MBoldyrev/kurs_mark/pic/ext4.JPG

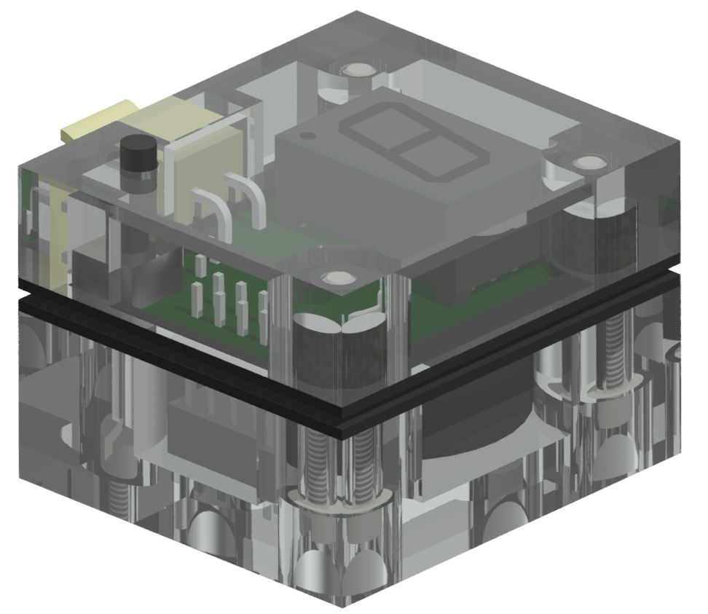
pic/ext4.JPG
