MBoldyrev/kurs_mark/pic/ext3.JPG

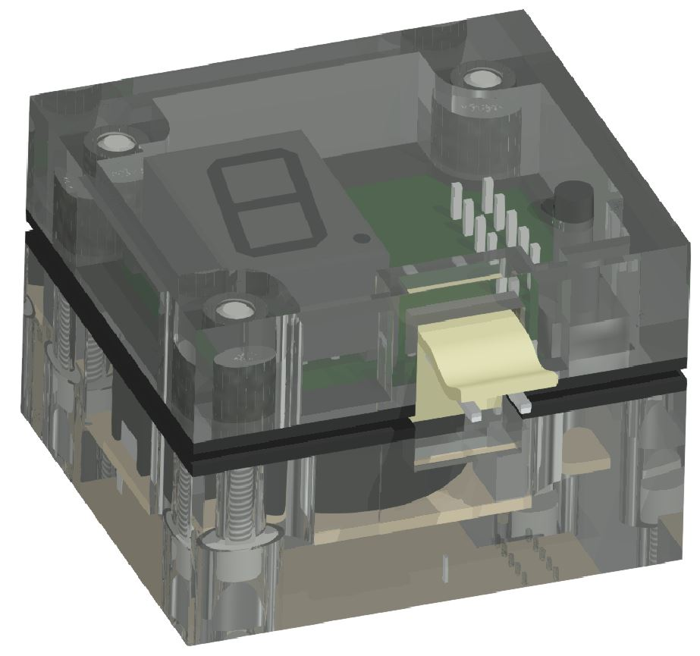
pic/ext3.JPG
