MBoldyrev/kurs_mark/PRINT/A4_bw/ext_spec.pdf

Изм. Лист | № докум. | Подп. | Дата
Разраб.
Пров.

Н.контр.
Утв.
Копировал | Формат А4

ИУ4.2205-12.03.01.00

Болдырев М.Д.
Маркелов В.В. | Наружный блок
Спецификация | МГТУ им. Н.Э.Баумана
группа ИУ4-73
Лит. | Лист | Листов

Инв. № подл. Подп. и дата Взам. инв. № Инв. № дубл. Подп. и дата Справ. № Перв. примен.

Формат
Зона
Поз.
Обозначение | Наименование | Примечание
| Документация

Кол.

ИУ4.2205-12.03.01.00СБ | Сборочный чертеж
ИУ4.2205-12.03.01.00ВО | Чертеж общего вида

Сборочные единицы

1 | ИУ4.2205-12.03.01.01.00 | Ячейка электронная для изготовления | 1
| | измерителя уровня топлива
2 | ИУ4.2205-12.03.01.02.00 | Батарейный держатель | 1
