MBoldyrev/kurs_mark/PRINT/A4_bw/PP1SB_spec.pdf

Изм. | Лист | № докум. | Подп. | Дата
| | Разраб. | Болдырев М.Д. Маркелов В.В. | | Ячейка электронная для изготовления измерителя уровня топлива Спецификация | Лит. | Лист | Листов
Пров. | | | | | | | 1 | 1

Н.контр.
Утв.
Копировал | Формат А4

ИУ4.2205.12-3.01.01

МГТУ им. Н.Э.Баумана
группа ИУ4-63

Инв. № подл. Подп. и дата Взам. инв. № Инв. № дубл. Подп. и дата Справ. № Перв. примен.

Формат
Зона
Поз.
Обозначение | Наименование | Примечание
| Документация

Кол.

ИУ4.2205.12-3.01.01.00СБ | Сборочный чертеж
ИУ4.2205.12-3.01.01.01 | Чертеж печатной платы
ИУ4.2205.12-3.01.01.00Э1 | Схема электрическая структурная
ИУ4.2205.12-3.01.01.00Э2 | Схема электрическая функциональная
ИУ4.2205.12-3.01.01.00Э3 | Схема электрическая принципиальная

Детали

1 | ИУ4.2205.12-3.01.01.01 | Печатная плата | 1
2 | R1...R7 | Bourns CRS0805JX200 | 7
3 | R8, R9 | Bourns CRS0805JX203 | 1
4 | R10 | Bourns CRS0805JX205 | 1
5 | R11 | Bourns CRS0805JX101 | 1
6 | MCU1 | AVR ATtiny24V-10SSU | 1
7 | DPY1 | BelLux Electronics BL-S56A-12UY | 1
8 | S1 | Switronic 0613HIM-130G-G | 1
9 | S2 | Bourns CRS0805JX000 | 1
10 | X1 | Connfly PLS-2 | 1
11 | X2 | Connfly PWL-2R | 1
12 | X3 | Connfly PLD-10 | 1
