MBoldyrev/kurs_mark/Inventor/plots/pdf/all_spec.pdf

Изм. Лист | № докум. | Подп. | Дата
Разраб.
Пров.

Н.контр.
Утв.
Копировал | Формат А4

ИУ4.2205-12.03.00.00

Болдырев М.Д.
Маркелов В.В. | Измеритель

## уровня топлива

Спецификация | МГТУ им. Н.Э.Баумана
группа ИУ4-73
Лит. | Лист | Листов

Инв. № подл. Подп. и дата Взам. инв. № Инв. № дубл. Подп. и дата Справ. № Перв. примен.

Формат
Зона
Поз.
Обозначение | Наименование | Примечание
| Документация

Кол.

ИУ4.2205.12-03.00.00СБ | Сборочный чертеж
ИУ4.2205.12-03.00.00ВО | Чертеж общего вида
ИУ4.2205.12-03.00.00 | РПЗ

Сборочные единицы

1 | ИУ4.2203.12-03.01.00 | Наружный блок
2 | ИУ4.2203.12-03.02.00 | Погружной датчик
