MBoldyrev/kurs_mark/Inventor/plots/pdf/corp_spec.pdf

Изм. Лист | № докум. | Подп. | Дата
| Разраб. | Болдырев М.Д. Маркелов В.В. | | Корпус наружного блока измерителя уровня топлива Спецификация | Лит. | Лист | Листов
| Пров.

Н.контр.
Утв.
Копировал | Формат А4

ИУ4.2205-12.03.01.00

МГТУ им. Н.Э.Баумана
группа ИУ4-73

Инв. № подл. Подп. и дата Взам. инв. № Инв. № дубл. Подп. и дата Справ. № Перв. примен.

Формат
Зона
Поз.
Обозначение | Наименование | Примечание
| Документация

Кол.

ИУ4.2205-12.03.01.00СБ | Сборочный чертеж

Детали

1 | ИУ4.2205-12.03.01.03 | Верхняя часть корпуса | 1
2 | ИУ4.2205-12.03.01.04 | Верхняя прокладка | 1
3 | ИУ4.2205-12.03.01.05 | Нижняя часть корпуса | 1
4 | ИУ4.2205-12.03.01.06 | Нижняя прокладка | 1

Стандартные изделия

5 | Винт М3х16 | 3 | ГОСТ 1491-80
