MBoldyrev/kurs_mark/Inventor/plots/pdf/ext_spec.pdf

Изм. Лист | № докум. | Подп. | Дата
Разраб.
Пров.

Н.контр.
Утв.
Копировал | Формат А4

ИУ4.2205-12.03.01.00

Болдырев М.Д.
Маркелов В.В. | Наружный блок
Спецификация | МГТУ им. Н.Э.Баумана
группа ИУ4-73
Лит. | Лист | Листов

Инв. № подл. Подп. и дата Взам. инв. № Инв. № дубл. Подп. и дата Справ. № Перв. примен.

Формат
Зона
Поз.
Обозначение | Наименование | Примечание
| Документация

Кол.

ИУ4.2205-12.03.01.00СБ | Сборочный чертеж
ИУ4.2205-12.03.01.00ВО | Чертеж общего вида

Сборочные единицы

1 | ИУ4.2205-12.03.01.01.00 | Плата печатная для изготовления 1
| | измерителя уровня топлива

Детали

2 | ИУ4.2205-12.03.01.02 | Батарейный держатель | 1
3 | ИУ4.2205-12.03.01.03 | Верхняя часть корпуса | 1
4 | ИУ4.2205-12.03.01.04 | Верхняя прокладка | 1
5 | ИУ4.2205-12.03.01.05 | Нижняя часть корпуса | 1
6 | ИУ4.2205-12.03.01.06 | Нижняя прокладка | 1

Стандартные изделия

7 | Винт М3х16 | 3 | ГОСТ 1491-80
