MBoldyrev/kurs_mark/RPZ_merged.pdf

Содержание

## Список условных обозначений, сокращений и терминов

SMD – surface mounted device (c англ. – прибор, монтируемый на поверхность);
ОПП – односторонняя печатная плата;
ПП | – печатная плата;
РЭА | – радио электронная аппаратура;
ТЗ | – техническое задание;
ТЭЗ | – типовой элемент замены;
ЭРЭ | – электрорадиоэлемент;
ЭС | – электронные средства;
Измеритель – «измеритель уровня топлива»

## 1. Введение

Работа посвящена разработке комплекта конструкторской документации для изготовления измерителя уровня топлива.

Бытовые устройства измерения уровня топлива широко представлены на рынке лишь в составе мототехники, в кмоплекте с которой они используются; тогда как отдельные универсальные устройства практически отсутствуют в продаже. Таким образм, актуальность данной работы обусловлена потребностью обладателей мототехники, некуомплектованной штатным датчиком топлива, легко получать данные о количестве топлива в баке.
Исходными данными для разработки являются электрическая принципиальная схема устройства и требования расширенного технического задания.
Целью разработки является создание работоспособного устройства с заданными характеристиками. Для ее достижения были поставлены следующие задачи:
- анализ исходных данных;
- выбор элементной базы, конструкции и материалов;
- проведение необходимых расчетов.

Результатом выполнения работы является разработанный комплект конструкторской документации для измерителя уровня топлива.

## 2. Расширенное техническое задание

### 2.1 Наименование и область применения изделия

Наименование прибора: «измеритель уровня топлива». В сферу применения разрабатываемого измерителя уровня топлива входят мотоциклы, не оборудованные штатным измерителем уровня топлива, а так же практически вся мелкая землеобрабатывающая техника.

### 2.2 Основание для разработки

Основанием для разработки устройства «измеритель уровня топлива» является задание на курсовой проект по курсу «Конструкторское проектирование ЭС».

### 2.3 Технические требования

2.3.1 Технические параметры.

В табл. 2.3.1.1 представлены технические характеристики обнаружителя:

Таблица 2.3.1.1 - Технические параметры.
Наименование параметра | Значение
Напряжение питания, В | 2..4
Потребляемый ток в активном режиме не более, мА | 200
Потребляемый ток в режиме ожидания не более, мА | 0,3
Размер печатной платы не более, мм | 40х40
Габаритные размеры электронного блока не более, мм | 60х60х40
Габаритные размеры датчика не более, мм | 250х50х50
Масса (вместе с элементами питания) не более, г | 100
Точность измерения уровня топлива не менее, % | 5

### 2.3.2 Принцип работы устройства

Принцип действия прибора основан на изменении ёмкости конденсатора при изменении объемного соотношения заполняющих его воздуха и топлива. В качестве датчика используется открытый конденсатор, состоящий из двух пластин, между которых может протекать топливо. Емкость такого конденсатора, полностью погруженного в топливо, будет в среднем в два раза больше, чем на воздухе. Измерение ёмкости конденсатора датчика производится засеканием времени, за которое он зарядится до некоторого напряжения через резистор.

### 2.3.3 Требования к надежности

Время работы прибора 1000 часов с гарантированной надежностью Рг = 0,95 в соответствии с ГОСТ 27.002-89.
Гарантийный срок эксплуатации - 36 месяцев со дня ввода устройства в эксплуатацию. Гарантийный срок хранения - 12 месяцев со дня изготовления устройства.

### 2.3.4 Требования к конструкции

Разрабатываемое устройство выполняется в виде одноплатного ТЭЗ, заключенного в пластмассовый корпус и датчика, подключенного к плате проводом.

### 2.3.5 Условия эксплуатации и группа жесткости

Измеритель уровня топлива должен соответствовать требованиям технического задания при воздействии следующих условий:
- напряжение питания прибора: постоянное 2..4В;
- вибрация до 100 Гц с ускорением до 10g;
- климатическое исполнение: УХЛ 3.1
- относительная влажность воздуха: 85% при температуре 25⁰С;
- температура окружающей среды: -20×С…+70°С (для ячейки) и -55°С…+125°С (для датчика);
- атмосферное давление 10⁵ Па.
Согласно ГОСТ 23752-79 для устройства определяется 2-ая группа жесткости.

### 2.3.6 Требования к транспортировке, хранению и маркировке

В силу своего предназначения, а, следовательно, конструкции, устройство относится к классу транспортируемой ЭА. Измеритель уровня топлива должен соответствовать требованиям технического задания при воздействии следующих условий при транспортировке:
- многократные удары: 10g длительностью 20 мс;
- температура окружающей среды: от -20⁰С до +45⁰С;
- вибрация до 200 Гц с ускорением до 20g;
- относительная влажность воздуха: 85% при температуре 25⁰С;
- атмосферное давление 10⁵ Па;
Измеритель уровня топлива при хранении должен быть уложен в поролоновую укладку внутри упаковки из гофрированного картона по ГОСТ 9142-90. Хранение осуществлять на стеллажах в сухом помещении (в соответствии с условиями хранения по ГОСТ 15150-69). В помещении для хранения не должно быть паров кислот и щелочей, а также газов, вызывающих коррозию и разрушающих изоляцию (условия хранения аппаратуры 5 группы по ГОСТ 15150-69).

Для маркировки прибора используется наклейка, содержащая наименование прибора «Датчик уровня топлива». Наклейка наносится на фронтальную часть корпуса.

### 2.3.7 Требования к материалам и комплектующим изделиям

Используемые материалы и готовые изделия на момент их использования должны иметь сроки хранения и сроки эксплуатации, соответствующие техническому заданию. Готвое изделие должно быть устойчиво к действию бензина марок АИ-91, АИ-93, АИ-95 по ГОСТ 2084-77, а также дизельного топлива марок Л и З по ГОСТ 305-82.

### 2.3.8 Требования к патентной чистоте

Патентная чистота должна быть обеспечена в отношении Российской Федерации и стран СНГ.

### 2.4 Экономические показатели

Для выпуска прибора "измеритель уровня топлива" установлен мелкосерийный тип производства с годовой программой выпуска 200 шт.

### 2.5 Порядок испытаний

Объект испытаний – разрабатываемый измеритель уровня топлива.
Цель испытаний – проверка соответствия характеристик разработанного устройства функциональным и отдельным иным видам требований, изложенным в техническом задании. Количественные характеристики, подлежащие испытанию:
1) сила тока питания устройства в активном режиме и режиме ожидания;
2) точность измерения уровня топлива.
Качественные характеристики, подлежащие испытанию:
1) качество визуального отображения температуры на индикаторе.

### Выводы

Разработанное расширенное ТЗ полностью удовлетворяет требованиям ГОСТ 25123-82, учитывающий порядок построения, изложения и оформления технического задания. В данном разделе были перечислены технические параметры измерителя уровня топлива; изложен принцип работы устройства; были разработаны требования к надежности, эксплуатации, транспортировке, хранению, маркировке, требования к материалам и компонентам, требования к конструкции и к патентной чистоте. В экономических показателях была дана годовая программа выпуска прибора, в заключение был приведен порядок испытаний прибора на соответствие характеристик требованиям, перечисленным в ТЗ.

## 3. Схемотехническая часть

### 3.1 Анализ электрической структурной схемы устройства

Устройство измеритель уровня топлива можно структурно разделить на несколько основных частей:
- Погружная часть измерителя;
- Наружная часть измерителя;
- Индикация;
- Кнопка управления.
Электрическая структурная схема устройства (ИУ4.02.01.00 Э1) представлена на рисунке 3.1.1:

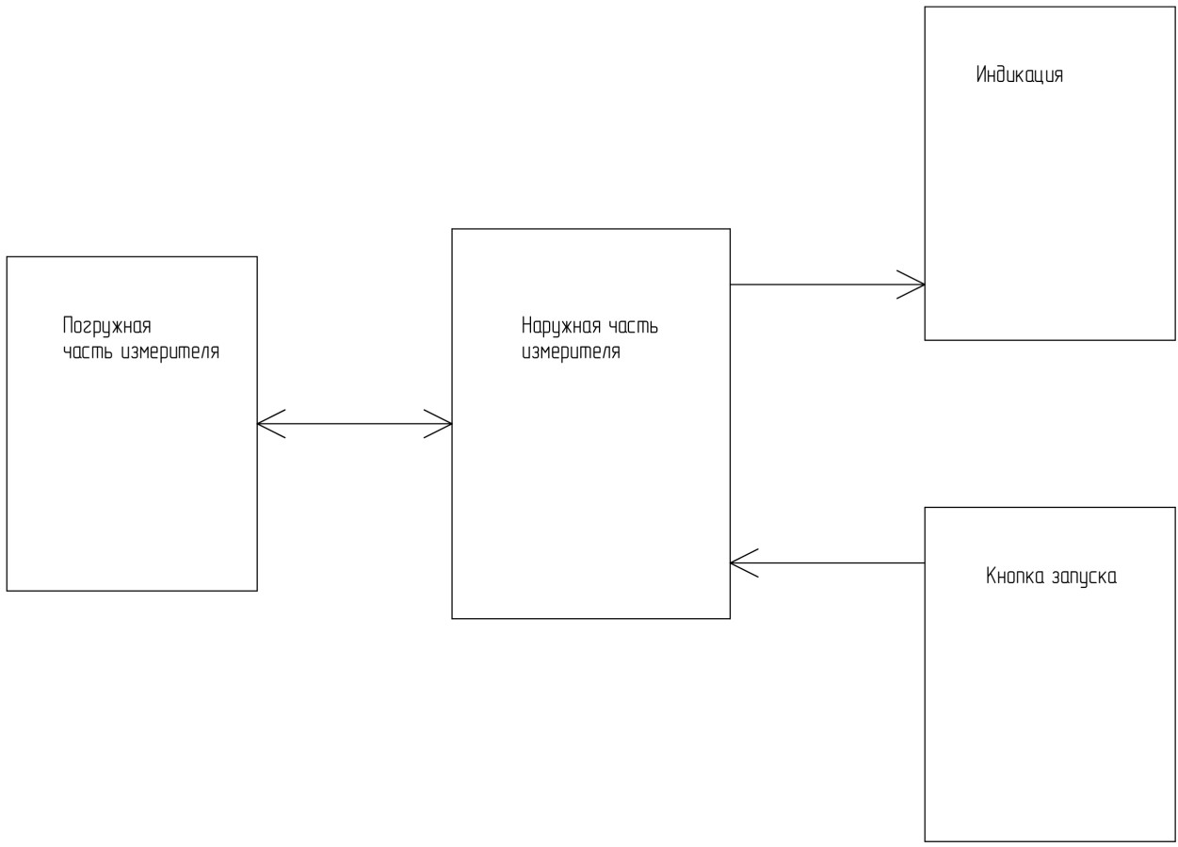
[picture p48: figure]

Рисунок 3.1.1. Схема электрическая структурная устройства

Погружная часть измерителья представляет собой открытый конденсатор, сообщающийся с наружной частью посредством проводов. Кнопка запуска и индикация служат для взаимодействия пользователя с устройством.

### 3.2 Анализ электрической функциональной схемы устройства

Устройство измеритель уровня топлива делится на следующие функциональные составляющие:
- Микроконтроллер;
- Генератор опорного напряжения;
- Датчик уровня топлива;
- Семисегментный индикатор.
Электрическая функциональная схема устройства (ИУ4.02.01.00 Э2) представлена на рисунке 3.2.1.

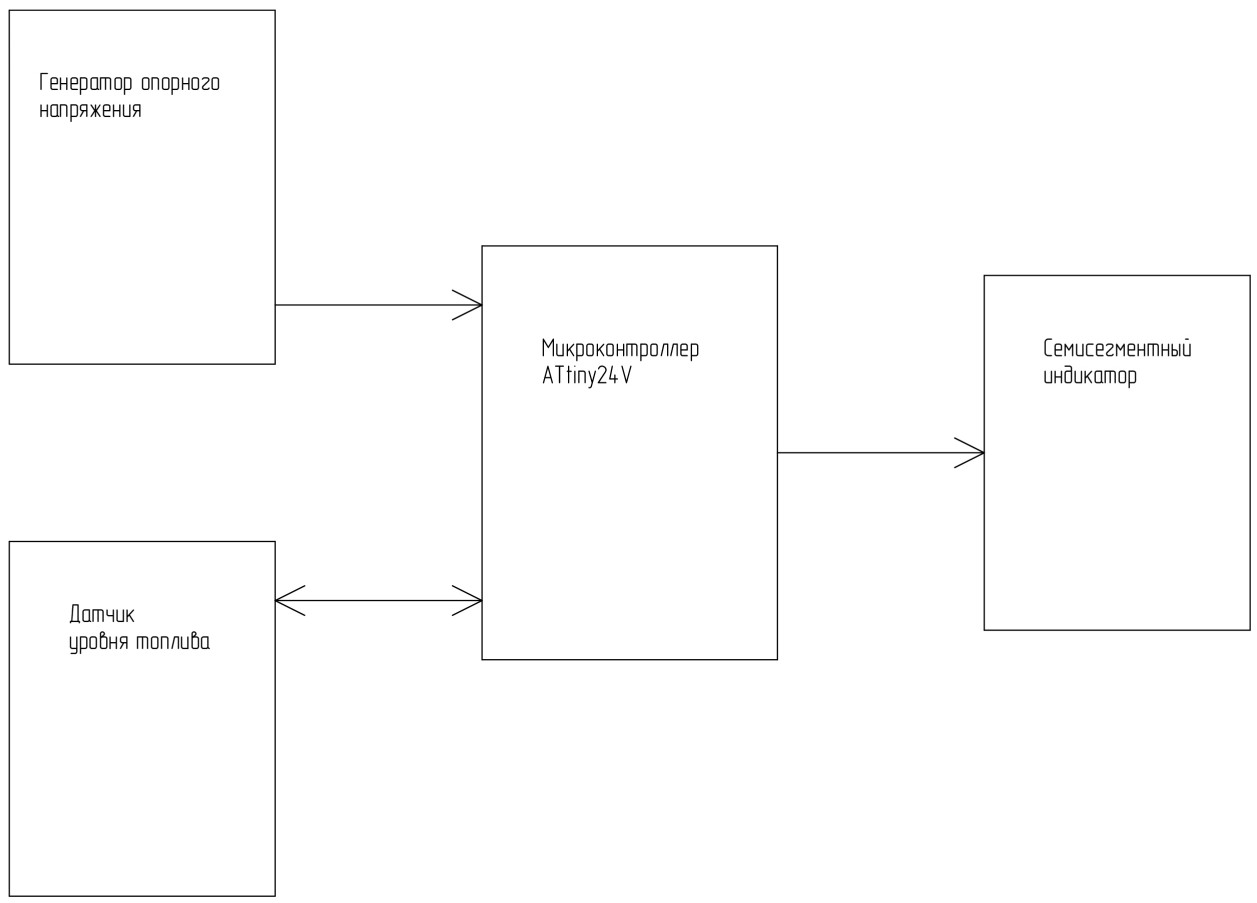
[picture p49: figure]

Рисунок 3.1.2. Схема электрическая функциональная устройства

По нажатию кнопки микроконтроллер начинает замер скорости разрядки конденсатора, после чего вычисляет относительную заполненность бака и выводит результат на семисегментный индикатор.

### 3.3 Анализ электрической принципиальной схемы устройства

Электрическая принципиальная схема (ИУ4.02.01.00 Э3) представлена на рисунке 3.3.1.

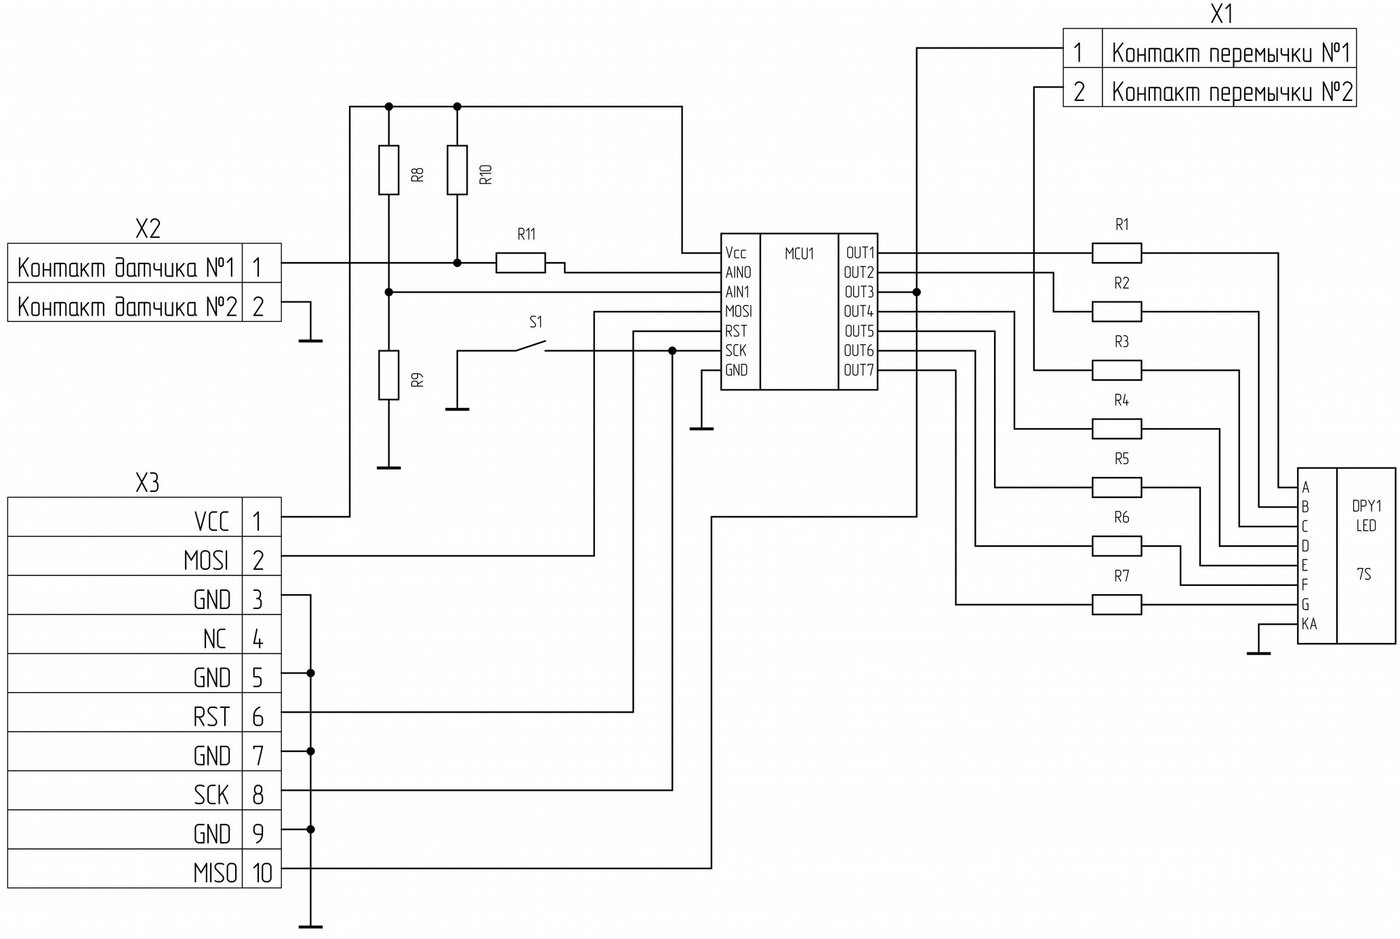
[picture p50: figure]

Рисунок 3.3.1. Схема электрическая принципиальная устройства

Программирование и питание схемы осуществляется посредством разъема X3. Линия тактовой частоты используется также для подключения кнопки, которая не используется при программировании контроллера. Также линия программирования MISO используется вне режима программирования для подключения одного из светодиодов индикации посредством перемычки. Светодиоды индикации подключены через токоограничивающие резисторы. На резисторах R8, R9 собран делитель для получения опорного напряжения компаратора. К разъему X2 подключается внешний датчик. Его конденсатор подключен к выводу микроконтроллера и к напряжению питания через два резистора R10, R11, на несколько порядков отличающихся по номиналу. Через один из них происходит изначальная быстрая разрядка, а через другой — медленная зарядка конденсатора.

### 3.4 Функциональное предназначение ЭРЭ

В качестве микроконтроллера MCU1 выбрана микросхема ATtiny24V фирмы Atmel. Резисторы R1..R7 ограничивают ток через светодиоды индикатора DPY1. Резисторы R8, R9 образуют делитель для получения опорного напряжения компаратора. Резистор R10 служит для медленной зарядки конденсатора датчика, а резистор R11 – для быстрой разрядки и измерения напряжения на конденсаторе. Ключ S1 используется для управления работой устройства. Индикатор DPY1 используется для вывода информации. Перемычка разъема X1 используется для переключения между режимами программирования и штатной работы устройства.

### 3.5 Анализ элементной базы

В целях удешевления конструкции и уменьшения габаритных размеров устройства все резисторы выбраны типа SMD0805. Микроконтроллер выбран в корпусе SO14.
Разъем датчика выбран угловой с фиксирующей защелкой для удобства монтажа и демонтажа. Разъемы X1, X3 выбраны прямыми штыревыми для уменьшения габаритов. Кнопка S1 - тактовая с высотой, превышающей высоту имеющихся на плате разъемов на толщину верхней крышки корпуса.
Таким образом, элементная база прибора состоит из недорогих надежных компонентов.
Эксплуатационные | параметры | компонентов | соответствуют | условиям | эксплуатации,
оговоренным в ТЗ.
В табл. 3.5.1 приведён перечень основных элементов устройства и их характеристик.

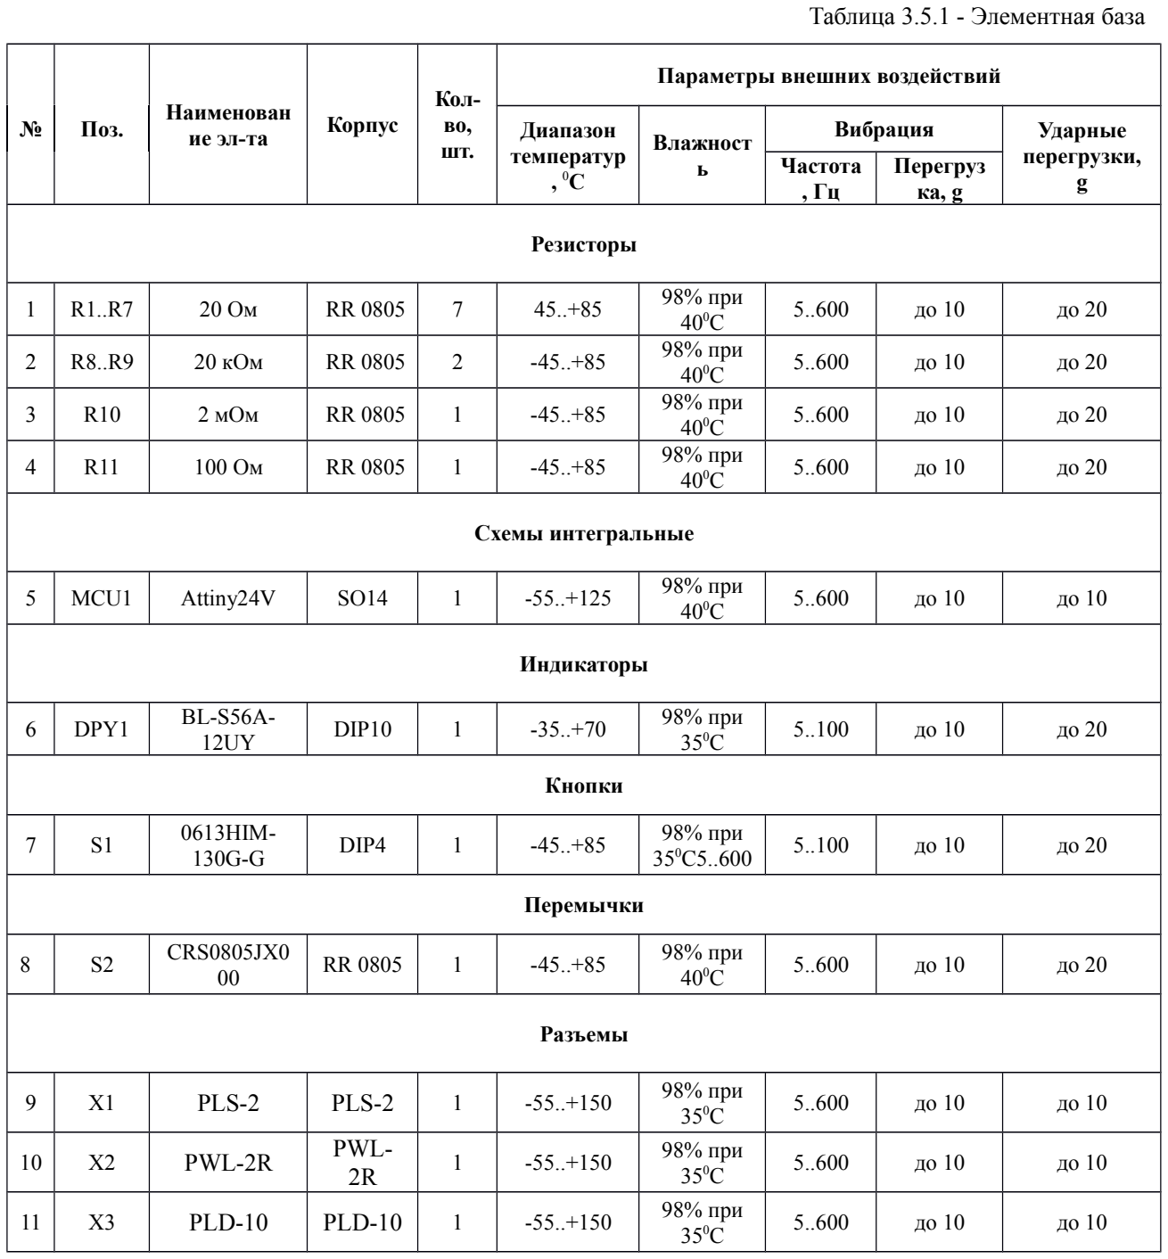
[picture p51: figure]
Таблица 3.5.1 - Элементная база; Наименован ие эл-та; Корпус; Кол- во, шт.; Параметры внешних воздействий; Поз.; Диапазон; температур ,; Влажност ь; Вибрация; Ударные; перегрузки, g; Частота , Гц; Перегруз ка, g; Резисторы; 98% при; 20 кОм; 2 мОм; Схемы интегральные; MCU1; Attiny24V; Индикаторы; DPY1; DIP10; 98% при 35⁰С; Кнопки; 0613HIM-; DIP4; Перемычки; CRS0805JX0; Разъемы; PLS-2; PWL-2R; PWL-; PLD-10

С учетом анализа элементной базы нормальные условия для устройства:
- диапазон температур: -35…+70⁰С;
- относительная влажность воздуха: 98% при температуре 25⁰С;
- вибрация до 400 Гц с ускорением до 10g;
- ударные перегрузки: до 10g.
Из анализа элементной базы можно сделать вывод, что данный элементный состав устройства обеспечивает его функционирование в условиях, описанных в ТЗ (температура хранения/эксплуатации, влажность и т.п.).

### 3.6 Описание работы схемы с помощью временных диаграмм

Моделирование работы устройства

1. Расчет емкости конденсатора датчика.

Датчик представляет собой открытый конденсатор, собранный из двух параллельно подключенных конденсаторов. Данная схема использована для увеличения емкости конденсатора и, следовательно, чувствительности датчика, при незначительном увеличении его габаритов в сравнении с вариантом, изготовленным из одного конденсатора. Стенки конденсаторов образуют пластины из стеклотекстолита фольгированного СТФ-1-15 шириной 40 мм и длиной 250 мм. Зазор между пластинами выбран наименьшим, при котором поверхностное натяжение бензина не препятствует его вытеканию из конденсатора, и составляет 1 мм. Таким образом, расчетная емкость полученного конденсатора на воздухе составляет

Св=2 * ε0

* εв

*

a* b
d

≈ 177 пФ ,

где ε0

– электрическая постоянная, εв

– диэлектрическая проницаемость воздуха, a и b –

ширина и длина пластин соответственно, d – зазор между пластинами. Емкость конденсатора, полностью погруженного в бензин АИ-92 составляет

СА И−92=Св

*

ε А И−92
εв

≈ 407 пФ ,

где ε А И−92

– диэлектрическая проницаемость бензина АИ-92.

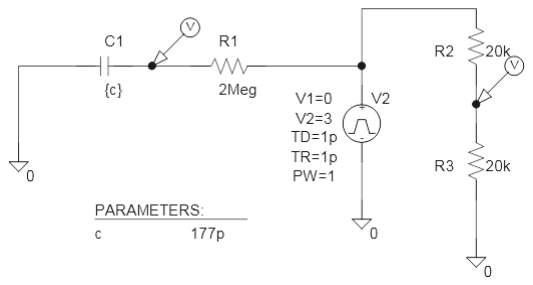
[picture p52: figure]

Рисунок 3.6.1 – схема моделирования датчика

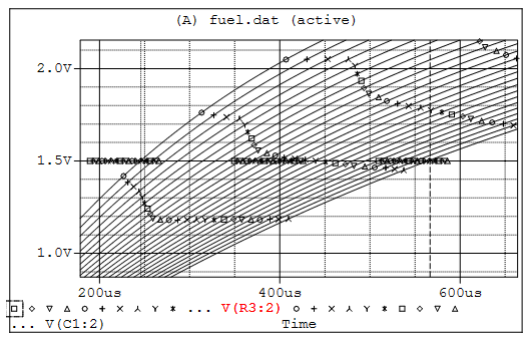
[picture p53: figure]

а | б
Рисунок 3.6.2 – Графики заряда конденсатора.

На рисунке 3.6.1 представлена схема моделирования измерительной части устройства в программе PSpice. Конденсатор С1 моделирует погружной датчик. На рисунке 3.6.2(а) представлен график напряжения на конденсаторе в сравнении с опорным напряжением на делителе во времени. Курсор установлен на пересечении кривых в момент времени 245 мкс. На рисунке 3.6.2(б) показано, как изменяется время заряда конденсатора С1 до опорного напряжения при последовательном изменении его емкости на 10 пФ.

Полученные результаты измерения времени заряда конденсатора до опорного напряжения составляют 245 мкс для пустого бака и 565 мкс для заполненного бензином АИ-92. Для повышения точности измерения целесообразно выбрать достаточно большую частоту работы контроллера, что гарантирует большую частоту дискретизации аналогового сигнала датчика и, следовательно, более точный замер времени. Выбранная мной частота составляет 1 МГц. Пересчет времени заряда конденсатора для полученных выше значений даст 245 и 565 тактов для пустого и полного бака соответственно. Это значит, что в идеальных условиях я получу 320 градаций наполненности бака. Такая точность на порядок превышает необходимую, поскольку индикация будет производиться всего 12 символами, соответствующими 12 градациям наполненности бака.
ВЫВОД

Результаты моделирования подтверждают работоспособность выбранной схемы для измерения уровня топлива с заданной точностью.

## 4. Конструкторская часть

### 4.1 Предварительная разработка и компоновка конструкции устройства

Компоновка электронного устройства - процесс размещения ЭРЭ и деталей РЭА на плоскости или в пространстве с определением основных геометрических форм и размеров. При компоновке должны быть учтены требования оптимальных функциональных связей, их устойчивость и стабильность, требования прочности и жесткости, помехозащищенности и нормального теплового режима, требования технологичности, эргономики, удобства эксплуатации и ремонта. Размещение комплектующих элементов должно обеспечивать равномерное и максимальное заполнение конструктивного объема с удобным доступом для осмотра, ремонта и замены.
Ввиду малого числа элементов внешнего блока измерителя, а также соображений простоты и дешевизны изготовления, схема внешнего блока реализуется на одной плате. Сам внешний блок реализуется в виде пластикового корпуса, в котором расположена плата, выведен наружу разъем подключения погружного датчика и элемент пользовательского интерфейса — кнопка.

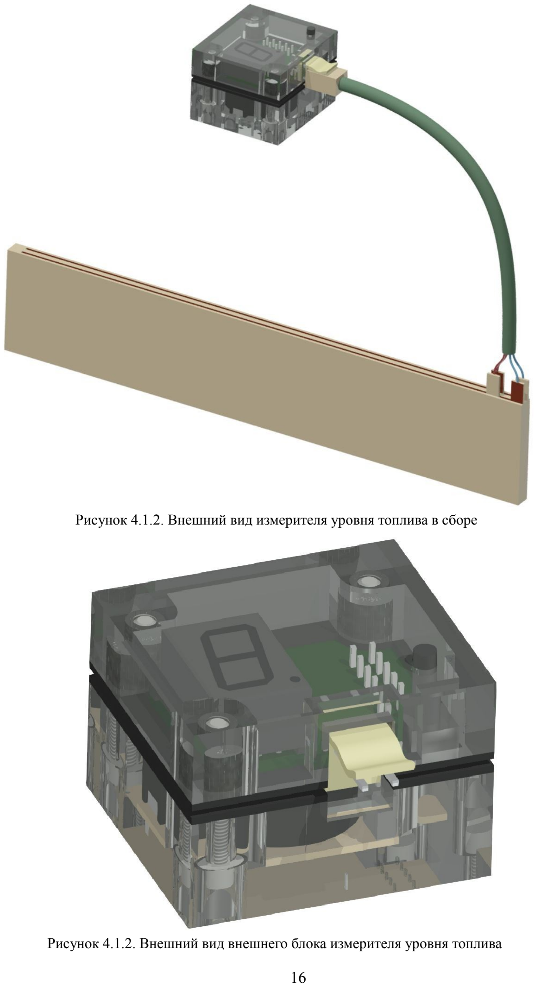
[picture p54: page 16]

Рисунок 4.1.2. Внешний вид измерителя уровня топлива в сборе

Рисунок 4.1.2. Внешний вид внешнего блока измерителя уровня топлива

### 4.2 Описание конструкции блока

Измеритель уровня топлива представляет собой устройство, состоящее из погружного датчика и наружного блока. Погружной датчик предназначен для монтажа внутрь бензобака. Наружный блок предназначен для монтажа на поверхность бензобака возле горловины. Блоки стыкуются между собой при помощи кабеля.
Конструкция устройства представлена на сборочном чертеже устройства (ИУ4.2205-12.00.00 СБ), приведенном на рисунке 4.2.1.

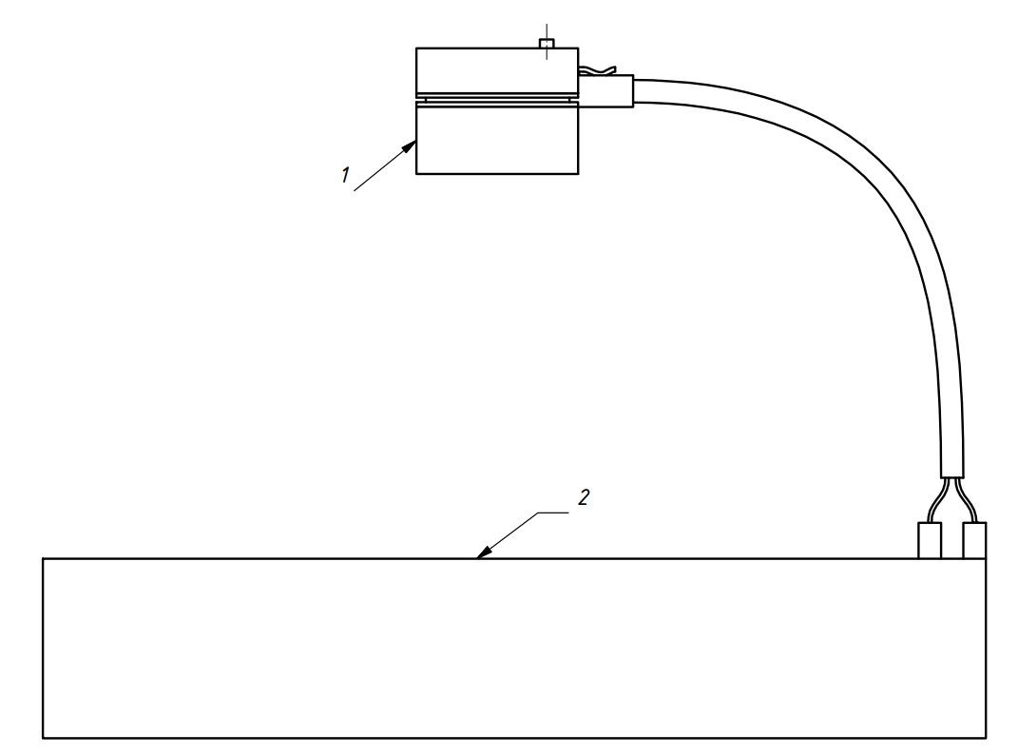
[picture p55: figure]

Рисунок 4.2.1 - Сборочный состав устройства

Сборочный чертёж внешней части устройства представлен на рисунке 4.2.2. Основой его конструкции является пластиковый корпус, состоящий из нижней и верхней части. Для защиты от попадания внутрь корпуса топлива и воды применены резиновые прокладки, устанавливаемые между платой и частями корпуса.

Для корректной установки элементов питания (2 батареек типа ААА) поз. 11 в нижней части корпуса применяется гравировка на пластмассе с указанием полярности установки батареек.

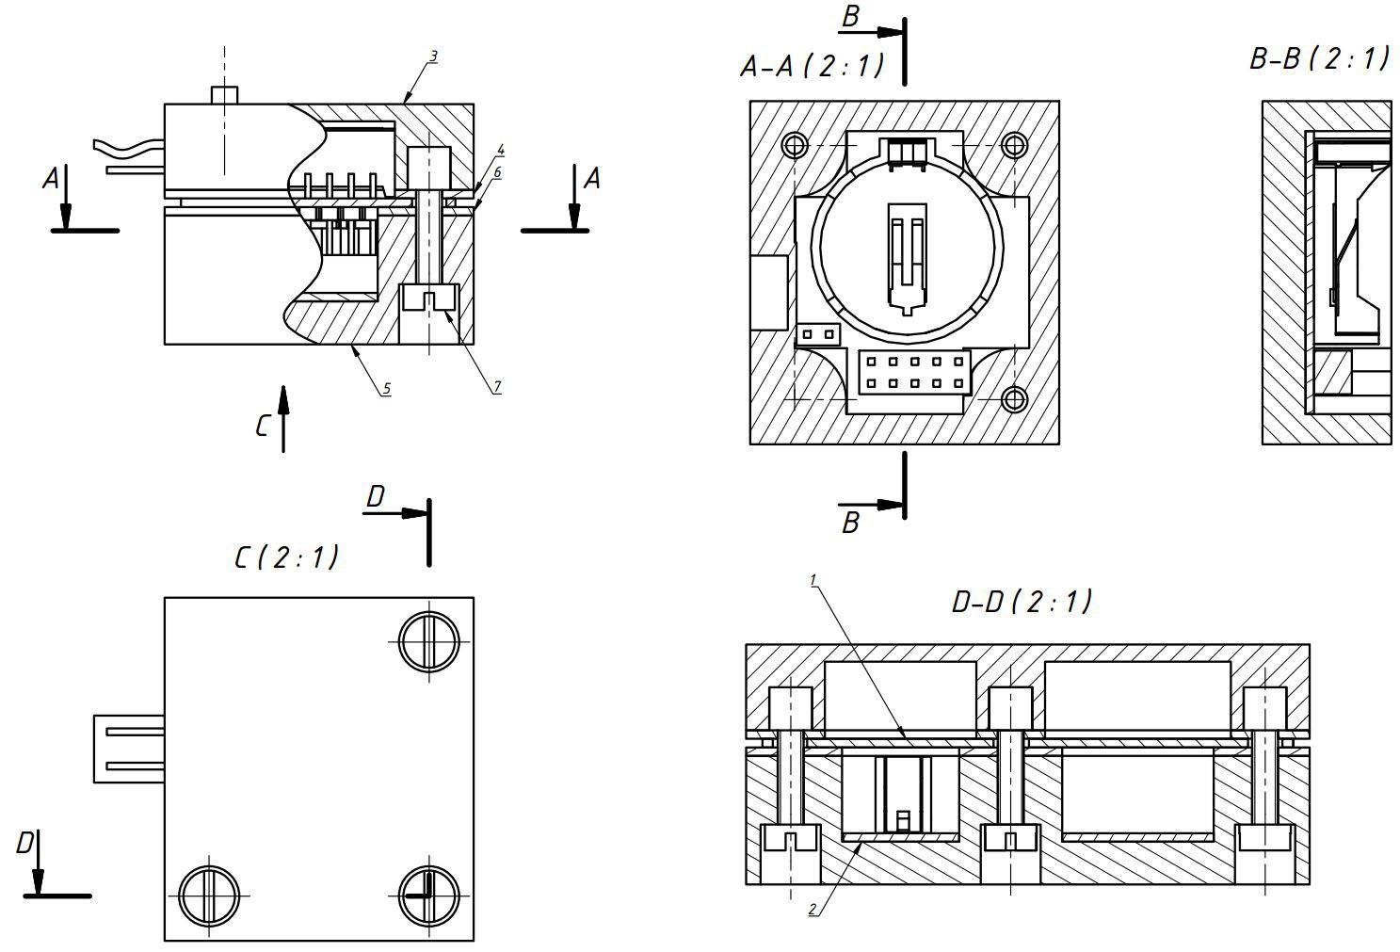
[picture p56: figure]

Рисунок 4.2.2. Нижняя часть корпуса

В нижнюю часть корпуса прибора устанавливается электронная ячейка (поз. 2), которая приклеивается к нижней стенке корпуса. Затем устанавливается нижняя прокладка (поз. 6), электронная ячейка (поз. 1), верхняя прокладка (поз. 4) и верхняя часть корпуса (поз. 3). Все стягивается тремя винтами (поз. 7).

### 4.3 Анализ и выбор конструкции и материала ячейки

По количеству слоёв проводящего материала ПП бывают односторонние, двусторонние и многослойные. Поскольку форма и количество ЭРЭ позволяет получить плату с габаритными размерами, удовлетворяющими ТЗ при использовании односторонней печатной платы, использоваться будет односторонняя ПП.
ПП разделяют по гибкости на жёсткие и гибкие. Поскольку плата с элементами являет собой ячейку ТЭЗ и должна выдерживать ударные и вибрационные нагрузки, используется жесткая печатная плата.
Исходя из вышеприведенных решений, а также соображений экономичности выбран материал ПП: СФ-1-35Г-1 II кл. по ГОСТ 10316-78 — гетинакс толщиной 1 мм, облицованный с одной стороны медной электролитической гальваностойкой фольгой толщиной 35 мкм. Готовая плата соответствует требованиям ГОСТ 23752-79 и ГОСТ 23751-86, относится к 1-ому классу жесткости и 3-ему класс точности.
Шаг координатной сетки 0,635 мм.
Выбранный материал имеет следующие параметры (характеристики указаны для состояния материала после выдержки в условиях 96 ч/40°С/93%):
1) поверхностное электрическое сопротивление (Ом): 5·10¹⁰;
2) удельное объемное электрическое сопротивление (Ом х м): 1·10¹⁰;
3) тангенс угла диэлектрических потерь при частоте 1 МГц: 0,035;
4) диэлектрическая проницаемость при частоте 1МГц: 5,5;
5) время устойчивости к воздействию теплового удара при t= 260оС (с): 30. Адресация ЭРЭ выполняется белой эпоксидной маркировочной краской МКЭЧ ОСТ 4ГО.054.205 У1 шрифтом 2 по ТУ 15-203.200-95.

### 4.4 Анализ и выбор материала корпуса прибора

Согласно требованиям ТЗ внешняя часть измерителя монтируется вне бензобака и должна быть защищена от механических и химических воздействий извне. Этой цели удовлетворяет корпус, представленный на рисунке 4.2.2. Данный корпус изготовлен из полиамида 610 литьевого ГОСТ 10589-87 - прозрачной пластмассы, стойкой к воздействию горюче-смазочных материалов при требуемом по ТЗ диапазоне температур и влажности. Корпус является закрытым, негерметичным. Корпус выполнен литьем пластмассы под давлением. Прозрачность материала корпуса позволяет избежать необходимости применения вставок других материалов для изготовления прозрачного окна для наблюдения показаний индикатора. Это в свою очередь избавляет конструкцию от напряжений, связанных с различной упругостью и температурным расширением материалов составных частей. Также прозрачный корпус позволяет легко проверять наличие на месте питающего элемента и диагностировать некоторые возможные неисправности.
Выбранный материал имеет следующие параметры:
- | Плотность при 23 °С: | 1,1 г/см3;
- | Прочность при растяжении: | 130 МПа
- | Прочность при изгибе: | 90 МПа
- | Модуль упругости: | 7000-9000 МПа
- | Твердость по Бриннелю, МПА: | 100-150
- | Температура начала деформации при 1,82 МПа: | 190-200 °С
- | Температура начала деформации при 0,45 МПа: | 200-205 °С
- | Водопоглощение за 24 ч в воде при 23 °С: | 0,3 %
- | Усадка при 23 °С: | 0,8-1,5 %
- | рабочая температура: | -40..+90 °C.
- удельное электрическое сопротивление (поверхностное):10¹² Ом/см;
- | удельное электрическое сопротивление (объёмное): | 10¹² Ом/см;

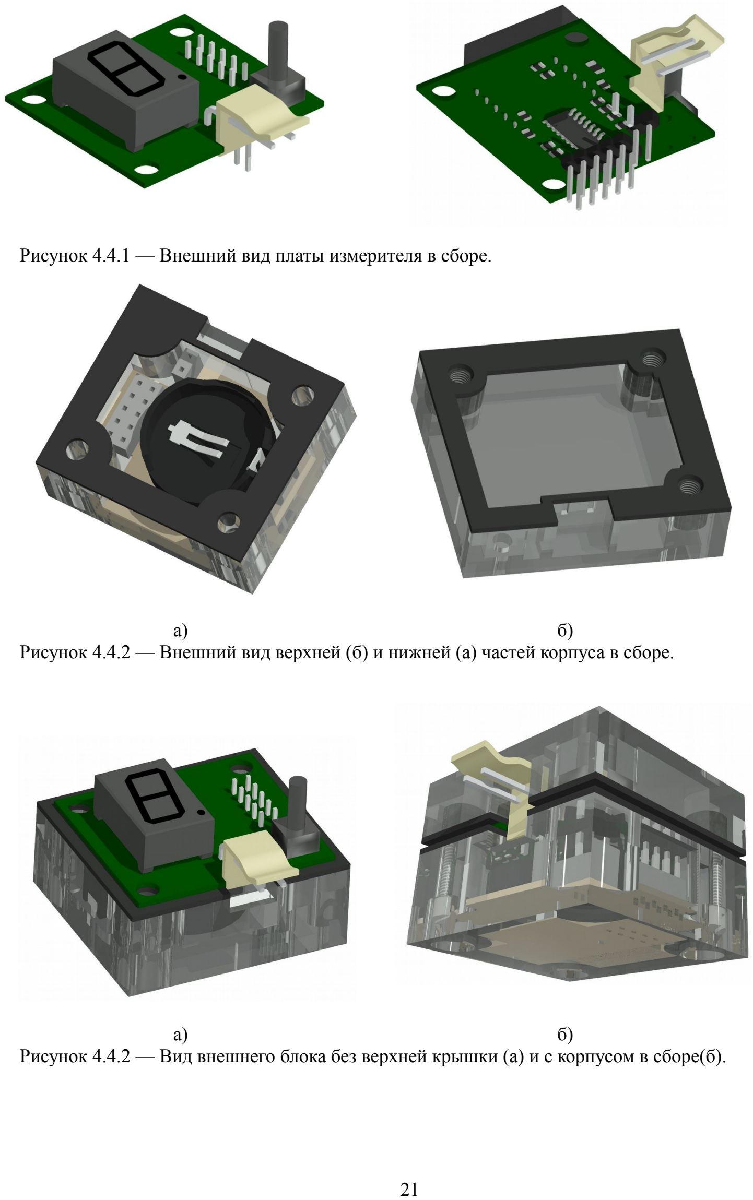
[picture p57: page 21]

Рисунок 4.4.1 — Внешний вид платы измерителя в сборе.

а) | б)
Рисунок 4.4.2 — Внешний вид верхней (б) и нижней (а) частей корпуса в сборе.
а) | б)
Рисунок 4.4.2 — Вид внешнего блока без верхней крышки (а) и с корпусом в сборе(б).

### 4.4 Выбор соединений

В данном устройстве применены следующие виды соединений:
а) Винтовое соединение. Винтовое соединение применяется для разъемного соединения обеих частей корпуса и платы. Винты могут быть откручены пользователем устройства для установки или замены питающего элемента.
б) Соединение заформовкой. Заформовка применяется для фиксации бонок в верхней части корпуса. Данное соединение должно быть неразборным и достаточно надёжным, что может быть обеспеченно данным видом соединения.
в) Соединение пайкой. Данное соединение применяется как для механического закрепления ЭРЭ на плате, так и для создания электрического контакта между выводами ЭРЭ и проводящим рисунком ПП.
г) Соединение разъёмное штыревое. Применено для соединения погружного датчика с внешним блоком. Обеспечивает электричемкий контакт и механическую фиксацию шнура в разъёме корпуса.

### 4.5 Обеспечение устойчивости к внешним воздействиям

### 4.5.1 Тепловое воздействие

Для выбора способа защиты от перегрева необходимо рассчитать суммарную рассеиваемую мощность устройства. Полная рассеиваемая мощность есть сумма мощностей рассеивания всех ЭРЭ:

(4.1)
Расчет максимальных рассеиваемых мощностей ЭРЭ:
а) резисторы R1..R7 и индикатор DPY1 – при постоянно включенных 7 сегментах индикатора:
PR 1..7, DPY1=7⋅(5В⋅4 мА)=140 мВт б) резисторы R8..R9:

PR8. .9=2⋅(
(2,5В)

2

20 кОм ) =0,15 мВт

Мощность, рассеиваемая на этих резисторах, мала в сравнении с остальными, поэтому далее она не учитывается.
в) резисторы R10..R7 – при максимальной емкости конденсатора (при использовании бензина АИ95 - 420 пФ):

PR10..11=2⋅

420пФ⋅3 В
565 мкс

=4,5 мВт

г) микроконтроллер MCU1 при непрерывном измерении:
PMCU 1=45 мВт
Результаты расчета максимальных рассеиваемых мощностей для выше приведенных ЭРЭ представлены в таблице 4.5.1.
Таблица 4.5.1 – Мощность, рассеиваемая ЭРЭ

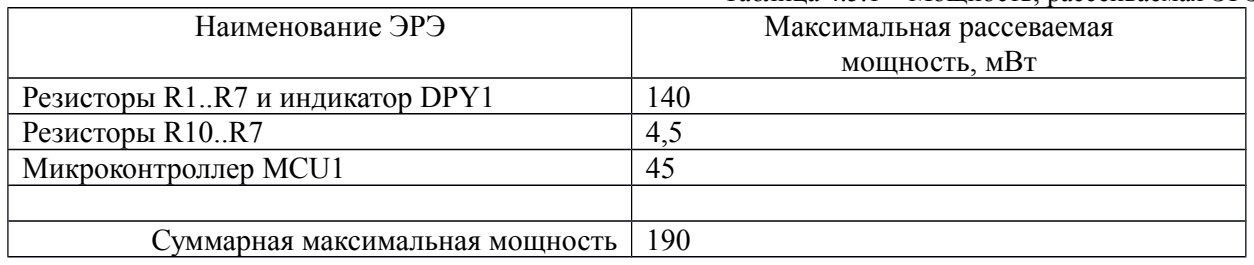
[picture p58: figure]
Наименование ЭРЭ; Максимальная рассеваемая; мощность, мВт; Резисторы R1..R7 и индикатор DPY1; Резисторы R10..R7; Микроконтроллер MCU1; Суммарная максимальная мощность 190

Конденсаторы и печатные проводники тепло практически не рассеивают и в расчете они не учтены.
Расчет показал, что в условиях, обеспечивающих максимально возможную рассеиваемую мощность, ее значение составляет порядка 0,2 Вт. Следовательно, устройство не требует специальной системы охлаждения. Теплонагруженные элементы охлаждаются за счет естественной конвекции воздуха, теплопроводности печатной платы и корпуса и излучения. Все элементы схемы, а также материал корпуса были подобраны в соответствии с ограничениями ТЗ (рабочая температура и температура хранения до 45°С).

### 4.5.2 Охлаждение

Устройство защищено от переохлаждения правильным согласованием материалов, из которых изготовлена печатная плата и элементы корпуса.
Все элементы схемы, а также материал корпуса были подобраны в соответствии с ограничениями ТЗ (рабочая температура до -10°С, температура хранения до -20°С), чем обеспечивается защита от холода.

### 4.5.3 Вибрация и удары

Минимизация искривлений печатных плат обеспечена равномерным распределением нагрузки на них и высокой плотностью установки компонентов.
Все элементы схемы, а также материал корпуса были подобраны в соответствии с ограничениями ТЗ на возможные вибрации и удары.

### 4.5.4 Влажность

Материал корпуса подобран в соответствии с требованиями ТЗ по необходимому сопротивлению воздействия влажности.
Поскольку корпус не герметичен, его содержимое — плата и ЭРЭ — нуждаются в самостоятельном обеспечении сопротивления влажности. С этой целью собранная ячейка полностью покрывается лаком УР-231 (ТУ 6-21-14-90), который подходит под требования ТЗ.

### 4.5.5 Электромагнитные помехи

Погружной датчик представляет собой открытый конденсатор, который располагается внутри металлического бензобака, являющегося хорошим электромагнитным экраном. Благодаря этому возможные наводки на конденсатор датчика становятся незначительными. Шнур, соединяющий конденсатор датчика с внешним блоком, содержит два проводника, идущих близко друг к другу, что позволяет игнорировать возможные наводки ввиду того, что наведенные помехи будут одинаковы на обоих проводниках, и не повлияют на разность напряжений и токов в них.
Плата внешнего блока имеет малые габаритные размеры и не содержит индуктивных элементов, благодаря чему воздействие возможных помех не внесет ощутимых изменений в работу устройства.

### 4.6 Расчеты

### 4.6.1 Расчет ПП

### 4.6.1.1 Расчет печатного монтажа

Разрабатываемая плата относится к 2 классу точности. Это позволяет изготавливать плату устройства на наиболее распространенном оборудовании без затрат на избыточную точность.
Выбранному классу точности при вышеприведенных параметрах платы соответствуют следующие величины:
t = 0,25 мм — минимальная ширина проводников;
S = 0,25 мм — минимальная ширина зазора между проводниками;
b = 0,2 мм — гарантированный поясок;
Δt = 0,10 мм — допуск на ширину проводника;
Δdдо 1 = 0,10 мм — допуск на диаметр отверстя до 1 мм;
Δdсв.1 = 0,15 мм — допуск на диаметр отверстя свыше 1 мм;

Разрабатываетмая плата — односторонняя и не содержит металлизированных отверстий. Исходя из принятых параметров платы целесообразно назначить химический способ получения проводящего рисунка.

Минимальный диаметр монтажного отверстия определяется из соотношения:

d м.о.≥dв+Δ+δд
(4.2)
где dв - диаметр вывода ЭРЭ, микросхемы или соединителя,
Δ - зазор между выводом и монтажным отверстием,
δд - максимальная погрешность диаметра отверстия.
Подставив имеющиеся значения в (4.2), получим минимальные диаметры монтажных отверстий для каждого значения диаметра вывода, представленные в таблице 4.6.1.
Таблица 4.6.1.1.1 - Диаметры монтажных отверстий под ЭРЭ
ЭРЭ монтирующиеся в отверстия | Диаметр вывода dв, мм | Минимальный диаметр монтажного отверстия dм.о.мин, мм | Выбранный диаметр монтажного отверстия dм.о., мм
DPY1 | 0,6 | 0,9 | 0,9
X1, X3 | 0,8 | 1,15 | 1,2
X2, S1 | 1 | 1,35 | 1,4

Расчет эффективного диаметра контактной площадки производится по формуле:

D1min=2(bM
+

dmax
2

+δ отв

+δ к.п .) =dсв+Δ d+0,96 , где

bм = 0,2 мм,
dсв=d м. о .+0.15=1.4

dmax=dсв+Δd

δ отв=δ о

+δδ=0,13 - смещение центра монтажного отверстия относительно координатной сетки,

δ к.п .=δ ш+δэ+

1/2(δп+δз)=0,15 - смещение центра контактной площадки относительно

координатной сетки,
Dmin=D1 min+1 .5 hф=D1 min+0,05

Dmax=Dmin+2 ΔЭ+Δ Dш=Dmin+0,09

Таблица 4.6.1.1.2 - Диаметры контактных площадок под ЭРЭ

ЭРЭ монтирующие ся в отверстия | Диаметр отверстия dм.о., мм | Минимальный диаметр КП Dmin, мм | Максимальный диаметр КП Dmax, мм | Диаметр КП фотошаблона Dш, мм
DPY1 | 0,9 | 1,1 | 1,19 | 1,15
X1, X3 | 1,2 | 1,45 | 1,54 | 1,50
X2, S1 | 1,4 | 1,65 | 1,74 | 1,70

tmin=t

1min+1.5hпм=0,25+1,5⋅0,035=0,3
При t = 0,5:
t max=t +2 ΔЭ+ Δtш=0,6
Ширина проводника t=0,5 мм подходит под ограничения ТЗ.
Минимальное расстояние которое может быть получено между проводником и монтажным отверстием с контактной площадкой и между двумя проводниками возьмем равным рассчитанной ширине проводника: 0,4 мм. Разработанная плата не содержит узких мест с расстоянием между элементами проводящего рисунка между собой и краями платы меньше 0,5 мм, что подходит под выбранный класс точности и метод изготовления.

### 4.6.1.2 Расчет по постоянному току

Падение напряжения на проводнике:

где ρ - удельное сопротивление проводника, ρ=0,017 Ом∗мм

2
/м
hф - толщина фольги, мм
bпр - ширина проводника, мм
l- длина проводника, м
I – ток, А
Наибольшее падение напряжения во всей схеме имеет место на проводниках питания контроллера MCU1, поскольку эти проводники — самые длинные на всей плате, и через них течет самый большой ток (один и тот же). Максимально возможное падение напряжния на проводнике положительного полюса питания:

Uп=

0,03⋅0,017⋅0,006
0,035⋅0,5

=0,00017B

Максимально возможное падение напряжния на проводнике отрицательного полюса питания:

Uп=

0,03⋅0,017⋅0,005
0,035⋅0,5

=0,00015B

Учитывая то, что все остальные проводники короче двух расчитанных, и проводят меньший ток, иожно заключить, что падение напряжения на проводниках рисунка печатной платы пренебрежимо мало, и ширина проводников, а также толщина медной фольги выбраны правильно.

### 4.6.1.3 Печатная плата

Проводящий рисунок разведенной печатной платы представлен на рисунке 4.6.1.3.1. Разводка соответствует принятым и расчитанным выше параметрам.

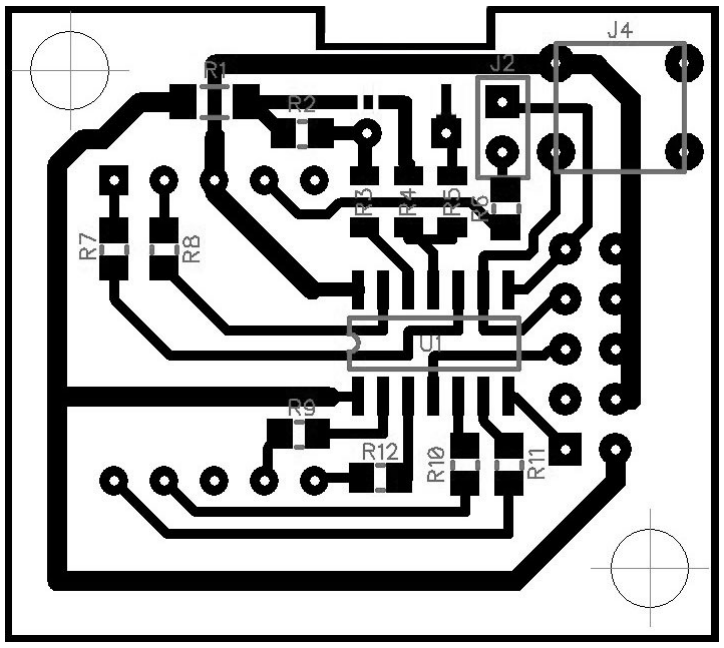
[picture p59: figure]

Рисунок 4.6.1.3.1 — Разведенная ПП устройства

### 4.6.1.3 Сборочный чертеж электронной ячейки

Принятые параметры печатной платы и представленная выше разводка ПП позволяют составить сборочный чертеж ПП, представленный на рисунке 4.6.1.4.1.

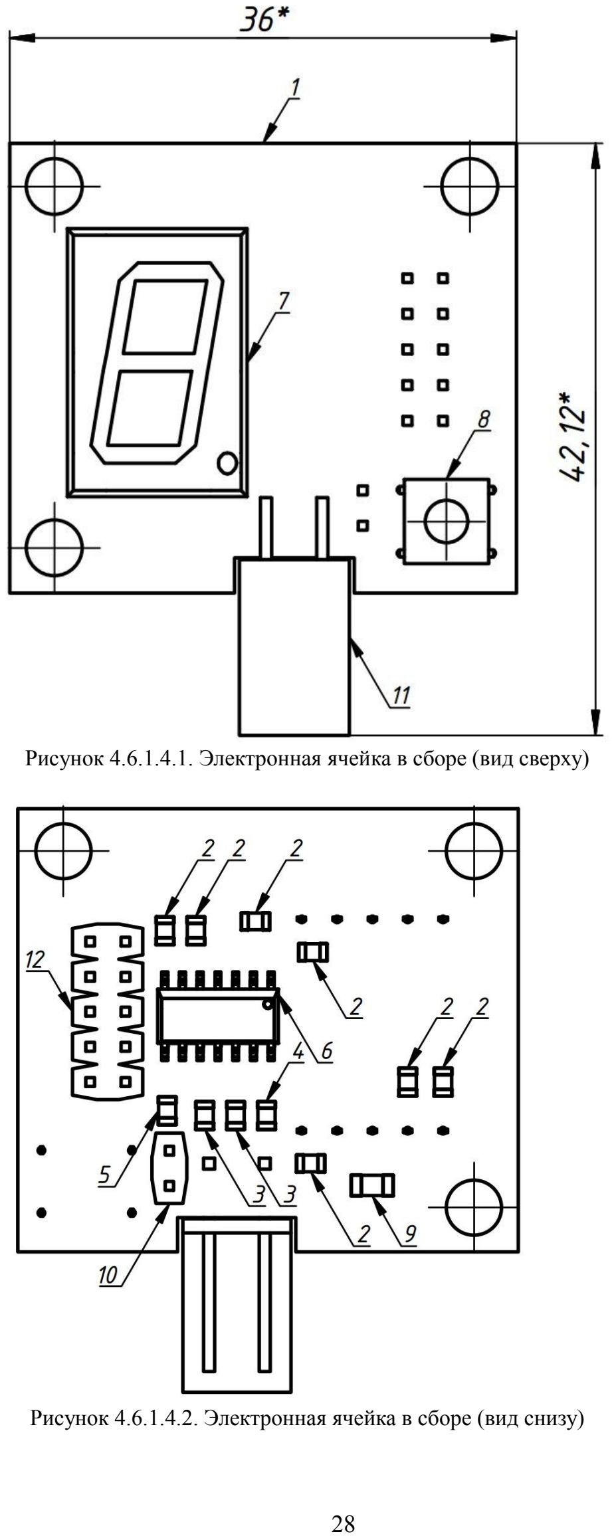
[picture p60: page 28]

Рисунок 4.6.1.4.1. Электронная ячейка в сборе (вид сверху)

Рисунок 4.6.1.4.2. Электронная ячейка в сборе (вид снизу)

### 4.6.2 Предварительный расчет надежности электронного узла

По техническому заданию вероятность безотказной работы в течение 1000 ч должна быть не менее 0,95 в соответствии с ГОСТ 27.002-89.
Рассматриваемое устройство содержит большое число неремонтируемых компонентов интенсивность отказов которых является постоянной во времени величиной, поэтому в данном случае имеет место экспоненциальное распределение отказов ЭА.
Вероятность безотказной работы при этом распределении выглядит следующим образом: P(t) = exp(-Λt),
где Λ = ∑Λi – суммарная интенсивность отказов всех модулей системы.
В табл. 3.6.1 приведены имеющиеся в устройстве компоненты и их интенсивности отказов.
Таблица 4.6.2.1 Интенсивности отказов компонентов
Компоненты и ЭРЭ | Интенсивность отказов λ | Количество
Микросхемы в пластмассовом корпусе | 0,15 | 1
Резисторы | 0,01 | 11
Светодиоды | 0,01 | 7
Соединения контактные | 0,05 | 8
Пайка паяльником | 0,2 | 25
Пайка в печи | 0,15 | 36

Расчет суммарной интенсивности отказов: Λ=(0,15+11⋅0,01+7⋅0,01+8⋅0,05+25⋅0,2+36⋅0,15)⋅10⁻⁶=10,53⋅10⁻⁶
Тогда вероятность безотказной работы в течение 1000 ч будет равна: P(t)=exp(−Λt)=exp(−10,53⋅10⁻⁶
⋅1000)=0,9895
Исходя из полученных данных, вероятность безотказной работы в течение 1000ч удовлетворяет условиям, заданным в техническом задании (0,9895>0,95).

### 4.6.3 Тепловой расчет блока

Целью расчета является определение температур нагретой зоны и среды вблизи поверхности ЭРЭ, необходимых для оценки надежности. Внутреннее пространство корпуса и печатная плата в сборе для упрощения расчета представляются параллелепипедами, как показано на рисунке 4.6.3.1. Размеры корпуса: длина L = 36 мм (a); ширина B = 34 мм (b); высота H = 25 мм (c).

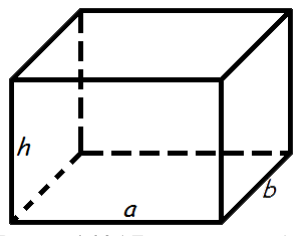
[picture p61: figure]

Рисунок 4.6.3.1.Тепловая модель блока 4.6.3.1 Расчет температуры корпуса tК.

1. Определяем удельную поверхностную мощность корпуса блока. Площадь поверхности блока:
L·B = 0,001224 м
L·H = 0,0009 м
B·H = 0,00085 м
Sбл=2· (L·B + L·H + B·H) = 5,948 мм²

= 6 · 10⁻³ м²
Мощность, рассеиваемая блоком в виде тепла (п. 4.5.1): Р0 = 0,2 Вт;

Удельная поверхностная мощность: q

K

=

P0

Sбл

=

0,2
0,006

=33,3 Вт
м

2

График зависимости перегрева корпуса от удельной поверхностной мощности [4] представлен на рисунке 4.6.3.2.

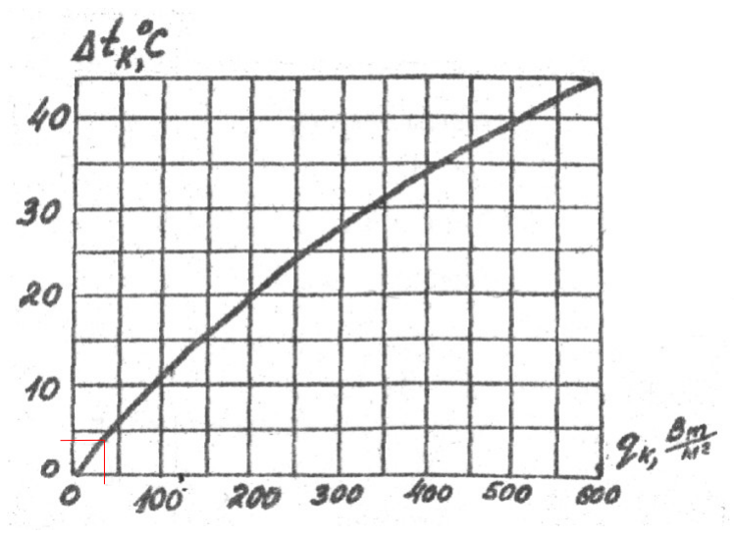
[picture p62: figure]

Рисунок 4.6.3.2 - График зависимости перегрева корпуса от удельной поверхностной мощности.

2. Определяем по графику и с учетом предыдущих расчетов температуру перегрева корпуса в первом приближении Δt K=4

∘C

3. Определяем коэффициент лучистого теплообмена для верхней, боковой и нижней граней корпуса.
Так как весь корпус блока выполнен из одинакового материала с коэффициентом излучения o ε=0,9 , то коэффициент лучеиспускания будет одинаковым.

αЛ=ε⋅5,67

[(
tC+ ΔtK +273

100 )
4

−(
tC +273

100 )
4

]

ΔtK

=0,243[(
tC+277

100 )
4

−(
tC +273

100 )
4

]
, (4.6)

где С

t - температура окружающей среды (принимаем равной 70 C
o

).
Подставив имеющиеся значения в (4.6), получим: αЛ=68.9
4. | Для | определяющей | критической | температуры
t m=(t

к+tC +Δt K )/2=(61.92+70+4)/2=69.46∘
C находим для каждой поверхности блока число Грасгофа:

К
m

”•
m m

t

L
Gr = g Δ 2

3
р
*
ν

β

Найдем входящие в эту формулу параметры:
коэффициент объемного расширения воздуха βm=(t опр+273)

−1=(72+273)

−1=0.003 ;

2

9.81
с

м
g = - ускорение свободного падения;

с

м
m

2
6

16*10-
ν = | - кинематическая вязкость воздуха;

Lопр1=L=0,036 м - определяющий размер для боковой поверхности корпуса блока

Gr 1=βm

g⋅

L

3
ν m

2

| ΔtK=0,03⋅9,81 0,036³ (16⋅10⁻⁶ )
| 2 ⋅18=9,6⋅10⁵

Lопр2=B=0,034 м - определяющий размер для торцевой поверхности корпуса блока

Gr 2=βm

g⋅

L

3
νm

2

| Δ tK=0,03⋅9,81 0,034³ (16⋅10⁻⁶ )
| 2 ⋅18=8,1⋅10⁵

Lопр2=H=0,025 м - определяющий размер верхней и нижней поверхности корпуса блока

Gr 3=βm

g⋅

L

3
νm

2

| Δt K=0,03⋅9,81 0,025³ (16⋅10⁻⁶ )
| 2 ⋅18=3,2⋅10⁵
5. Для определяющей температуры tопр= 72˚С по таблице теплофизических характеристик определяем число Прандтля Pr=0,708 – один из критериев подобия тепловых процессов в жидкостях и газах, учитывающий влияние физических свойств теплоносителя на теплоотдачу.

6. Определяем режимы вне блока
Для боковой поверхности корпуса блока: Gr1·Pr = 6,8·10⁵<3,1·10⁶

< 2·10⁷
, следовательно режим движения воздуха, обтекающего боковую поверхность корпуса, ламинарный; Для торцевой поверхности корпуса блока: Gr2·Pr = 5,7·10⁵<3,6·10⁶

< 2·10⁷
, следовательно режим движения воздуха, обтекающего верхнюю поверхность корпуса, ламинарный;
Для верхней и нижней поверхности корпуса блока: Gr3·Pr = 2,2·10⁵<1,2·10⁶

< 2·10⁷
, следовательно режим движения воздуха, обтекающего нижнюю поверхность корпуса, ламинарный.
7. Рассчитываем конвективный коэффициент теплообмена для каждой поверхности по следующей формуле:

Δt
к .2=

P0
σ K

=

0,2
0,051
=3,9∘С | (4.7)

где λт=2.71∗10⁻² Вт
м∗К
- теплопроводность воздуха,

NВ - коэффициент, учитывающий ориентацию блока:
- верхняя поверхность: 1,3;
- нижняя поверхность: 0,7;
- передняя и задняя поверхности: 0,1.

α KВ=0,54⋅

2,71⋅10⁻²
0.028

⋅(6,8⋅10⁵
)

1/4⋅1,3=19,5 Вт
м

2
⋅К
- для верхней поверхности корпуса

α KН=0,54⋅

2,71⋅10⁻²
0.028

⋅(2,2⋅10⁵
)

1/4⋅0,1=1,1 Вт
м

2
⋅К
- для нижней поверхности корпуса

Sпов=2 ab+2ah+2bh - для боковых, передней и задней поверхностей корпуса

Определяем тепловую проводимость между поверхностью корпуса и окружающей средой:
( | ) | ( | ) | ( | ) К | КВ | Л | В | КН | Л | Н | КБ | Л | Б s= | + | + | + | + | + a a | a | a | a a S | S | S | (4.8)

Подставив имеющиеся значения в (4,17), получим:
σ К=(19+6.12)∙ 0,001224+(1,1+6.12)∙0,0009+(10+6.12 )∙0,00085=0,051 Вт К
Определяем температуру перегрева корпуса во втором приближении:

Δt
к .2=

P0
σ K

=

0,2
0,051
=3,9∘С | (4.9)

Ошибка определения температуры корпуса

δ=

|Δ t
к .2−Δt
к
Δt
к .2

=

|3,9−4|
3,9

=0,026

Значение ошибки находится в допустимых пределах δ ≤ 0,1, значит значение k Δt было

подобрано правильно.
Определяем температуру корпуса:
t

к=t
0

+Δt

к .2=70+3,9=73,9∘C .

### 4.6.3.2 Расчет температуры элемента

Для блока рассчитаем температуру самого мощного элемента: микросхемы ATtiny24V-

10SU.

Площадь поверхности микросхемы:

R=

Uпит−U пад. св.
I р

=

3−1,9
160

≈ 6,8Ом.

(4.10)

где:
a – длина микросхемы: 8,6 мм;
b – ширина микросхемы: 3,9 мм;
h – высота микросхемы: 1,5 мм.
Подставив имеющиеся значения в (4.10) получим:
Sпов=10,5∙10⁻⁶
м²
Определяем эквивалентный коэффициент теплопроводности. Поскольку тепловых шин на плате нет, то принимаем:

λэкв=λпп=0,3 Вт
м⋅К

Определяем коэффициент распространения теплового потока: m=√
α1

+α2

dλэкв

=√
17
0.001∗0.3

=168.32 .

1 2 a ,a - коэффициенты теплообмена платы с одной и с другой стороны.

Для случая естественного охлаждения

1 | 2 | 2

17 Вт
м С

a a+ =
Ч
o

Определяем температуру перегрева корпуса микроконтроллера:


где в Δt - температура перегрева воздуха в блоке: 3,9 °C,

QЭРЭi - мощности ЭРЭ, которые окружают исследуемый
N = 12 - число ЭРЭ, располагающихся вокруг рассчитываемой микросхемы на

расстоянии не более 4
m

=

4
168.32

=0.022 м.

M=2, B=8,5 π R

2=3.2∗10⁻³ Вт
К
- условные коэффициенты, зависящие от типа платы

K=1 - эмпирический коэффициент Ri - расстояния до соседних ЭРЭ Ka =14 Вт
м

2∗К
k1, k0 - модифицированные функции Бесселя первого и нулевого порядков от соответствующего аргумента
| mr1=mr2=mr3=168.32∗0.02=3.36
Подставляя вычисленные значения в формулу, получаем Δt ИС=2,7∘С .
Определяем температуру корпуса Δtис

## Δtис

| = К

t + Δt
0

= 70+48,6=73,6 С
o

Предложенные условия охлаждения обеспечивают нормальную работу блока и поэтому не требуется корректировка конструктивных параметров или замена системы охлаждения на более эффективную. Принимаем систему охлаждения – естественный конвективный

теплообмен.

### 4.6.4 Расчет на механические воздействия

Целью расчета является определение действующих на элементы изделия перегрузок при

действии вибрации и ударов, а также максимальных перемещений.

### 4.6.4.1 Расчет на действие вибрации

Определим цилиндрическую жесткость платы:

( )

3

2
12 1

Eh D
ν

=
, | (4.11)

где

E - модуль упругости для материала платы:

10
2

H
3,02 10
м
- ;

h - толщина ПП: 0,0018 м;

ν - коэффициент Пуассона: 0,3.

Подставим имеющиеся значения в (4.22), получим:

( | )
10 | 3

2

3,02 10 | 0,0015 | 9,3 Нм
12 1 0,3

D

- ·
= | = | ·

Определим частоту собственных вибраций:

2
0 | 2 | 2 1
2
a | D f | ab
a | b | M
| π æ | | ö
= | + ç | ÷ è | ø
, | (4.12)

где

a -длина платы: 0,049 м;

b - ширина платы: 0,019 м.

M - масса платы с элементами: 0,02 кг.

Подставим имеющиеся значения в (4.23), получим:

2

0 | 2 | 2
3,14 | 0,16 | 9,3 1 | 0,16 0,12 83 Гц
2 0,16 | 0,12 | | 0,76

f

æ | ö
= | + | · | = ç | ÷
- | è | ø

Определим коэффициент динамичности для динамического возбуждения:

( | )
2 | 2

2
2 | 2 | 2

1

1

εη
µ
η ε η

+
=
- +
, | (4.13)

где

ε - показатель затухания: 0,01;

max

0

35 0,42
83

f
f
η = | = | = | - коэффициент расстройки;
max f | - максимальная частота по ТЗ.

Подставим имеющиеся значения в (4.24), получим:

( | )
2 | 2

2
2 | 2 | 2
1 0,01 0,42 | 1,1
1 0,42 | 0,01 0,42

µ

+ | ·
= | =
- | + | ·

Определим амплитуду вибросмещения основания:

0
0 | 2 | 2
max 4

a
f

ε
π

=
·
, | (4.14)

где

0 a - виброускорение: 29,4
2

м
с

Подставим имеющиеся значения в (4.25), получим:

4
0 | 2 | 2
29,4 | 6 10 м
4 3,14 35

ε

= | = ·
- ·

Определим виброускорение и виброперемещение ЭРЭ. Для расчета возьмем лампу

6Н3П.
( ( | ) )
( | )

2
2 | 2 2

2
2 | 2 2
1 | 1

1

Kx Ky | η | ε η
γ
η | ε η
+ | · | - | +
=
- +
, | (4.15)

где

Kx Ky , - показатели затухания формы колебаний: 1,3;

Подставим имеющиеся значения в (4.26), получим:
( ( | ) | )
( | )

2
2 | 2 | 2

2
2 | 2 | 2
1 1,3 1,3 1 0,42 | 0,01 0,42
1,362
1 0,42 0,01 0,42

γ

+ | · | - · | + | ·
= | =
- | + | ·

Виброускорение элемента:

0 | 2

м
29,4 1,362 40
с

a

a | a = | · = | · | = γ

(4.16)

Виброперемещение элемента:

4 | 4
0

sa
εγ 6 10 1,362 8,1 10 м
= | · = · | · | = | ·

(4.17)

Опредилим максимальный прогиб ПП:

4 | 4 | 4
0
δ | ε а | a s | 8,1 10 | 6 10 | 2,1 10 м
= | - | = | · | - · | = | ·

(4.18)

Определим допустимый прогиб платы:

4
s | h д | 0,3 | 0,3 0,0015 5 10 м
= | = | · | = ·

(4.19)

Таким образом, плата и ЭРЭ удовлетворяют условиям ТЗ по виброустойчивости.

### 4.6.4.2 Расчет на действие удара

Исходные данные: воздействующий импульс полусинусоидальной формы.

Определяем условную частоту ударного импульса:

1
ω
τ
= , | (4.20)

где τ – длительность ударного импульса, по ТЗ τ = 5мс.

Отсюда следует по (4.20), что ω = 200

1
с

Определяем коэффициент передачи при ударе:

2

2
cos
1 2

Ку

ν | π
ν | ν

æö
= | ç | ÷
- èø
, | (4.21)

где

0

200 | 0,4
2 | 2 3,14 83 f

ω
ν
π
= | = | =
- ·

(4.22)

Подставив (4.22) в (4.21) получим:

2

2 0,4 cos | 0,67
0,4 | 1 | 2 0,4

К
у
- | æ | ö π
= | = ç | ÷
- | · è | ø

Определение ударного ускорения по формуле (4.16):

0 | 2

м
29,4 0,67 20
с
a | у
a | a K = | · | = | · | =

Таким образом, спроектированная ПП соответствует требованиям указанным в ТЗ.

### 4.6.5 Расчет технологичности

Базовые показатели технологичности приведены в табл. 4.6.5.1.

Таблица 4.6.5.1 – базовые показатели технологичности
Наименование показателя | Формула расчета | Значение | Знач имос φi ть | Примечание
Коэффициент использования микросхем | H k = ИМС ИМС H + H ИМС ЭРЭ | 0,047 | 1,0 | HИМС = 1– количество ИМС HЭРЭ =21 – общее количество ЭРЭ
Коэффициент механизации и автоматизации монтажа | H k = АМ АМ H М | 0,59 | 1,0 | HАМ = 36 – кол-во соед-й, получ. автом. способом HМ = 61 – общее кол-во монтажных соединений
Коэффициент механизации подготовки к монтажу | H МПИЭТ k = МП H ИЭТ | 0 | 0,8 | 0 HМПИЭТ = – кол-во мех-но подготовленных ИЭТ HИЭТ = 21 общее число ИЭТ
Коэффициент механизации контроля и настройки | H МКН k = МКН H КН | 0 | 0,5 | HМКН = 0 – кол-во операций мех-го контроля и настройки HКН = 1 – общее кол-во операций контроля и настройки
Коэффициент повторяемости ЭРЭ | H ТЭРЭ k =-1 ПовтЭРЭ H ЭРЭ | 0,48 | 0,3 | HТЭРЭ = 10 – количество типоразмеров ЭРЭ HЭРЭ =21 – общее количество ЭРЭ
Коэффициент применямости ЭРЭ | H ОрЭРЭ k =-1 ПримЭРЭ H ТЭРЭ | 0,8 | 0,2 | HОрЭРЭ = 0 – количество оригинальных ЭРЭ HТЭРЭ = 10 – количество типоразмеров ЭРЭ

Комплексный показатель технологичности:

0,35
3,8

1,36
1.0 1.0 0.8 0.5 0.3 0.2

10,47 10,59 0 0.8 0 0,5 0,48 0,3 0,8 0,2 7

1

6

1 | = | ≈
+ | + | + | + | +
- | + · | + · + · + | · + | ·
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
(4.23)

К=0,35 – подходит для мелкосерийного производства. Таким образом, конструкция

ячейки имеет необходимый уровень технологичности.

### 4.6.6 Расчет надежности

Интенсивность отказа элементов с учетом условий эксплуатации изделия:

0 | 1 2 3 4 | ( , ) i | i | i | ’ λλ = | ·k k k k a T k ,

где

λ0i
- номинальная интенсивность отказов (см. табл. 4.6.2.1)

k1 и k2 - поправочные коэффициенты в зависимости от воздействия мех. факторов;

k3 - поправочный коэффициент в зависимости от воздействия влажности и температуры;

k4 - поправочный коэффициент в зависимости от давления воздуха;

ai(T,kн) - поправочный коэффициент в зависимости от температуры поверхности

элемента T и коэффициента нагрузки kн (см. табл. 4.6.7.1);

k1=1,04, k2=1,03 (стационарные условия эксплуатации),

k3=2,0, k4=1 (нормальное давление).

В табл. 4.6.7.1 представлены данные о интенсивности отказов всех компонентов.

Таблица 4.6.7.1 Интенсивности отказов компонентов
Компоненты и ЭРЭ | Номинальная интенсивность отказов, 0 10 1 ч λi · -6 | Поправочный коэффициент, ai(T,kн) | Интенсивность отказов, · 10 1 ч λi -6 | Количество
Схемы интегральные | 0,2 | 0,7 | 0,03 | 1
Резисторы | 0,01 | 0,5 | 0,011 | 11
Диоды | 0,15 | 0,2 | 0,064 | 7
Соединения контактные | 0,05 | 0,3 | 0,032 | 8
Пайка ручным способом | 0,2 | - | 0,43 | 25
Пайка в печи | 0,15 | - | 0,32 | 36

Рассчитаем суммарную интенсивность отказов и построим график зависимости

вероятности отказов от времени (рис. 4.6.7.1):

Λ = (0,03+0,011*11+0,064*7+0,032*8+0,43*25+0,32*36)*10^-6 = 23*10⁻⁶

Тогда вероятность безотказной работы в течение 1000 ч будет равна:
P(t) = exp(-Λt) = exp(-23*10⁻⁶
*1000) = 0,977.

Исходя из полученных данных, вероятность безотказной работы в течение 1000ч

удовлетворяет условиям, заданным в техническом задании (0,977 > 0,95).

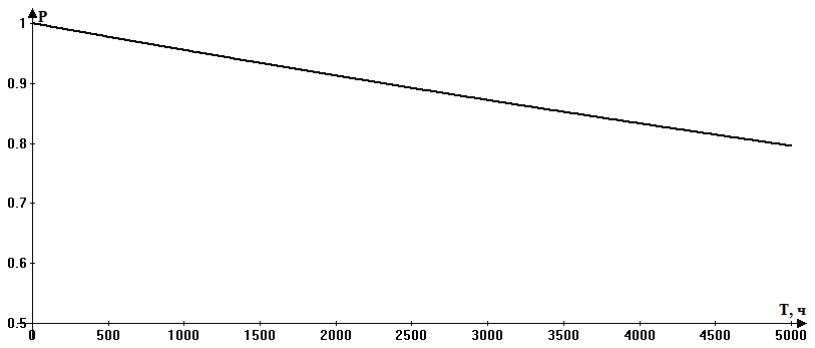
[picture p63: figure]

Рис. 4.6.7.1. Зависимость вероятности отказов от времени эксплуатации

### Заключение

В ходе проделанной работы были разработаны функциональная и принципиальные

схемы измерителя уровня топлива, конструкция блока, проведено распределение элементов

электрической схемы, решены задачи размещения ЭРЭ и трассировки печатного рисунка,

проведены необходимые конструкторские расчеты. Разработанное устройство полностью

удовлетворяет предъявляемым к нему требованиям технического задания.

### Список использованных источников

1. Конструкторско-технологические проектирование электронной аппаратуры: Учебник для вузов / К.И. Билибин, А.И, Власов, Л.В. Журавлева и др. Под общ. ред. В.А. Шахнова – М.: Изд-во МГТУ ми. Н.Э. Баумана, 2002. – 528 с.
2. Сборка и монтаж интегральных микросхем: Учеб. пособие / Романова М.П - М.:УлГТУ, 2008. – 95 с.
3. Проектирование и технология печатных плат: Учебник / Пирогова Е. В. — М.: ФОРУМ: ИНФРА-М, 2005. — 560 с.
4. Методические указания к курсовой работе «Компоновка и расчет конструктивных параметров блоков ЭВА» / А.Н. Чеканов, В.В. Съедугин, В.В. Маркелов – М.:МГТУ им. Н. Э. Баумана, 1980, 45с
5. Теоретические основы конструирования и надежности ЭВС. Курс лекций – М.:МГТУ им. Н. Э. Баумана, 2011, (рукопись)
6. Технология ЭВС. Курс лекций – М.:МГТУ им. Н. Э. Баумана, 2011, (рукопись)
7. Конструирование ЭВС. Курс лекций – М.:МГТУ им. Н. Э. Баумана, 2012, (рукопись)
