MBoldyrev/kurs_mark/ot_Mansh/A3_Plata_sdm_my.JPG

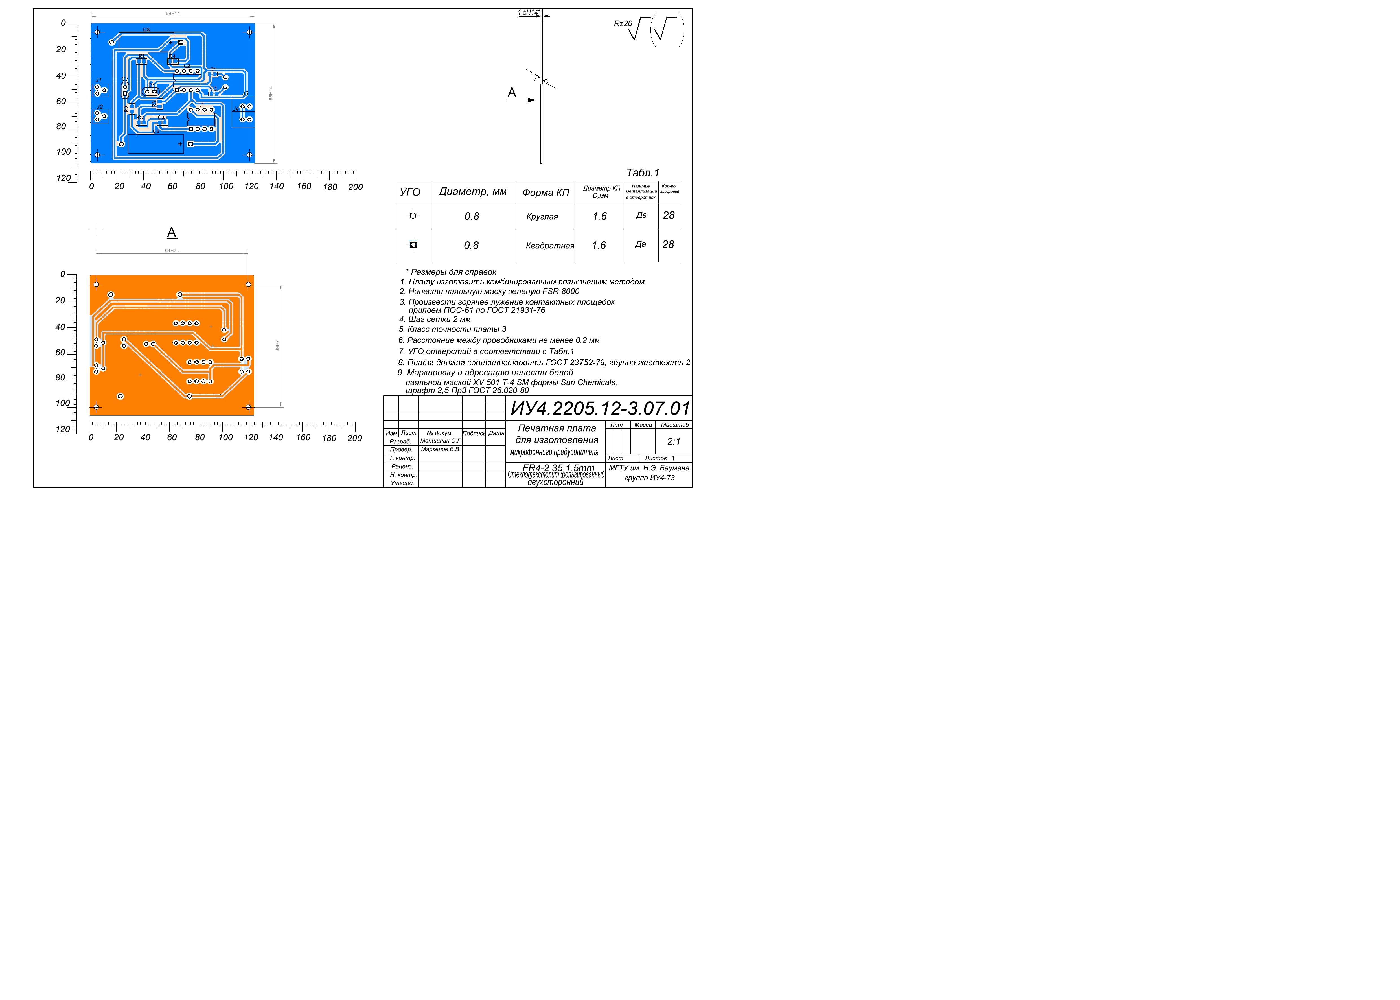
ot_Mansh/A3_Plata_sdm_my.JPG
