MBoldyrev/kurs_mark/ot_Mansh/Plata_sdm_my.JPG

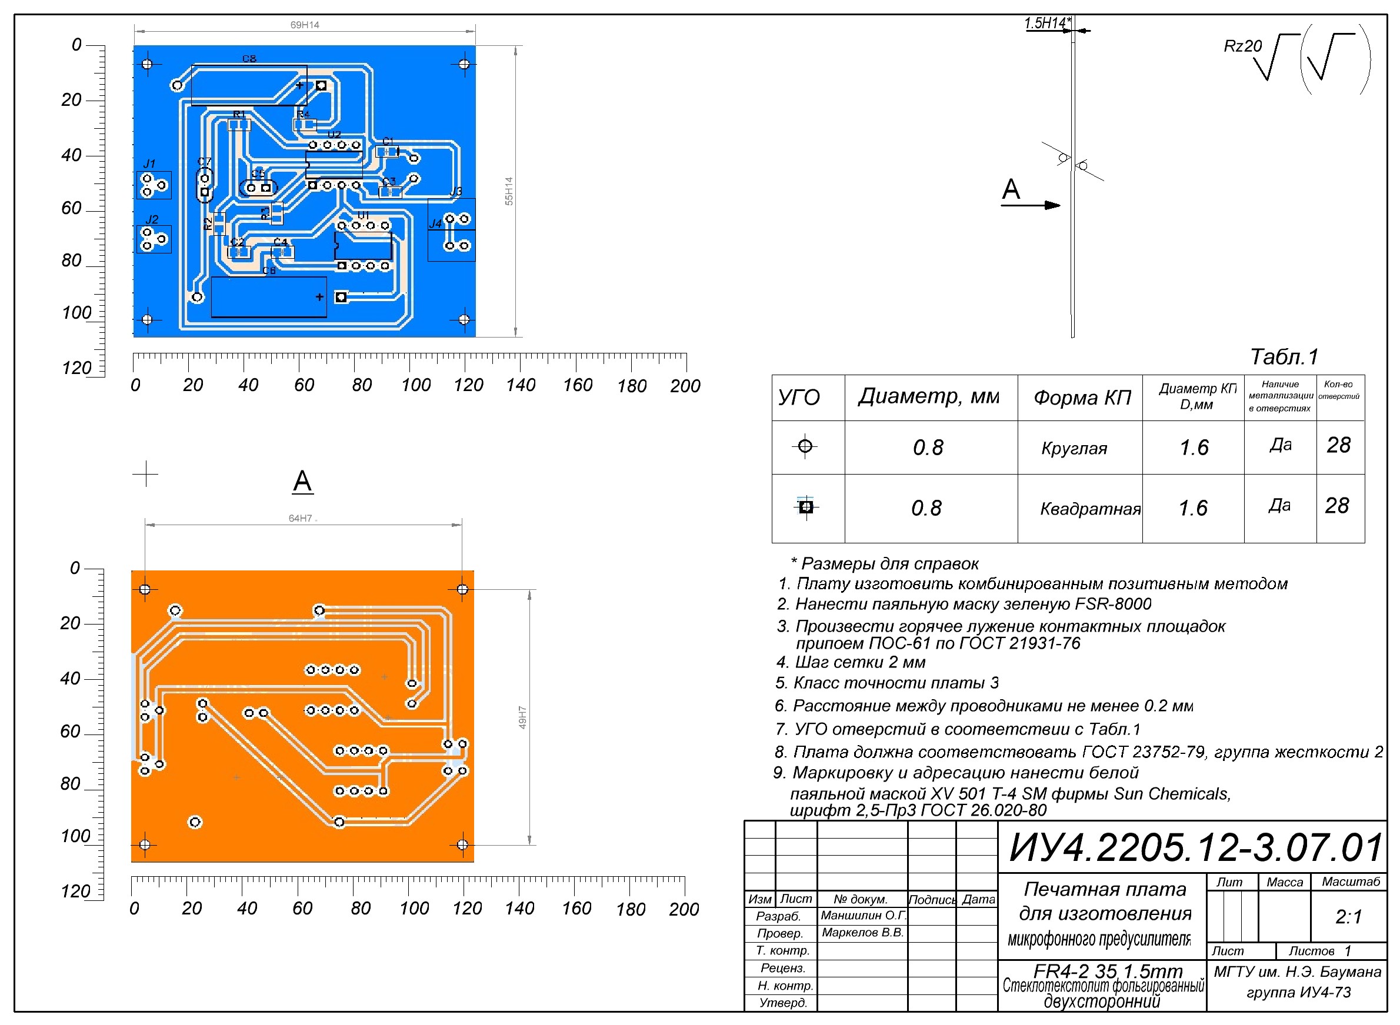
ot_Mansh/Plata_sdm_my.JPG
