MBoldyrev/kurs_mark/ot_Mansh/png/A1_Sborka_yach.png

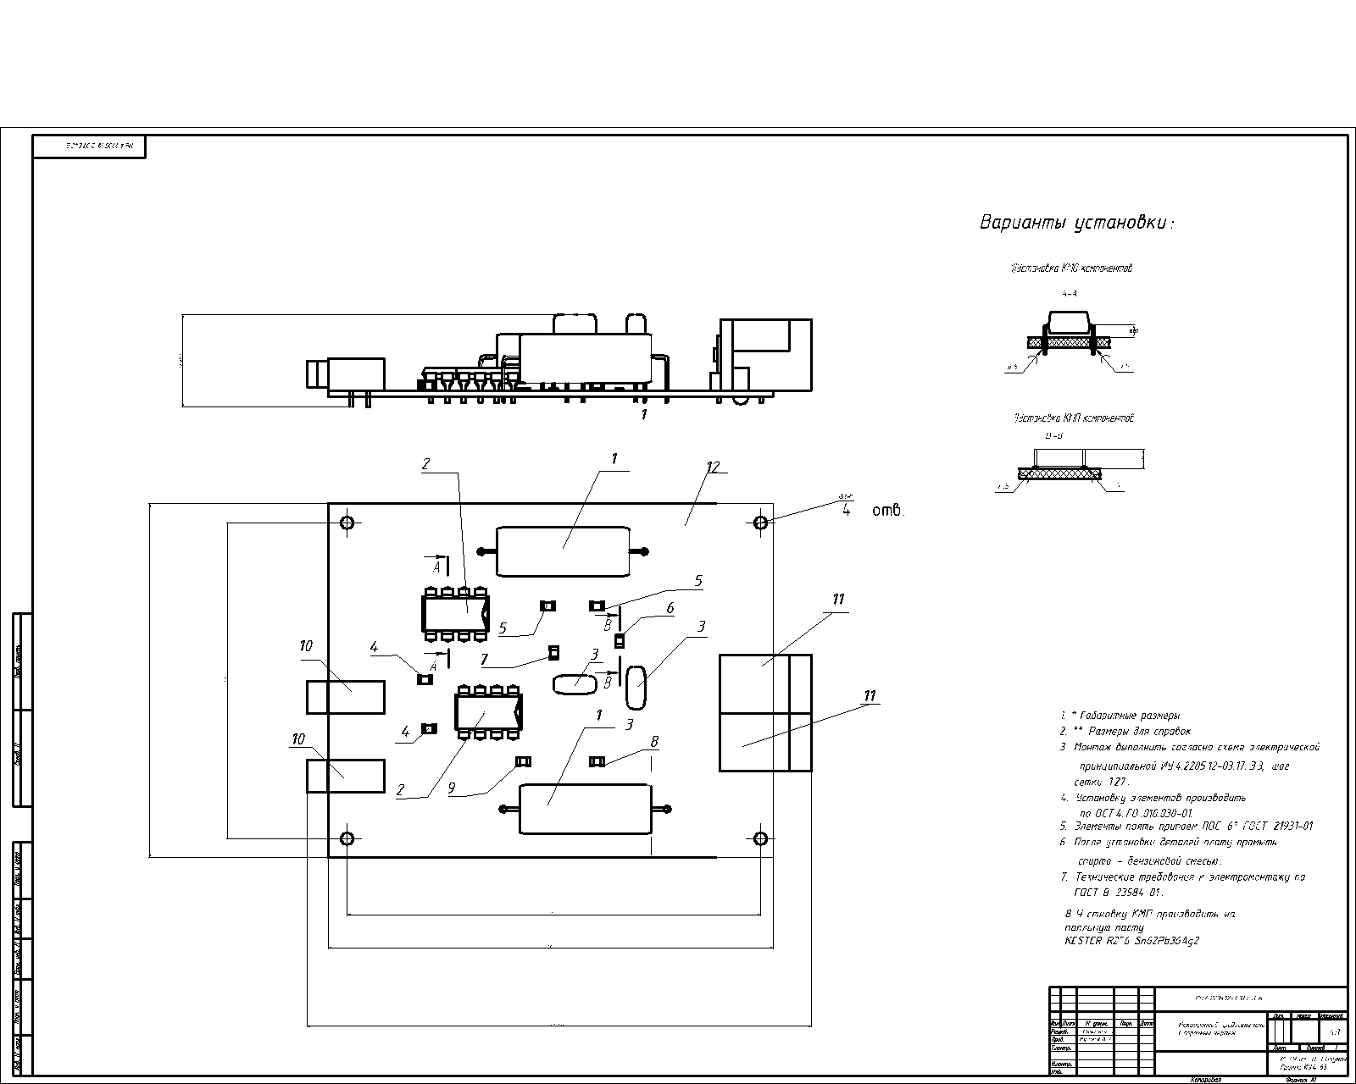
ot_Mansh/png/A1_Sborka_yach.png
