MBoldyrev/kurs_mark/ot_Mansh/png/A3_sborka_all.png

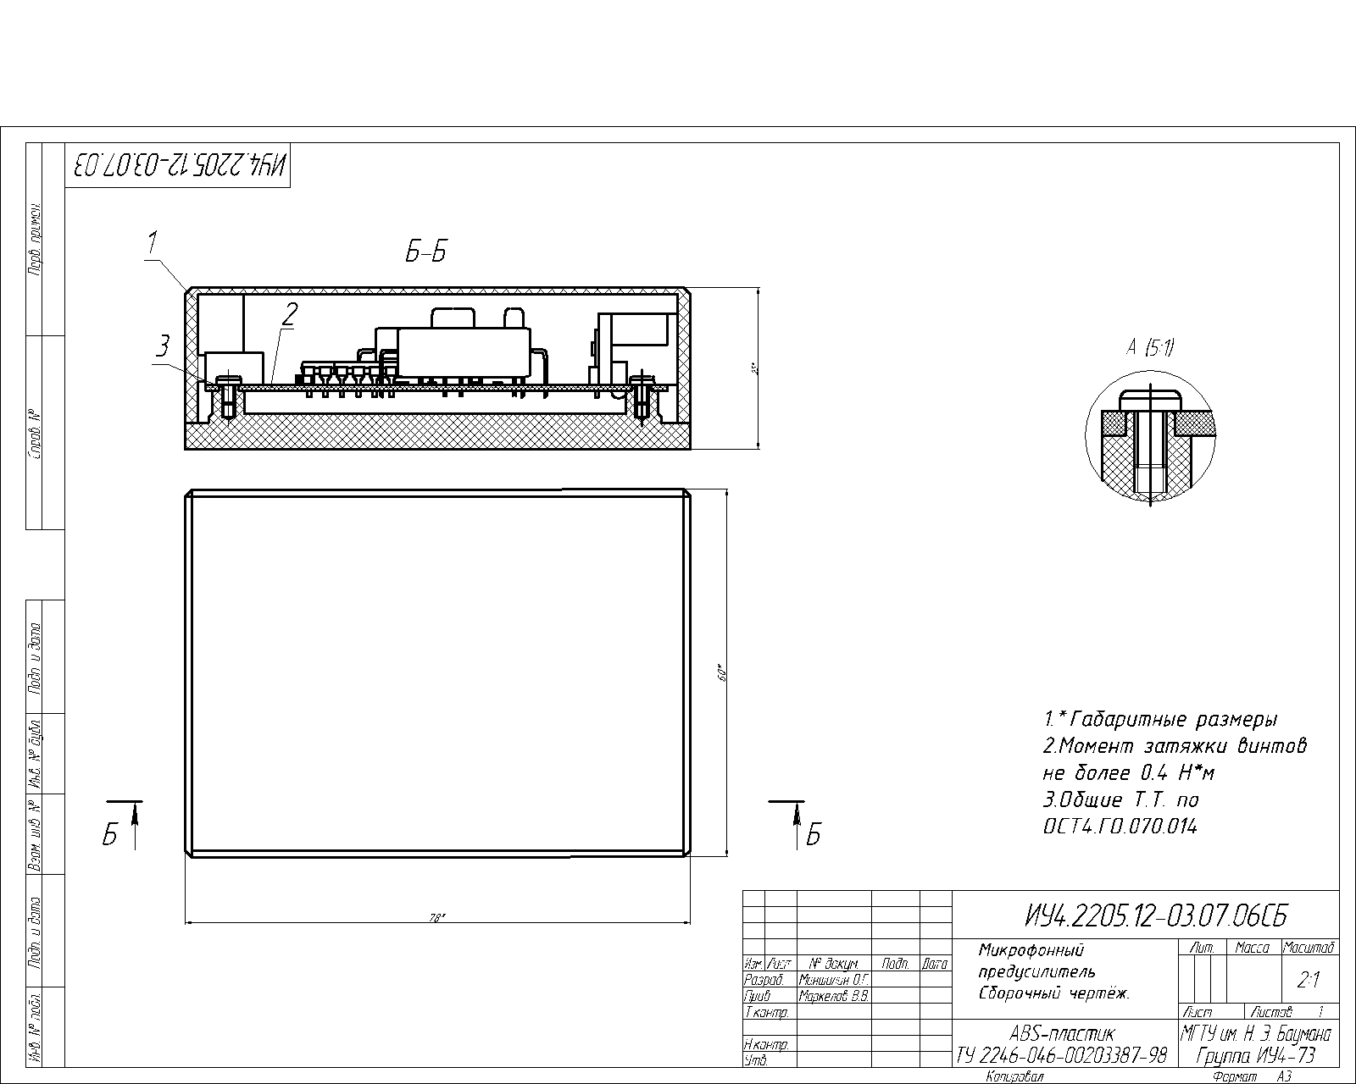
ot_Mansh/png/A3_sborka_all.png
