MBoldyrev/kurs_mark/ot_Mansh/png/A3_sborka_korpus.png

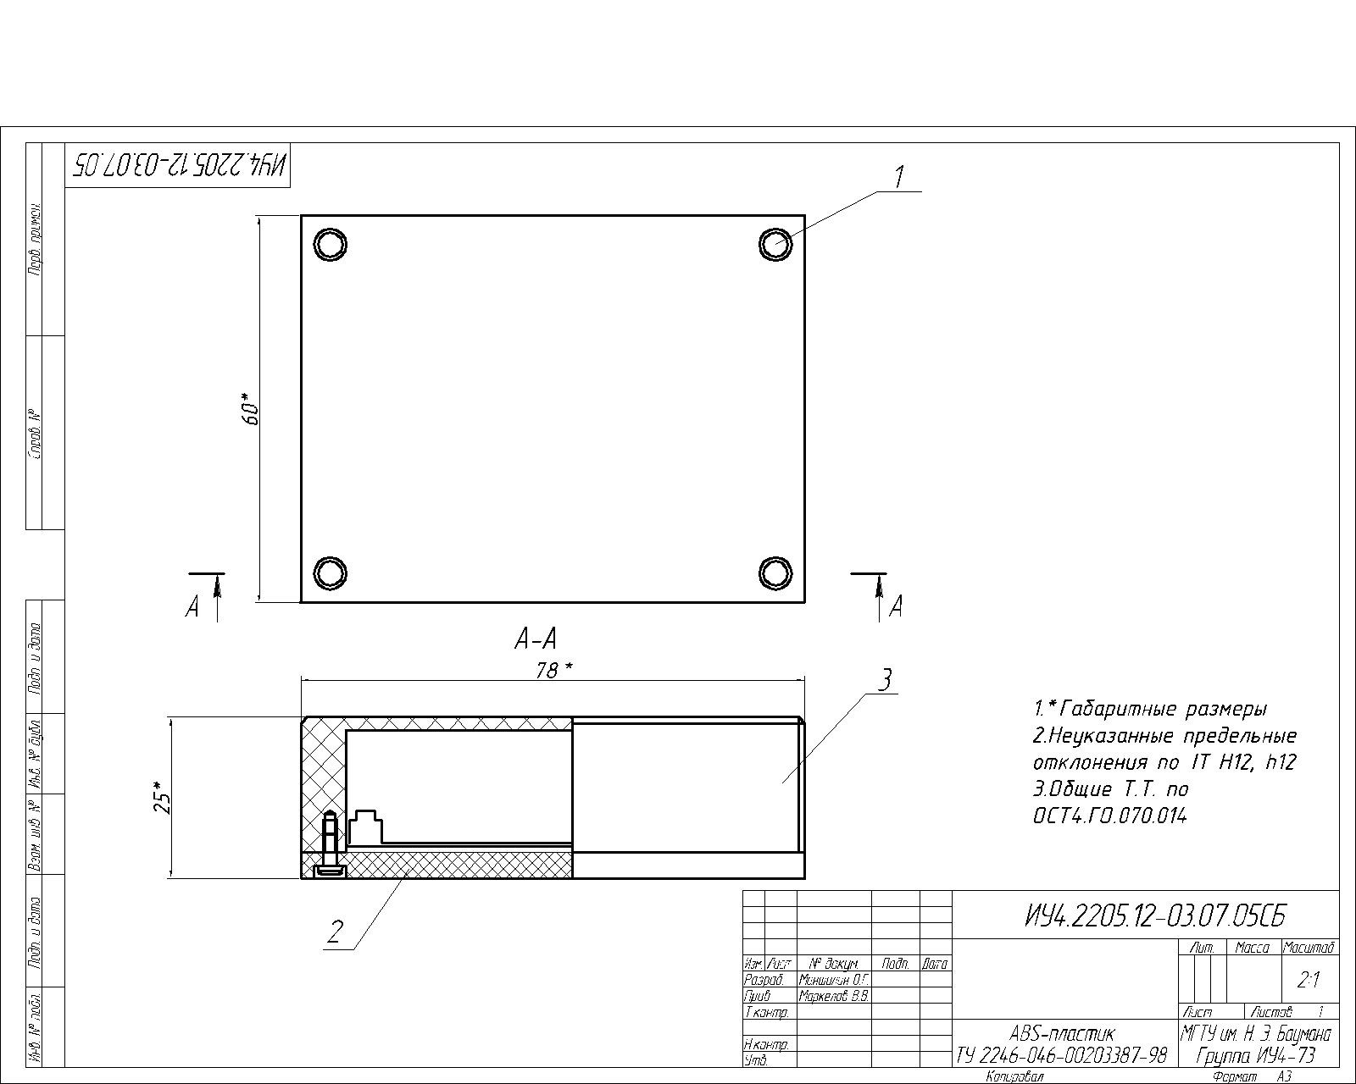
ot_Mansh/png/A3_sborka_korpus.png
