MBoldyrev/kurs_mark/ot_Mansh/png/korpus.png

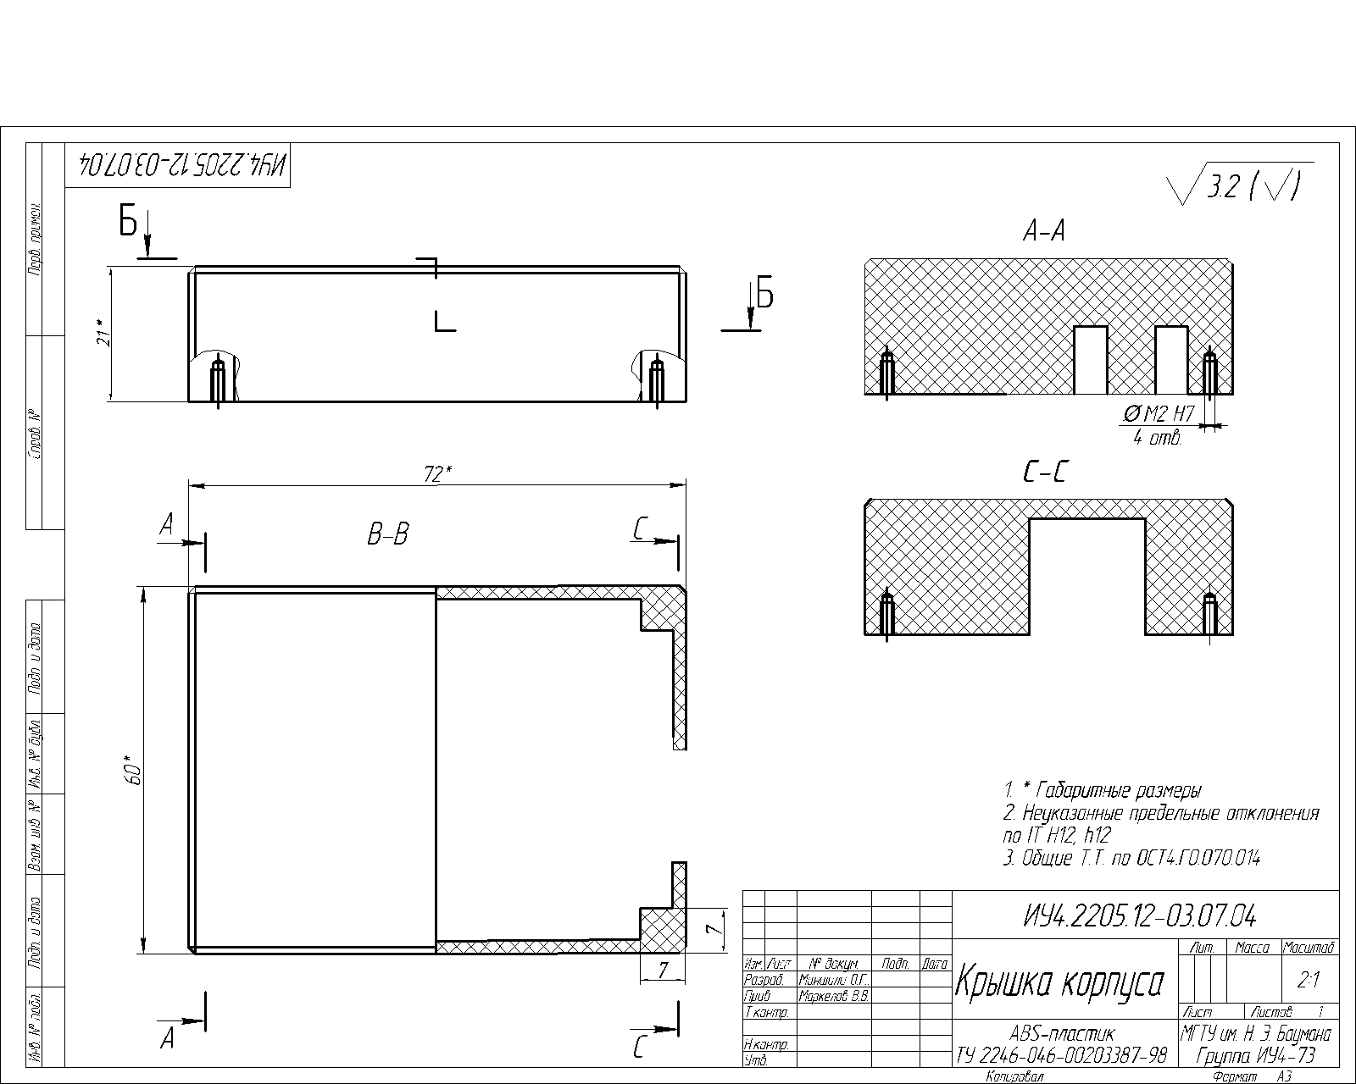
ot_Mansh/png/korpus.png
