MBoldyrev/kurs_mark/ot_Mansh/png/Krishka.png

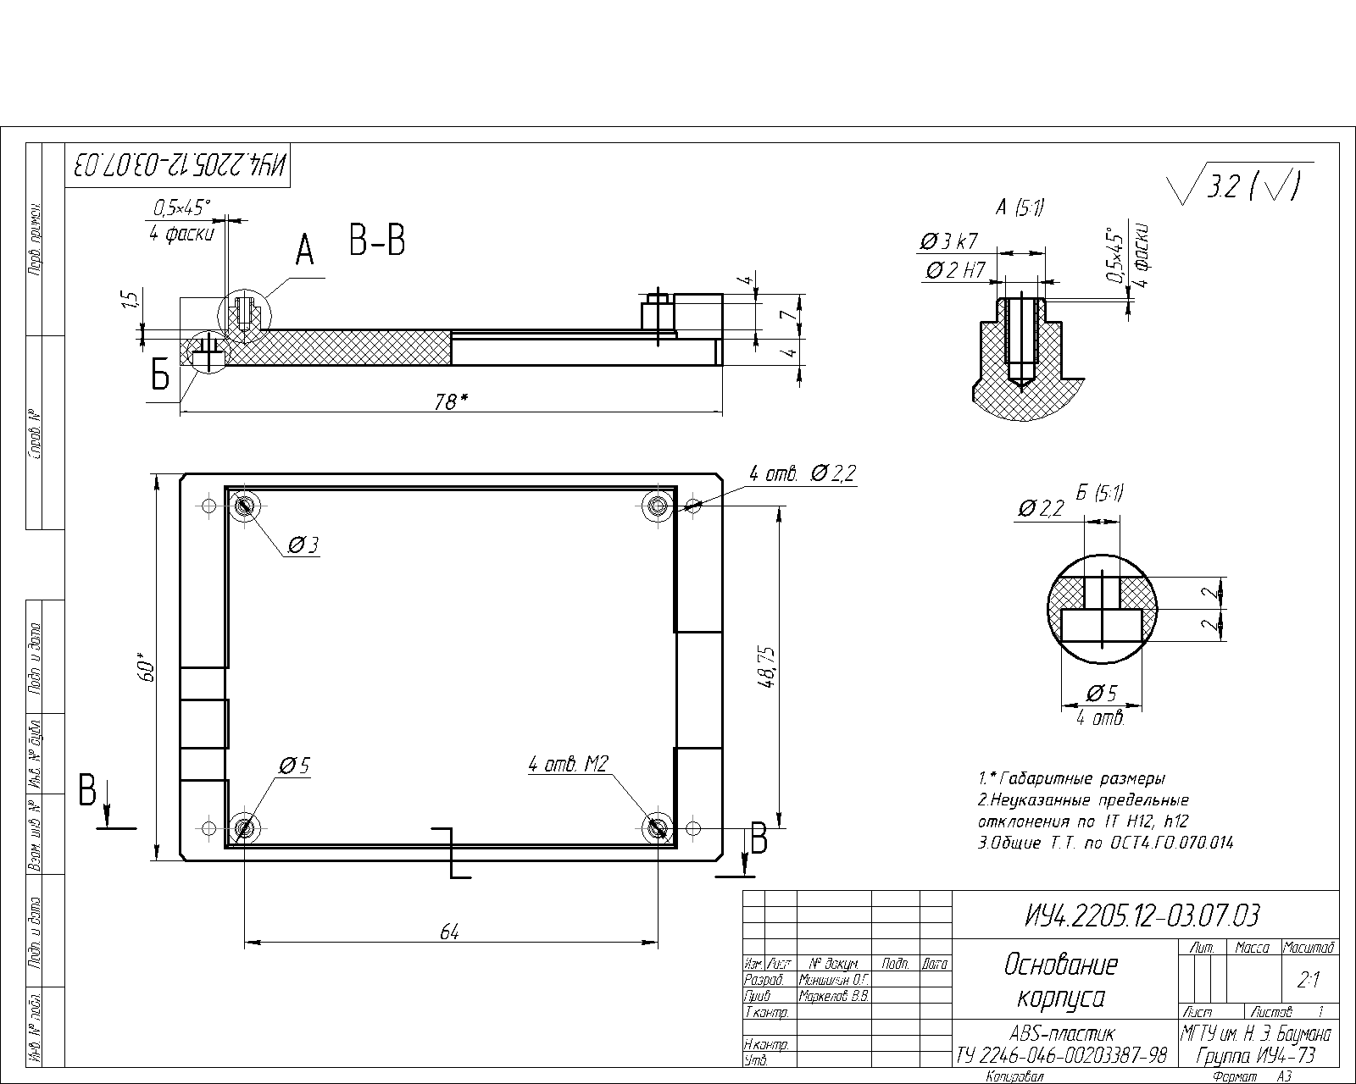
ot_Mansh/png/Krishka.png
