MBoldyrev/kurs_mark/pic/board_s.jpg

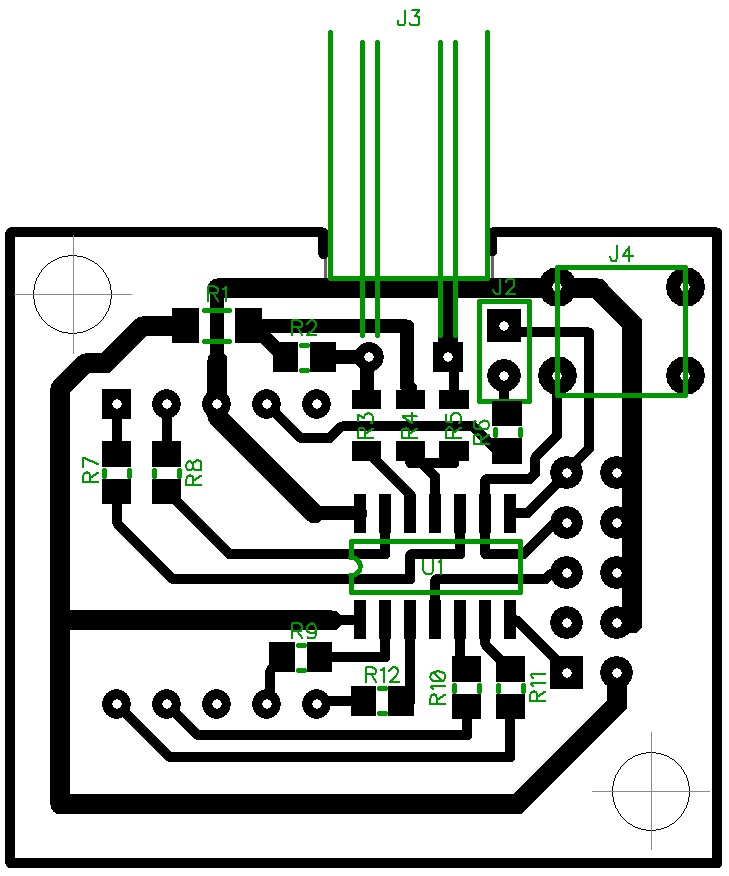
pic/board_s.jpg
