MBoldyrev/kurs_mark/pic/board_sh.jpg

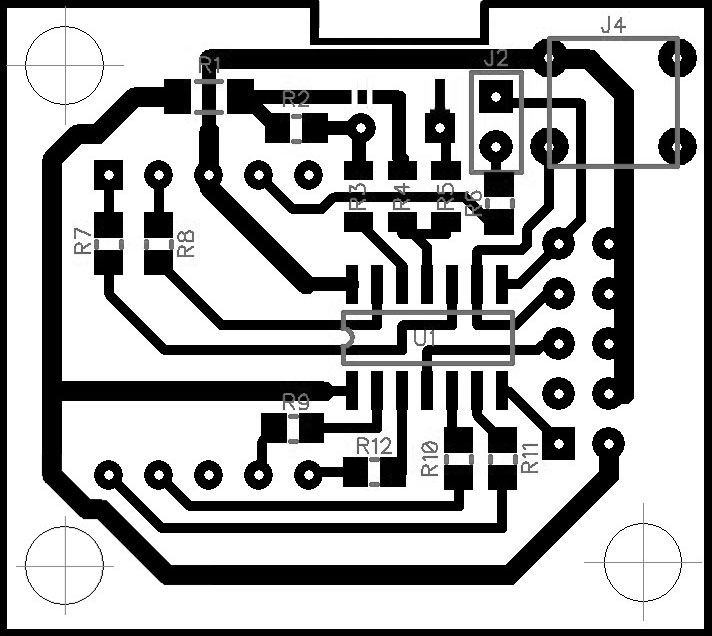
pic/board_sh.jpg
