MBoldyrev/kurs_mark/pic/bot.JPG

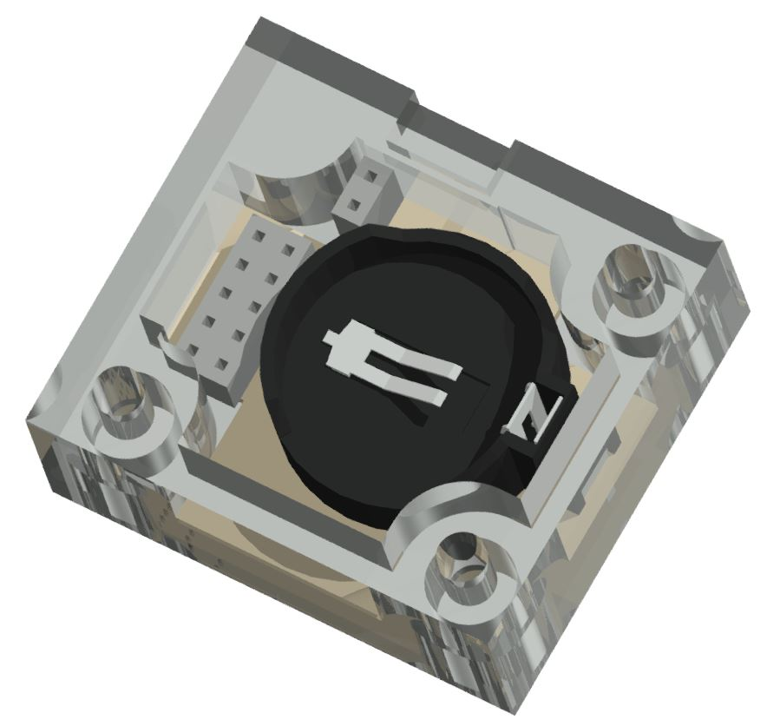
pic/bot.JPG
