MBoldyrev/kurs_mark/pic/extern1.JPG

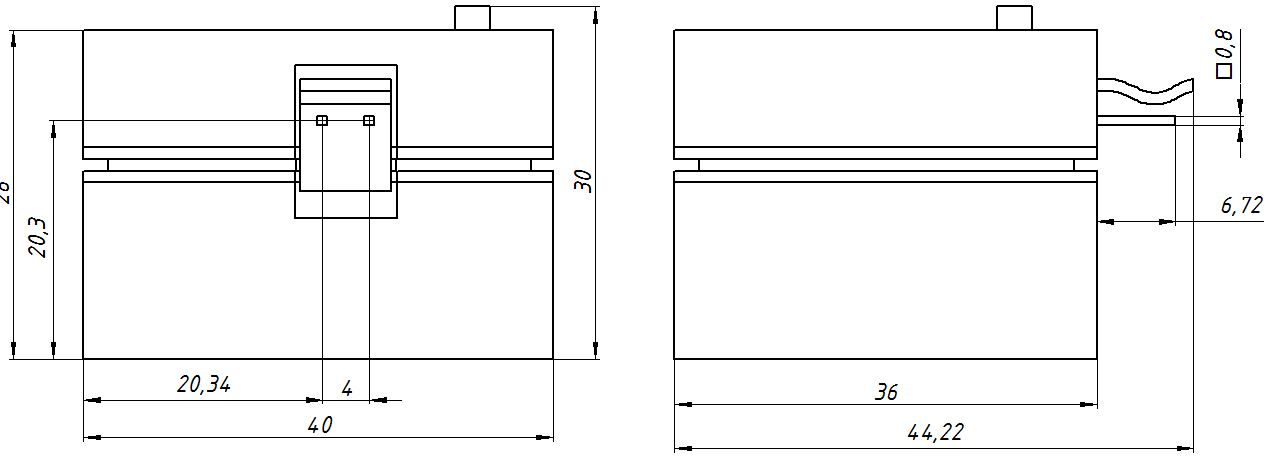
pic/extern1.JPG
