MBoldyrev/kurs_mark/pic/extern2.JPG

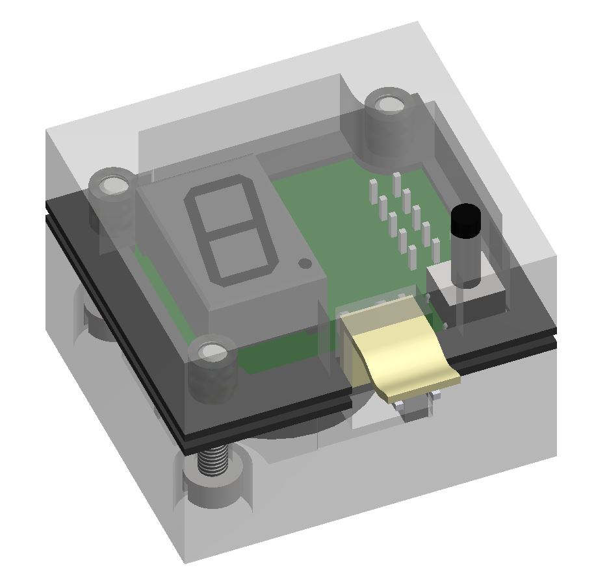
pic/extern2.JPG
