MBoldyrev/kurs_mark/pic/PP1SB.jpg

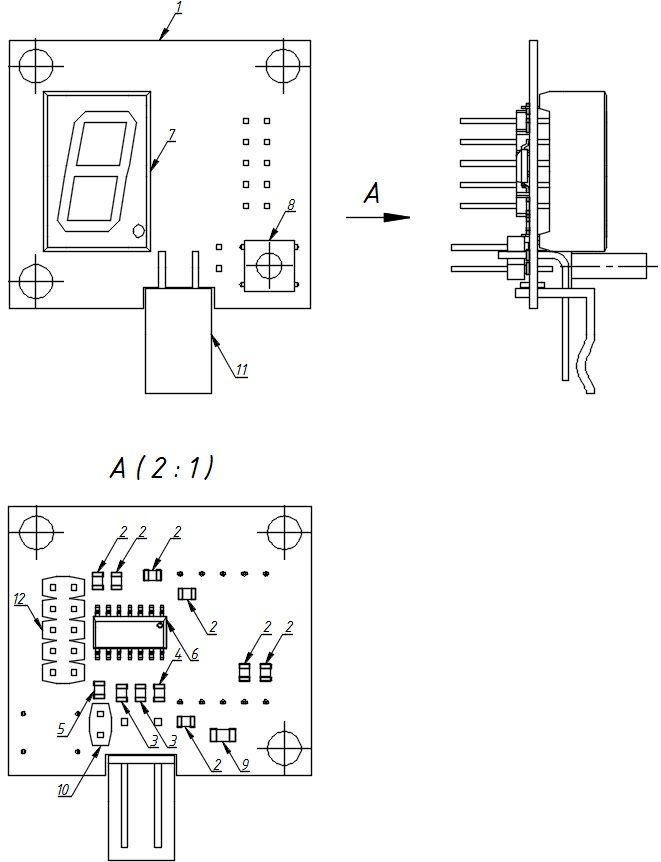
pic/PP1SB.jpg
