MBoldyrev/kurs_mark/pic/top1.JPG

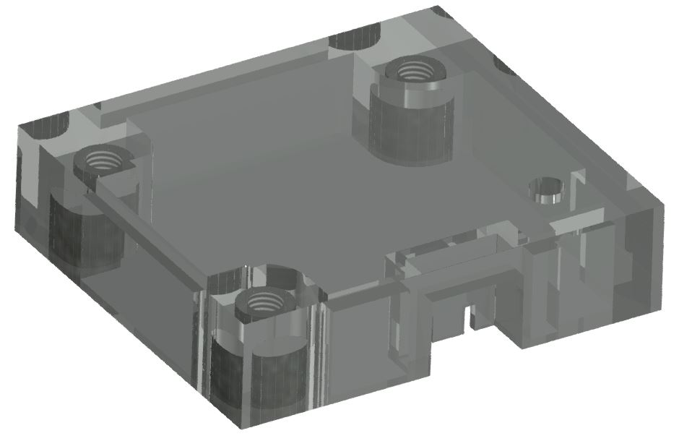
pic/top1.JPG
