MBoldyrev/kurs_mark/pic/top2.JPG

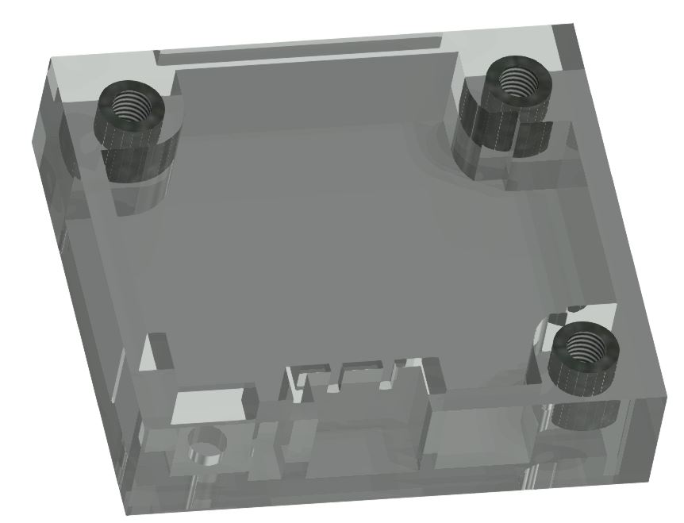
pic/top2.JPG
