MBoldyrev/kurs_mark/Inventor/fuel_level_1h2.step

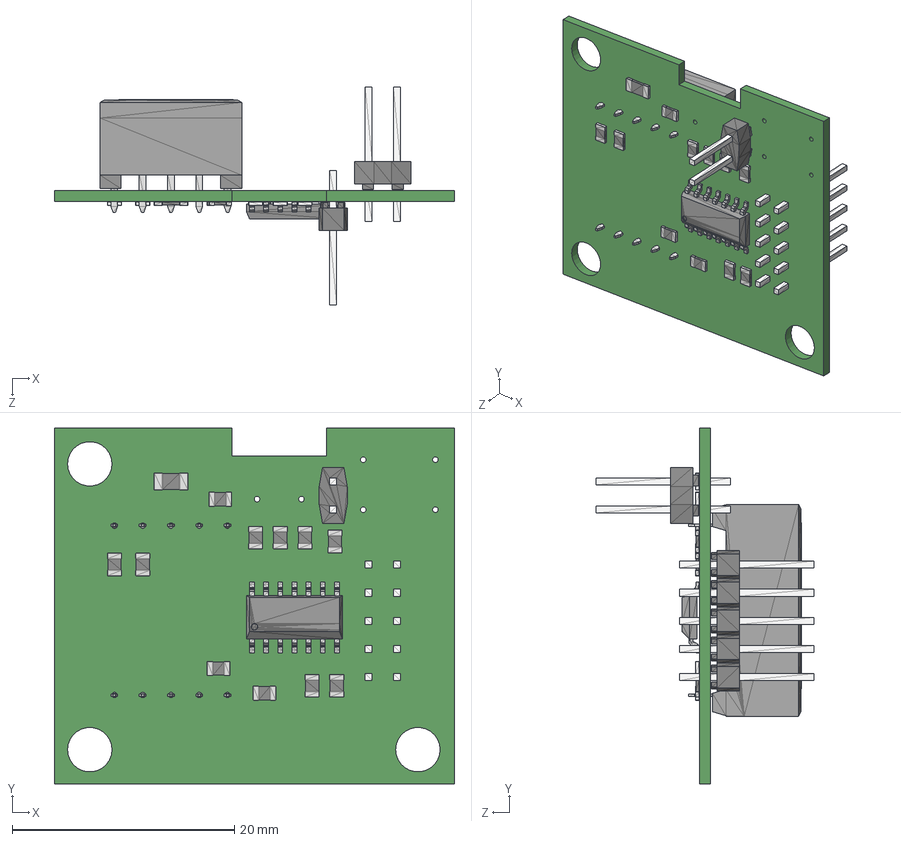
[picture p87: CAD file, 2015-12-07]
Inventor/fuel_level_1h2.step
36.0 x 32.0 x 19.6 mm
Board
dip-10d_600mil_17
hdr-2x5t_2.54x2.54_13x5
hdr-2x1t_2.54x2.54_3x5
res_0805 x 11
res_1206
soic-14_150mil
