MBoldyrev/kurs_mark/(list of files, cad)

Other CAD files:
Inventor/pcb_top_SB.dwg
Inventor/plots/KD.dwg
Inventor/pcb_btm_SB.dwg
Inventor/plots/resin_top.dwg
Inventor/plots/resin_bottom.dwg
Inventor/plots/corp.dwg
Inventor/plots/ext_SB.dwg
Inventor/plots/case_top.dwg
Inventor/plots/ext_VO.dwg
Inventor/plots/PP1SB3.dwg
Inventor/plots/case_bottom.dwg
Inventor/plots/all_vo.dwg
Inventor/plots/PP1SB.dwg
Inventor/plots/all_sb.dwg
Inventor/OldVersions/ext_VO.0001.dwg
Inventor/plots/OldVersions/resin_top.0007.dwg
Inventor/OldVersions/pcb_top_SB.0003.dwg
Inventor/Board.ipt
Inventor/Imported Components/fuel_level_1h2/Board.ipt
Inventor/Imported Components/fuel_level_1h2/OldVersions/Board.0001.ipt
Inventor/Imported Components/fuel_level_1h2/OldVersions/fuel_level_1h2.0007.iam
Inventor/Imported Components/fuel_level_1h2/dip-10d_600mil_17.ipt
Inventor/Imported Components/fuel_level_1h2/fuel_level_1h2.iam
Inventor/Imported Components/fuel_level_1h2/hdr-2x1t_2.54x2.54_3x5.ipt
Inventor/Imported Components/fuel_level_1h2/hdr-2x5t_2.54x2.54_13x5.ipt
Inventor/Imported Components/fuel_level_1h2/res_0805.ipt
Inventor/Imported Components/fuel_level_1h2/res_1206.ipt
Inventor/Imported Components/fuel_level_1h2/soic-14_150mil.ipt
Inventor/MOLEX.ipt
Inventor/OldVersions/Board.0001.ipt
Inventor/OldVersions/MOLEX.0002.ipt
Inventor/OldVersions/all.0001.dwg
Inventor/OldVersions/all.0006.iam
Inventor/OldVersions/all_sb.0002.dwg
Inventor/OldVersions/bonka.0002.ipt
Inventor/OldVersions/bs-7.0002.ipt
Inventor/OldVersions/button.0006.ipt
Inventor/OldVersions/case_bottom.0032.ipt
Inventor/OldVersions/case_top.0010.ipt
Inventor/OldVersions/conn_sensor.0006.ipt
Inventor/OldVersions/dat4.0008.ipt
Inventor/OldVersions/ext.0089.iam
Inventor/OldVersions/ext_SB.0006.dwg
Inventor/OldVersions/fuel_level_1h.0002.iam
Inventor/OldVersions/jumper.0002.ipt
Inventor/OldVersions/pcb_btm.0001.ipt
Inventor/OldVersions/pcb_btm.0006.iam
Inventor/OldVersions/pcb_btm_SB.0001.dwg
Inventor/OldVersions/pcb_top.0003.iam
Inventor/OldVersions/resin_bottom.0005.ipt
Inventor/OldVersions/resin_top.0006.ipt
Inventor/OldVersions/screw_M3-16.0009.ipt
Inventor/OldVersions/screw_M4-10.0012.ipt
Inventor/OldVersions/Сборка3.0060.iam
Inventor/OldVersions/Сборка4.0073.iam
Inventor/OldVersions/внеш.ВО.0002.dwg
Inventor/all.iam
Inventor/bonka.ipt
Inventor/bs-7.ipt
Inventor/button.ipt
Inventor/case.ipt
Inventor/case_bottom.ipt
Inventor/case_top.ipt
Inventor/conn_sensor.ipt
Inventor/dat4.ipt
Inventor/dip-10d_600mil_17.ipt
Inventor/ext.iam
Inventor/fuel_level_1h.iam
Inventor/hdr-2x1t_2.54x2.54_3x5.ipt
Inventor/hdr-2x5t_2.54x2.54_13x5.ipt
Inventor/jumper.ipt
Inventor/pcb_btm.iam
Inventor/pcb_btm.ipt
Inventor/pcb_top.iam
Inventor/plots/OldVersions/PP1SB3.0006.dwg
Inventor/plots/OldVersions/all_sb.0004.dwg
Inventor/plots/OldVersions/all_vo.0004.dwg
Inventor/plots/OldVersions/case_bottom.0012.dwg
Inventor/plots/OldVersions/case_top.0009.dwg
Inventor/plots/OldVersions/corp.0004.dwg
Inventor/plots/OldVersions/ext_SB.0019.dwg
Inventor/plots/OldVersions/ext_VO.0007.dwg
Inventor/plots/OldVersions/ext_VO1.0001.dwg
Inventor/plots/OldVersions/resin_bottom.0004.dwg
Inventor/plots/OldVersions/хуйня.0001.dwg
Inventor/res_0805.ipt
Inventor/res_1206.ipt
Inventor/resin_bottom.ipt
Inventor/resin_top.ipt
Inventor/screw_M3-16.ipt
Inventor/screw_M4-10.ipt
Inventor/soic-14_150mil.ipt
Inventor/Сборка3.iam
