MBoldyrev/kurs_mark/PRINT/A4_color/titul.pdf

федеральное государственное бюджетное образовательное учреждение высшего профессионального образования

«Московский государственный технический университет имени Н.Э. Баумана»

(МГТУ им. Н.Э. Баумана)

ФАКУЛЬТЕТ | Информатики и систем управления
КАФЕДРА | Проектирования и технологии производства ЭА

Р А С Ч Ё Т Н О - П О Я С Н И Т Е Л Ь Н А Я З А П И С К А

к курсовой работе

по курсу | «Теоретические основы конструирования и надежности»
на тему | Измеритель уровня топлива
Студент | Болдырев М.Д.
(Подпись, дата) | (И.О.Фамилия)
Руководитель домашнего задания | Маркелов В.В.
(Подпись, дата) | (И.О.Фамилия)
Консультант | Маркелов В.В.
(Подпись, дата) | (И.О.Фамилия)

Отметки о сдаче домашнего задания:

Москва, 2015
