MBoldyrev/kurs_mark/PRINT/A3/Э1.jpg

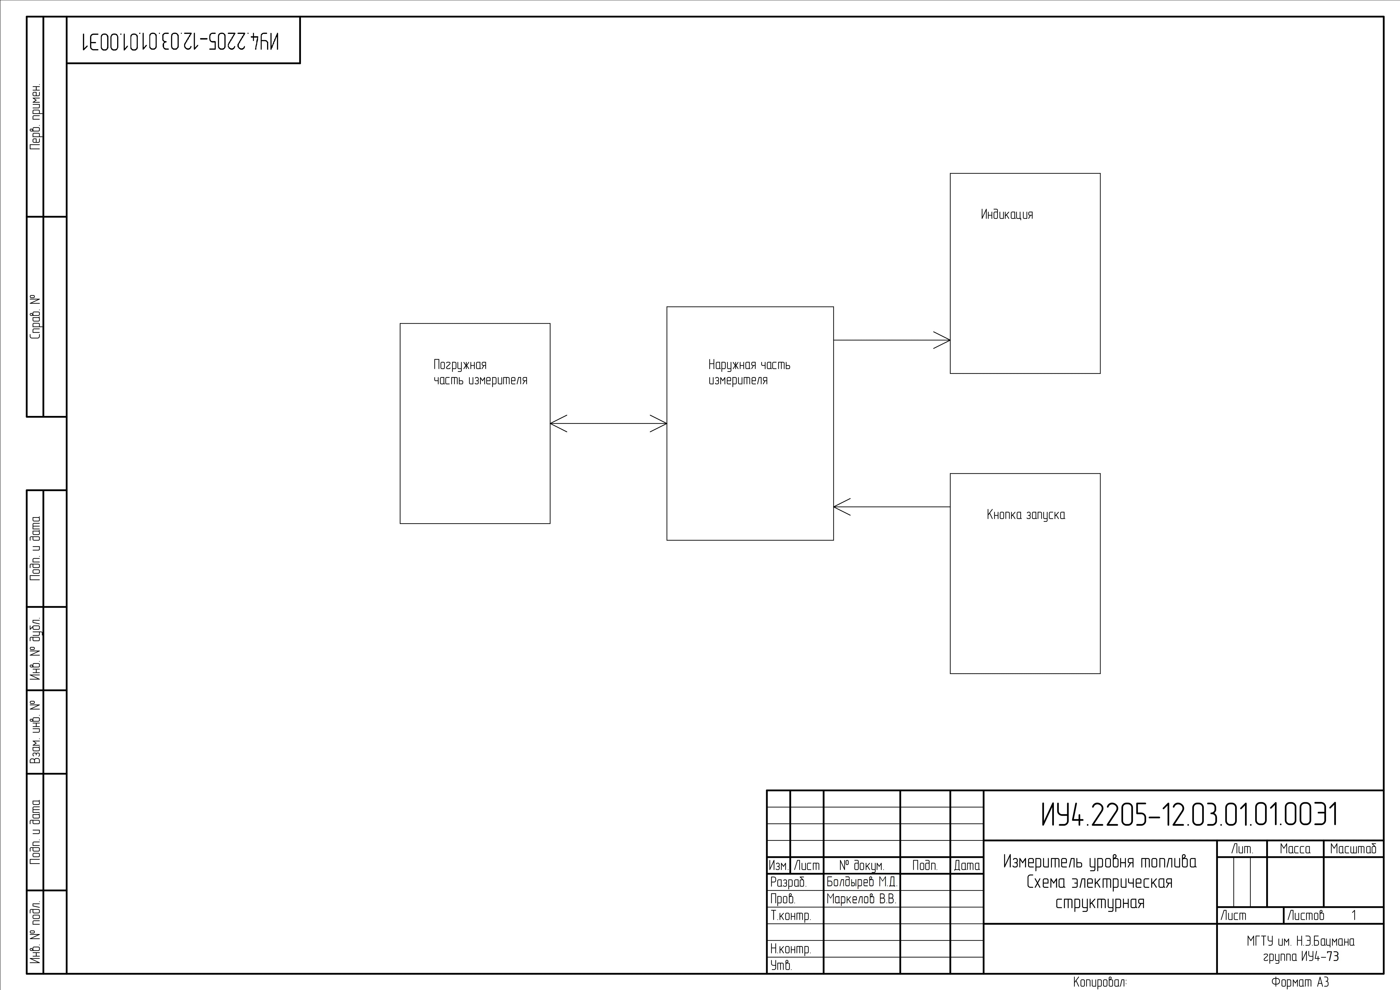
PRINT/A3/Э1.jpg
