MBoldyrev/kurs_mark/PRINT/A3/Э2.jpg

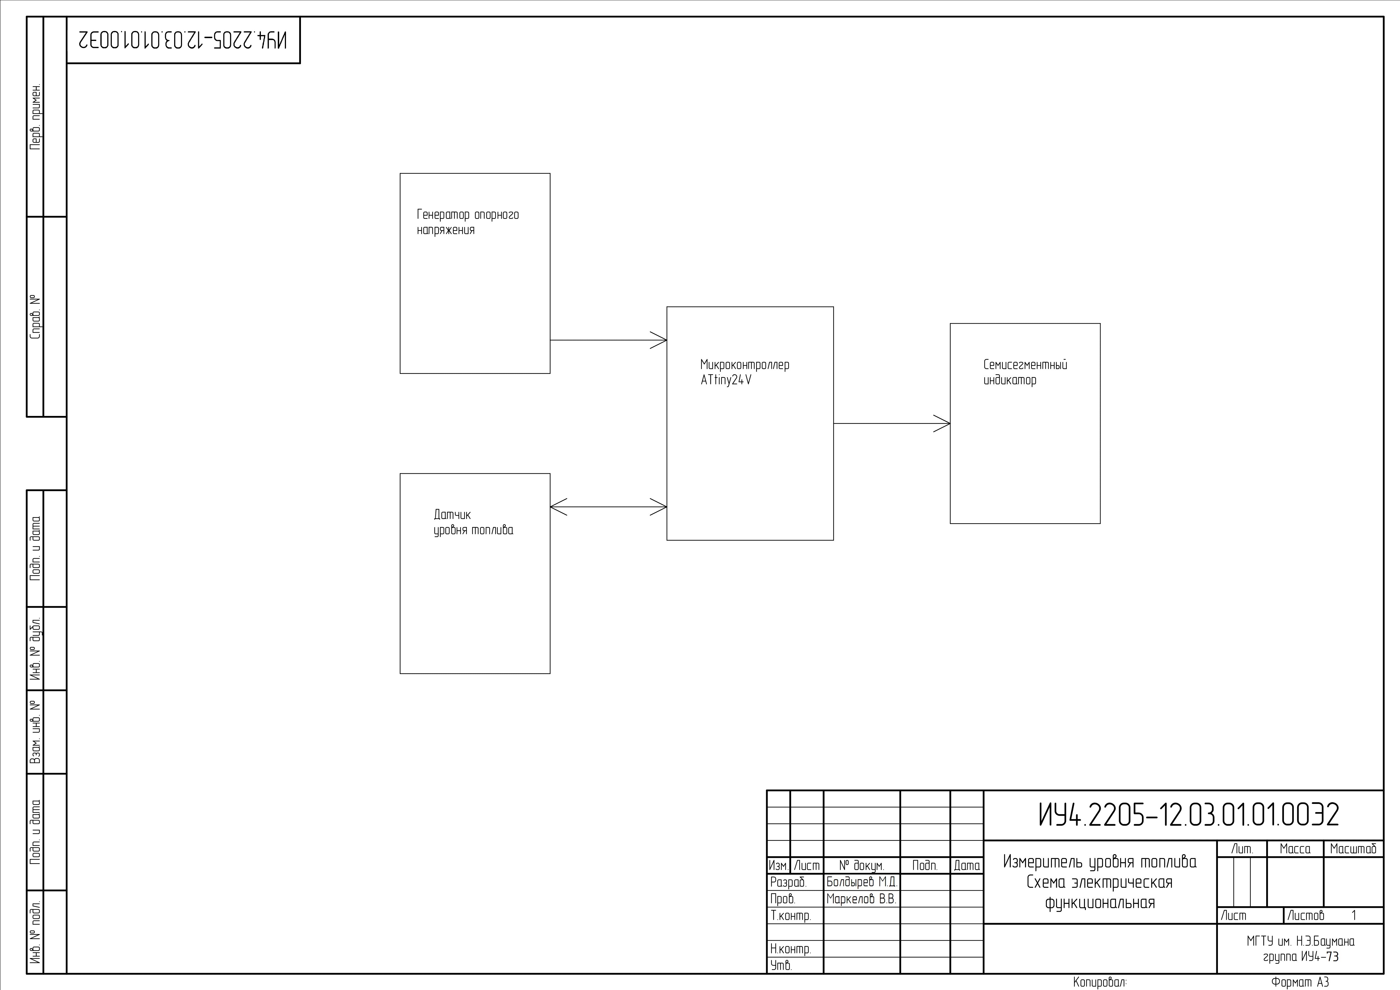
PRINT/A3/Э2.jpg
