MBoldyrev/kurs_mark/PRINT/A3/Э3.jpg

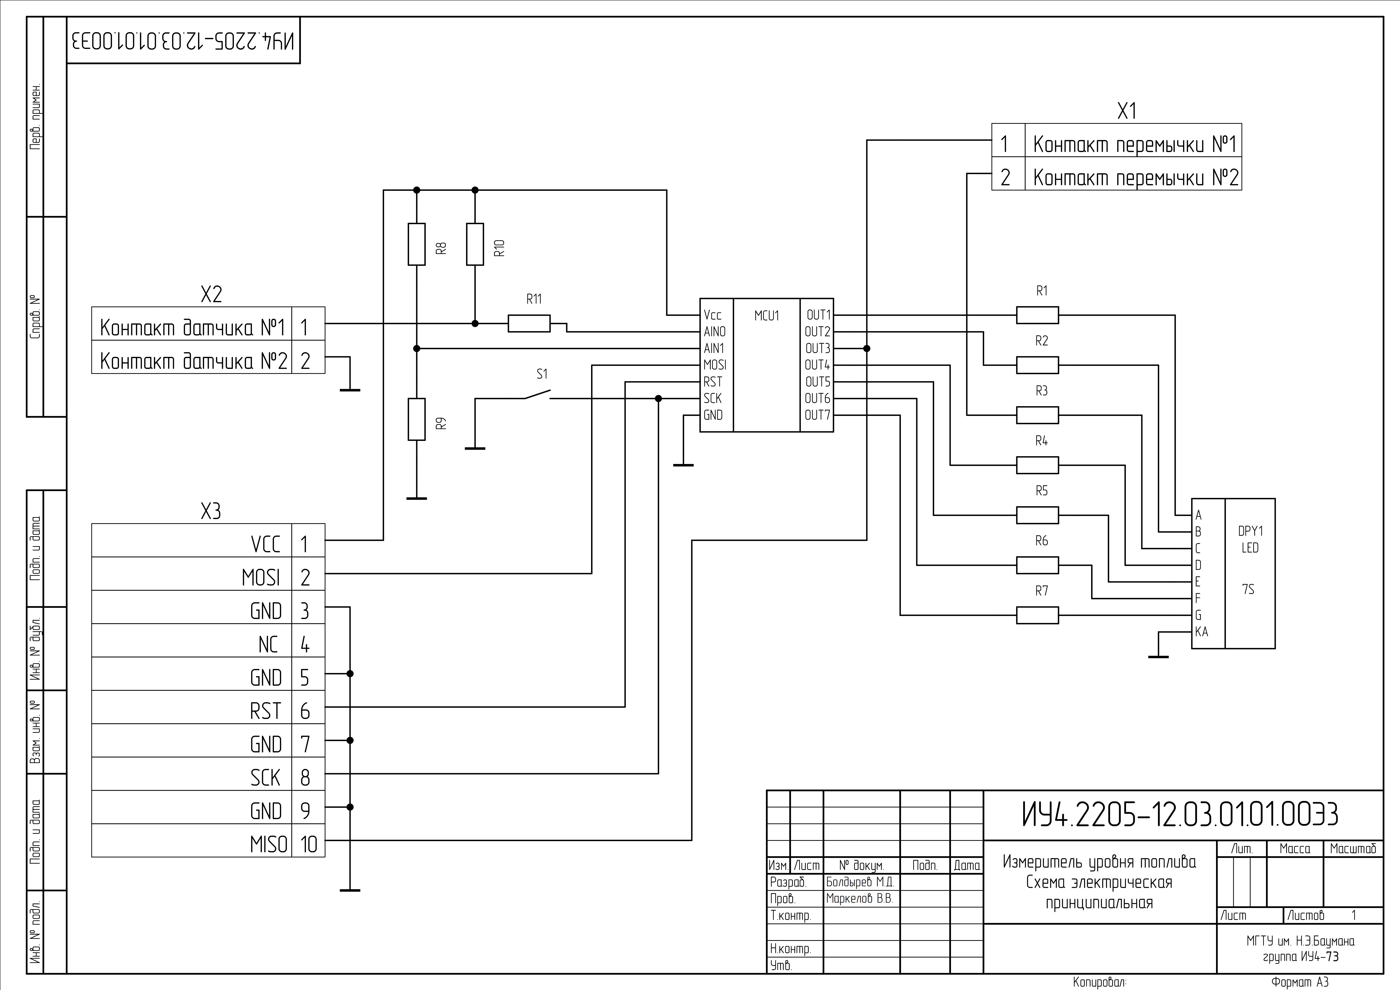
PRINT/A3/Э3.jpg
