MBoldyrev/kurs_mark/PRINT/A4_bw/ПЭ3.jpg

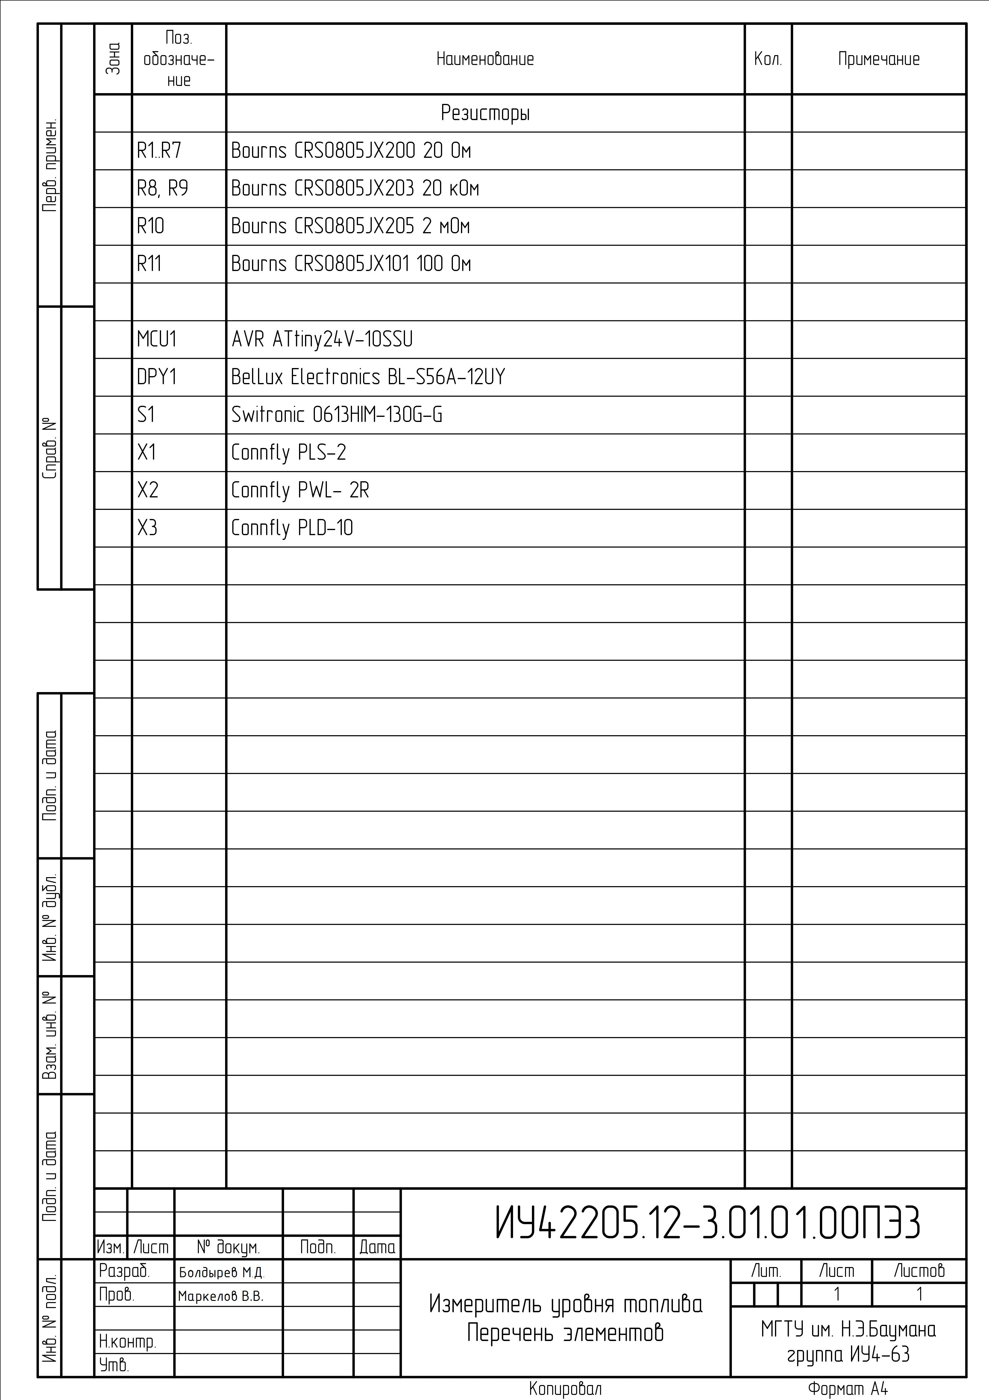
PRINT/A4_bw/ПЭ3.jpg
