MBoldyrev/kurs_mark/PRINT/A3/PP1.pdf

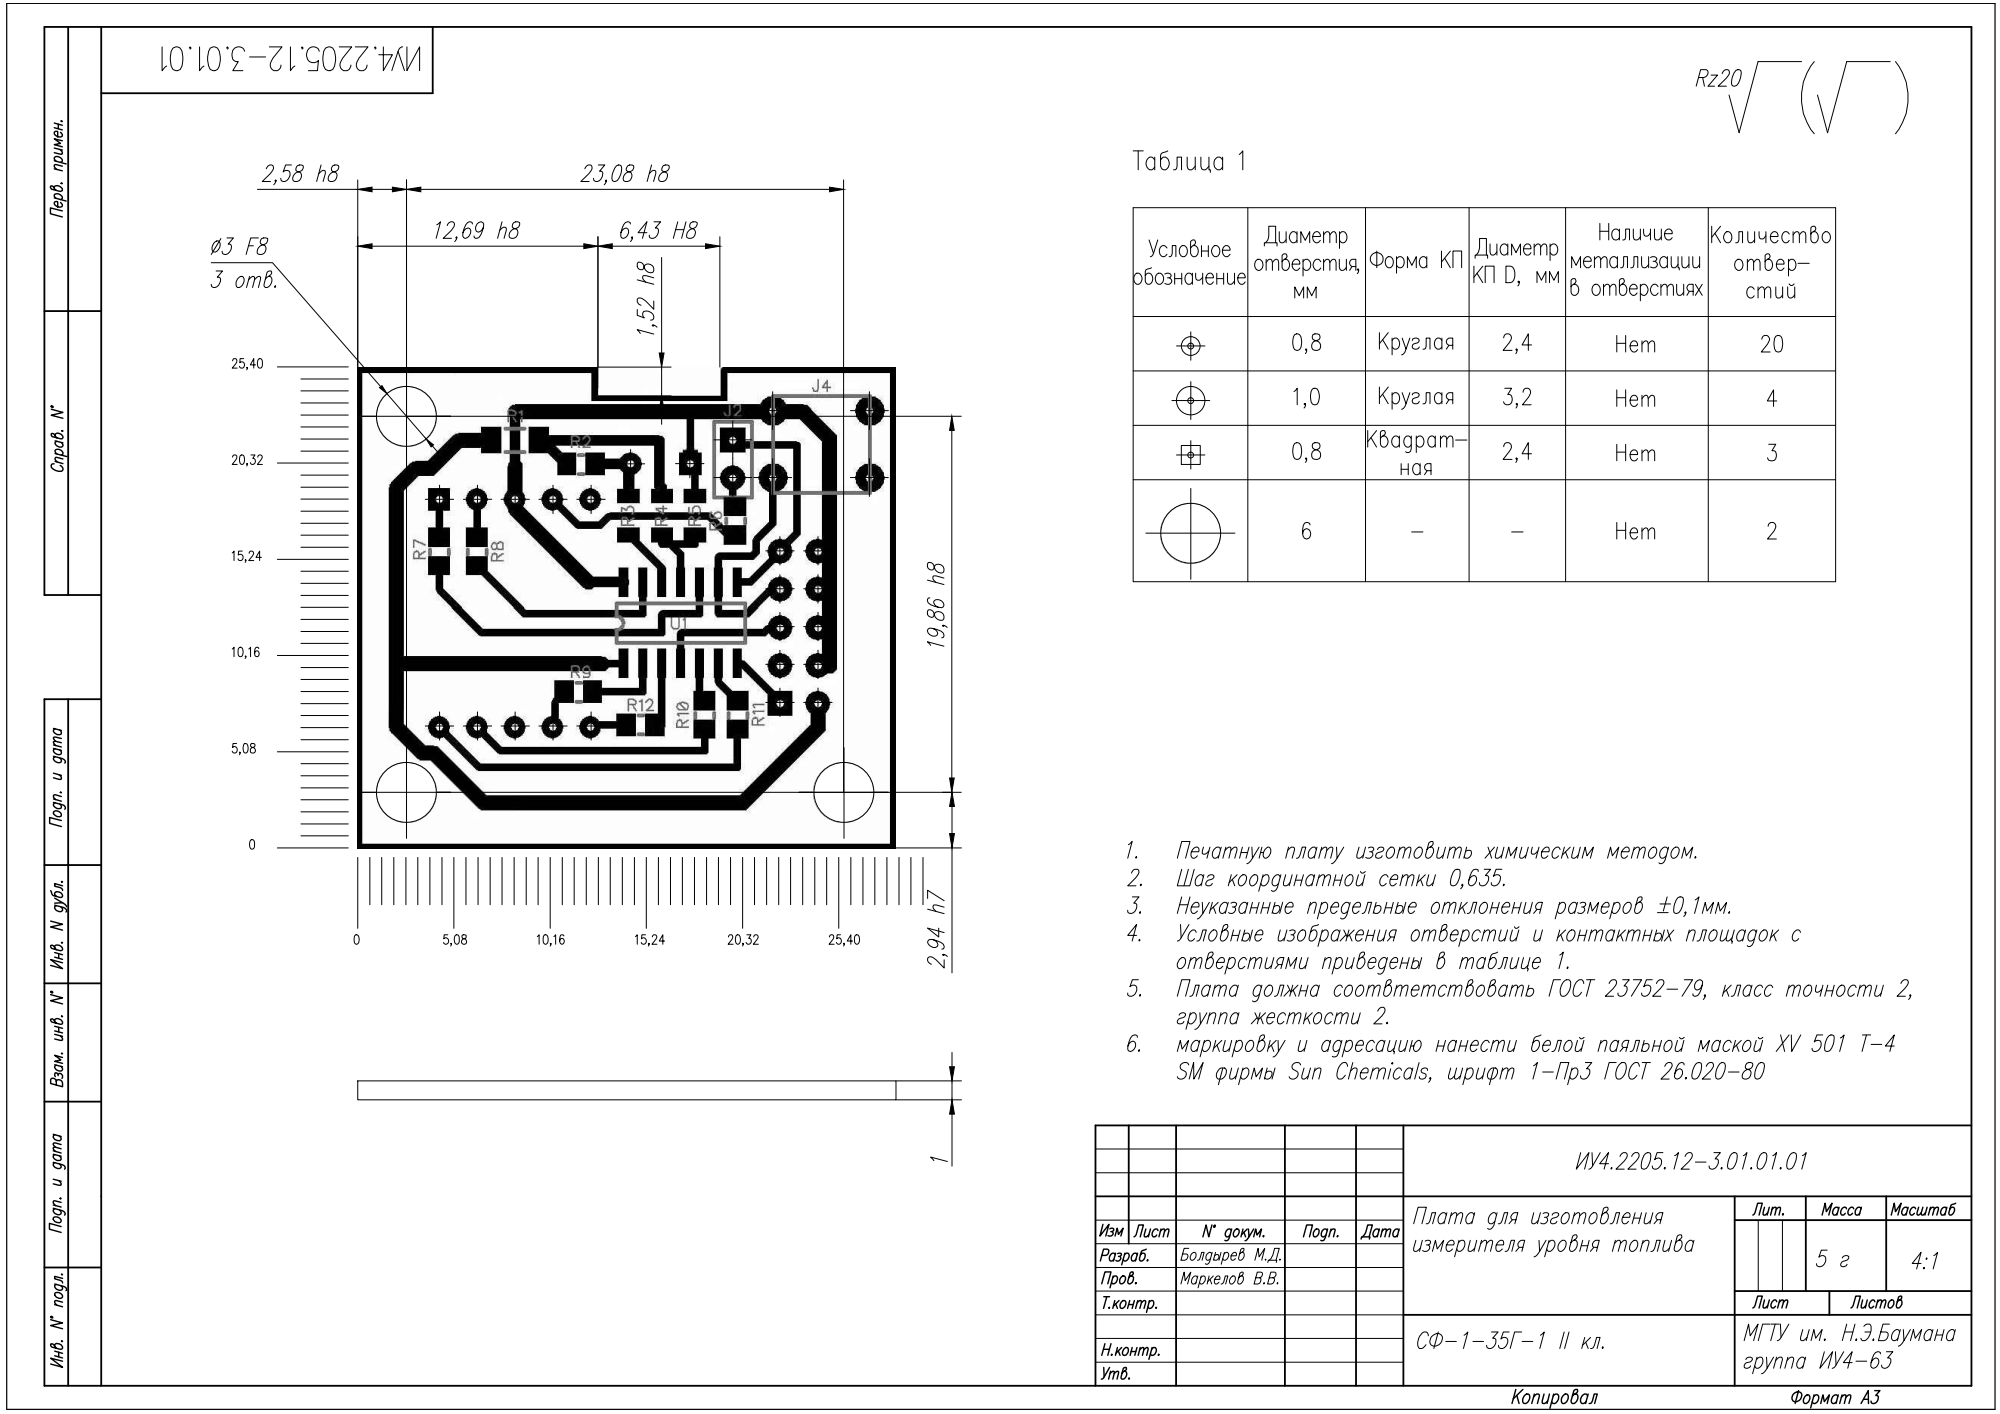
[picture p92: page 1]
