MBoldyrev/kurs_mark/ot_Mansh/A1_Sborka_yach.pdf

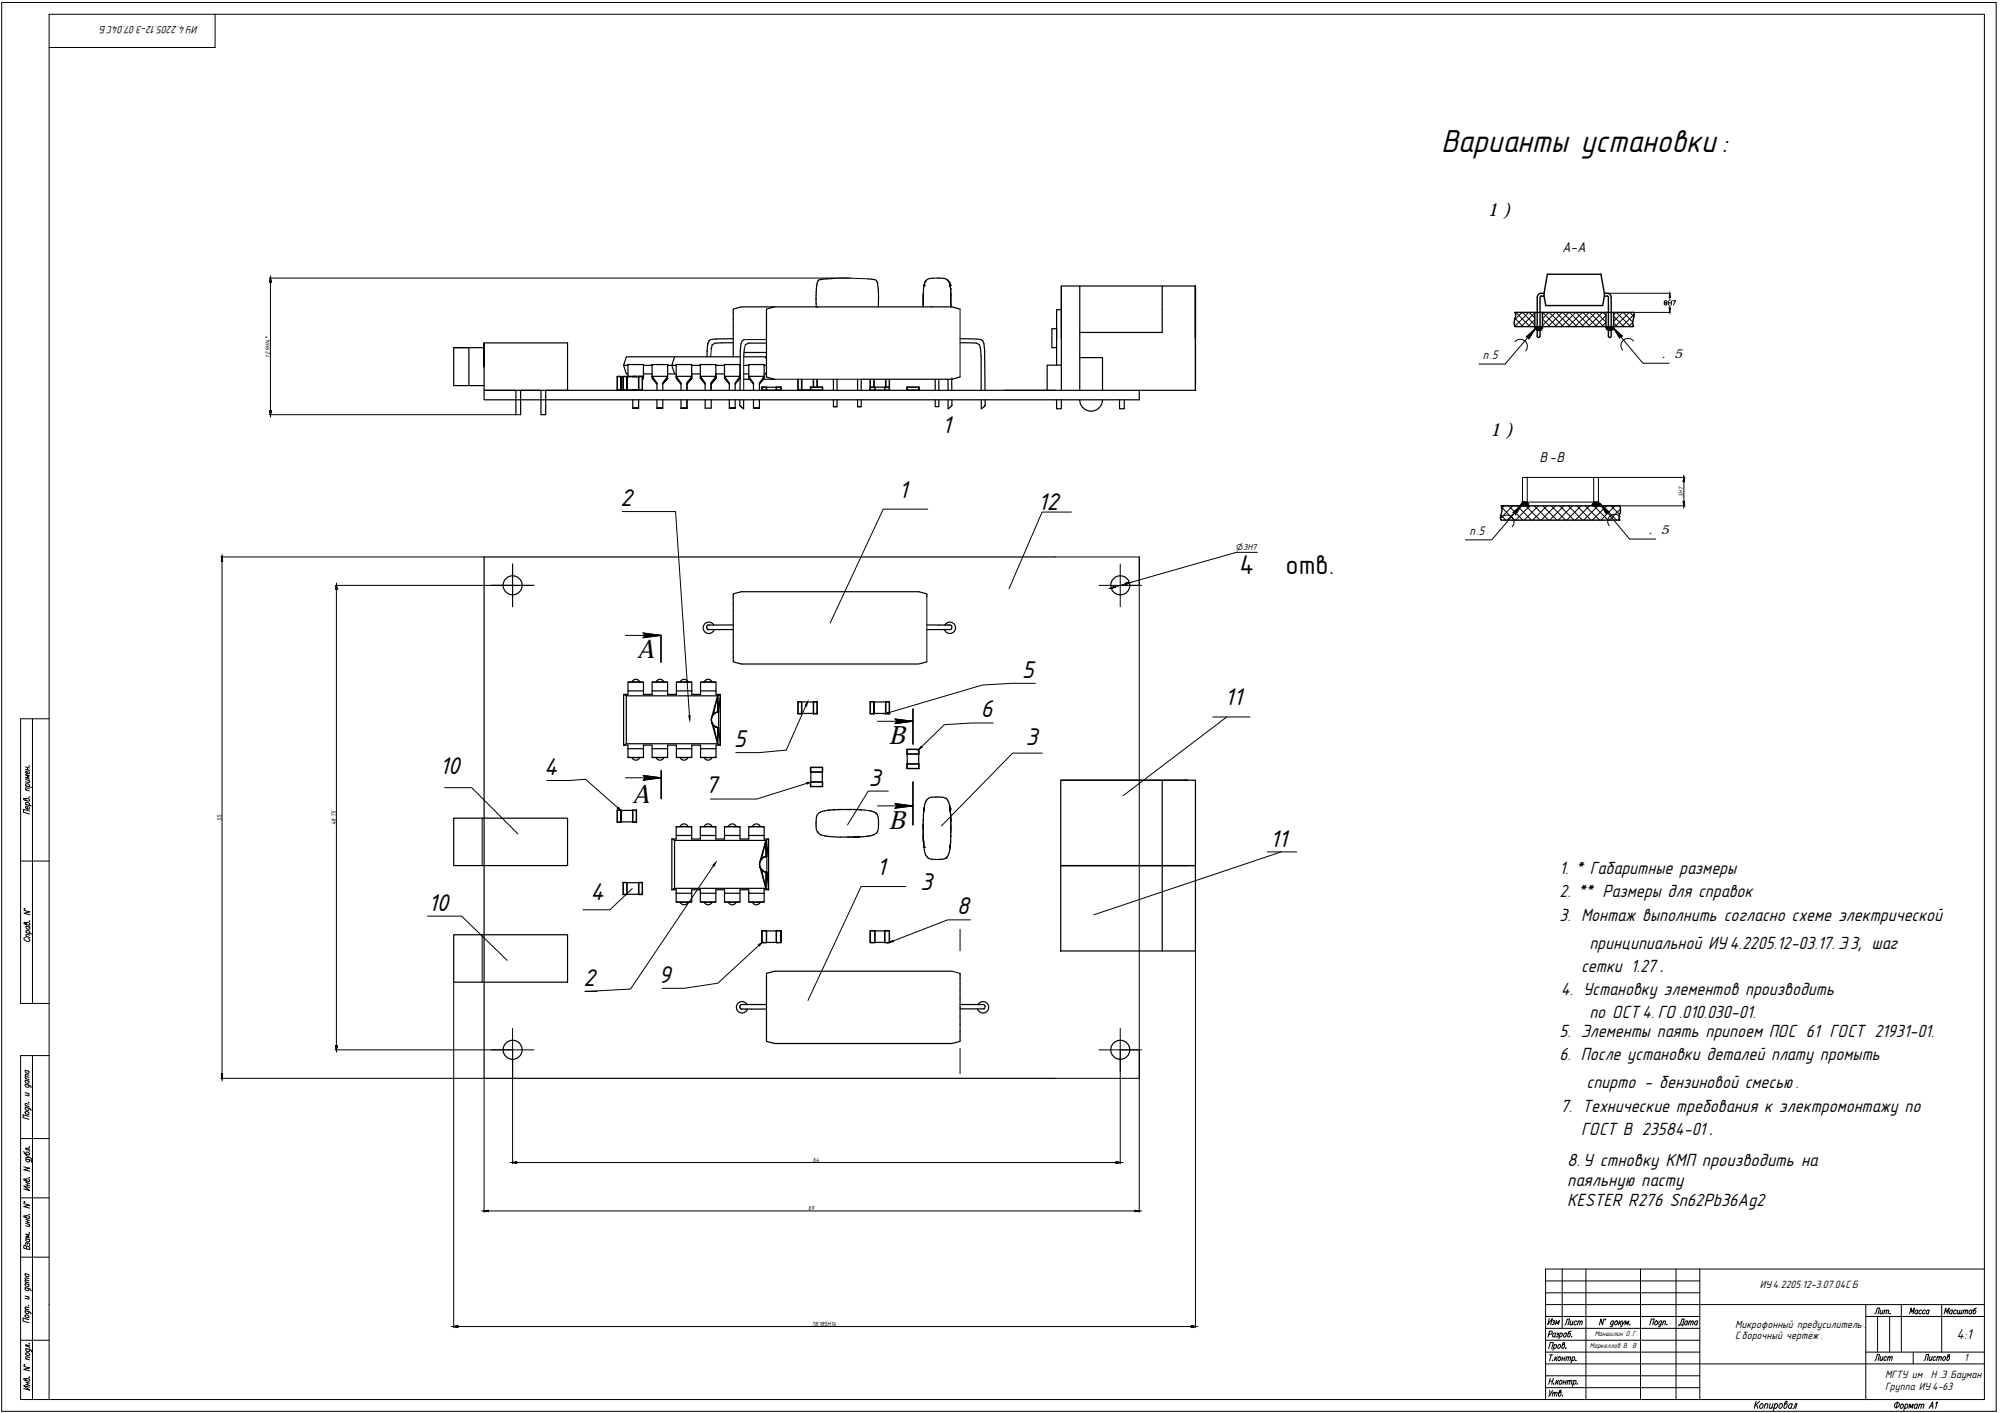
[picture p93: page 1]
Варианты установки :; ГОСТ В 23584-01 .

1)Установка КМО компонентов 3H7

1)Установка КМП компонентов

1. * Габаритные размеры
2. ** Размеры для справок
3. Монтаж выполнить согласно схеме электрической принципиальной ИУ 4.2205.12-03.17. Э 3, шаг

сетки 1.27 . 4. Установку элементов производить по ОСТ 4. ГО .010.030-01.

5. Элементы паять припоем ПОС 61 ГОСТ 21931-01.
6. После установки деталей плату промыть спирто - бензиновой смесью . 7. Технические требования к электромонтажу по

8. У стновку КМП производить на
паяльную пасту
KESTER R276 Sn62Pb36Ag2

Микрофонный предусилитель . C борочный чертёж . Маншилин О .Г .

Маркеллов В . В . | МГТУ им . Н .Э .Бауман | 1

Группа ИУ 4-63
