MBoldyrev/kurs_mark/ot_Mansh/A3_E1.pdf

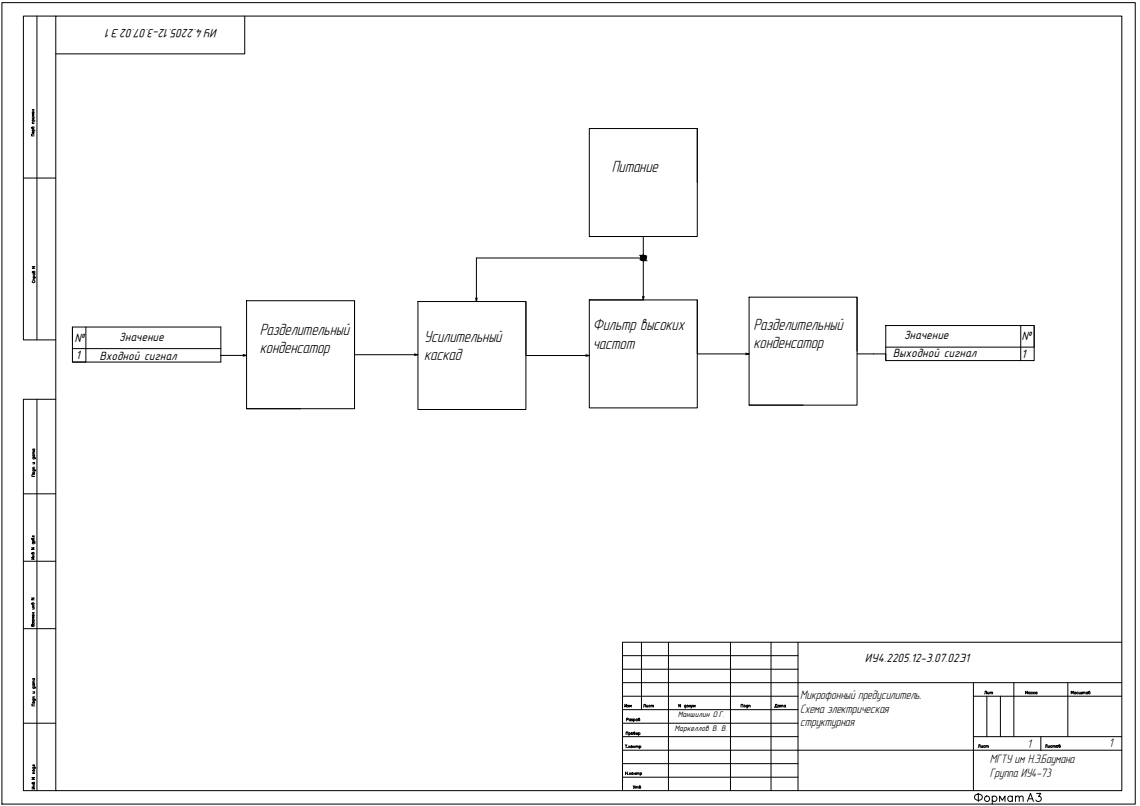
[picture p94: page 1]
Фильтр высоких; конденсатор №; Значение; Входной сигнал; Выходной сигнал

Микрофонный предусилитель. Схема электрическая структурная

Маншилин О.Г.
Маркеллов В. В.

МГТУ им Н.Э.Баумана Группа ИУ4-73
