MBoldyrev/kurs_mark/ot_Mansh/A3_E2.pdf

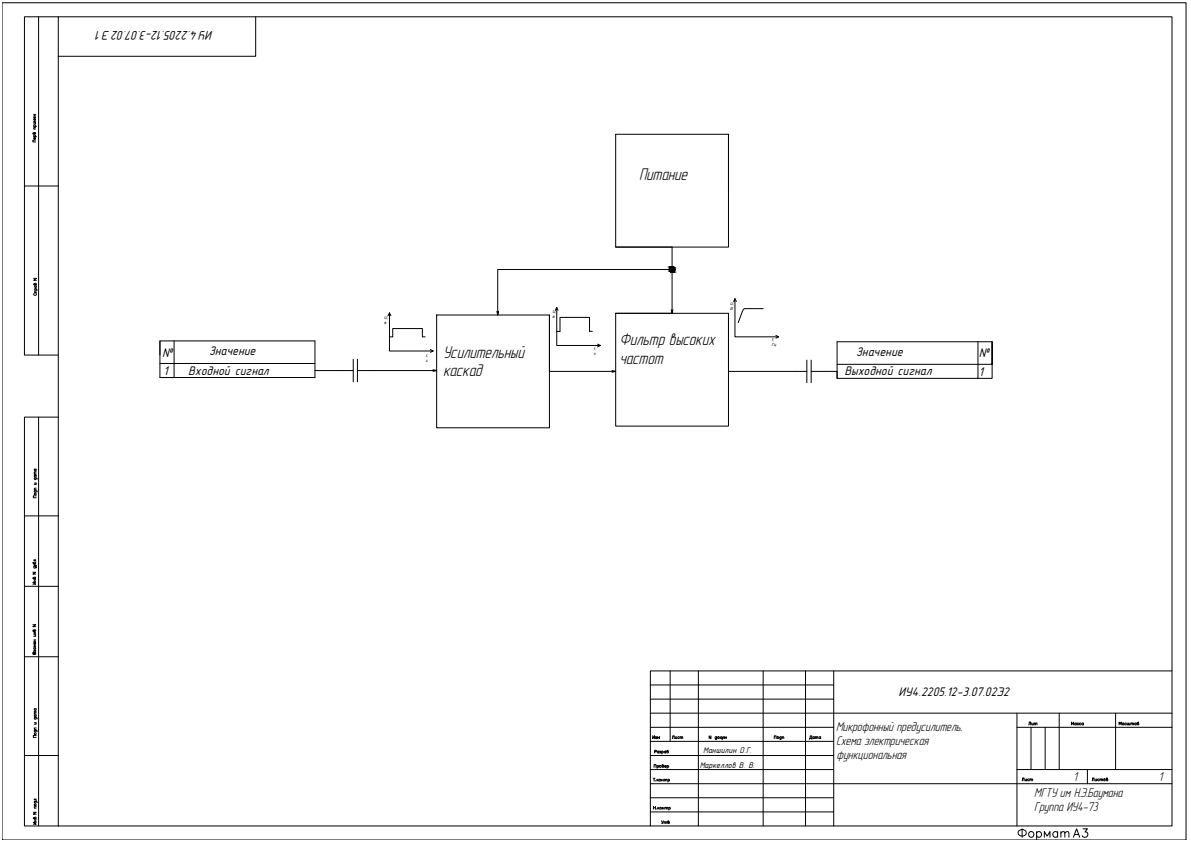
[picture p95: page 1]
Фильтр высоких; Входной сигнал; Выходной сигнал

Микрофонный предусилитель. Схема электрическая функциональная

Маншилин О.Г.
Маркеллов В. В.

МГТУ им Н.Э.Баумана Группа ИУ4-73
