MBoldyrev/kurs_mark/ot_Mansh/A3_E3.pdf

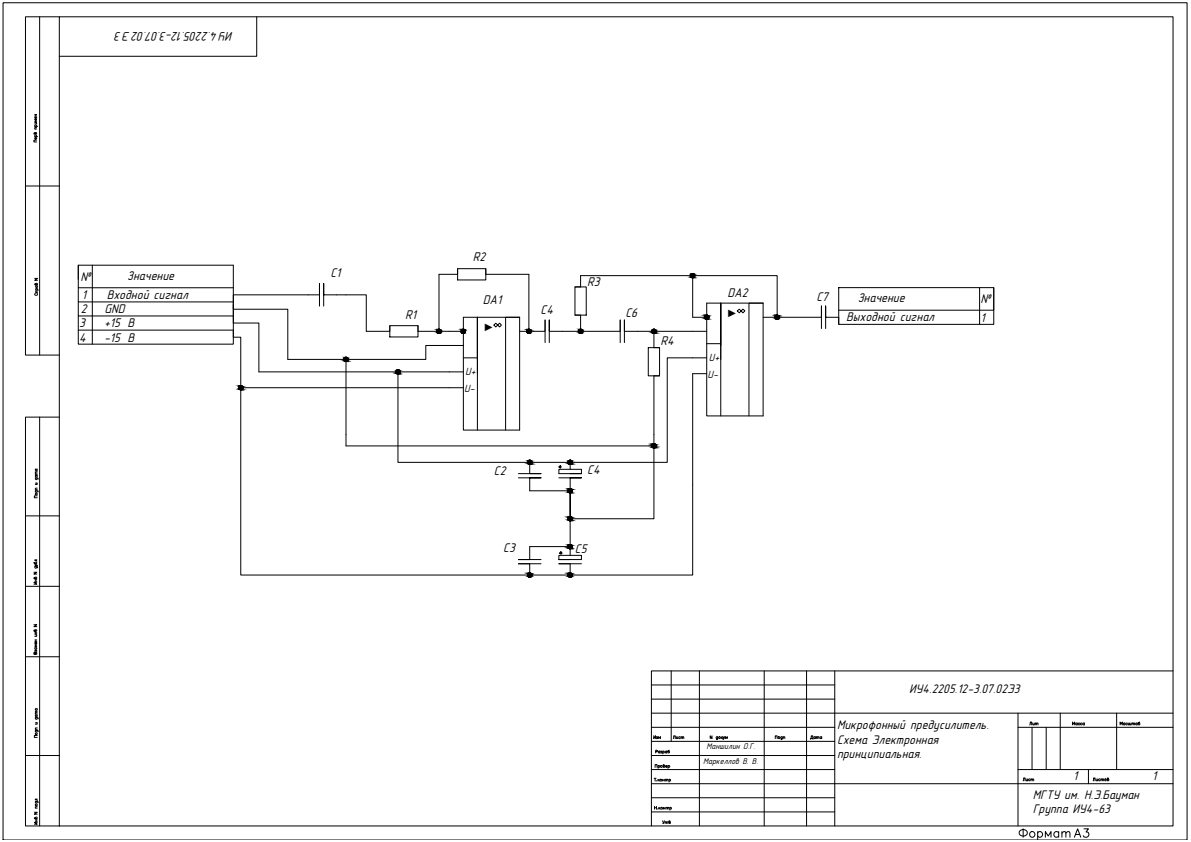
[picture p96: page 1]

Микрофонный предусилитель.

МГТУ им. Н.Э.Бауман Группа ИУ4-63
