MBoldyrev/kurs_mark/ot_Mansh/Krishka_Korp.pdf

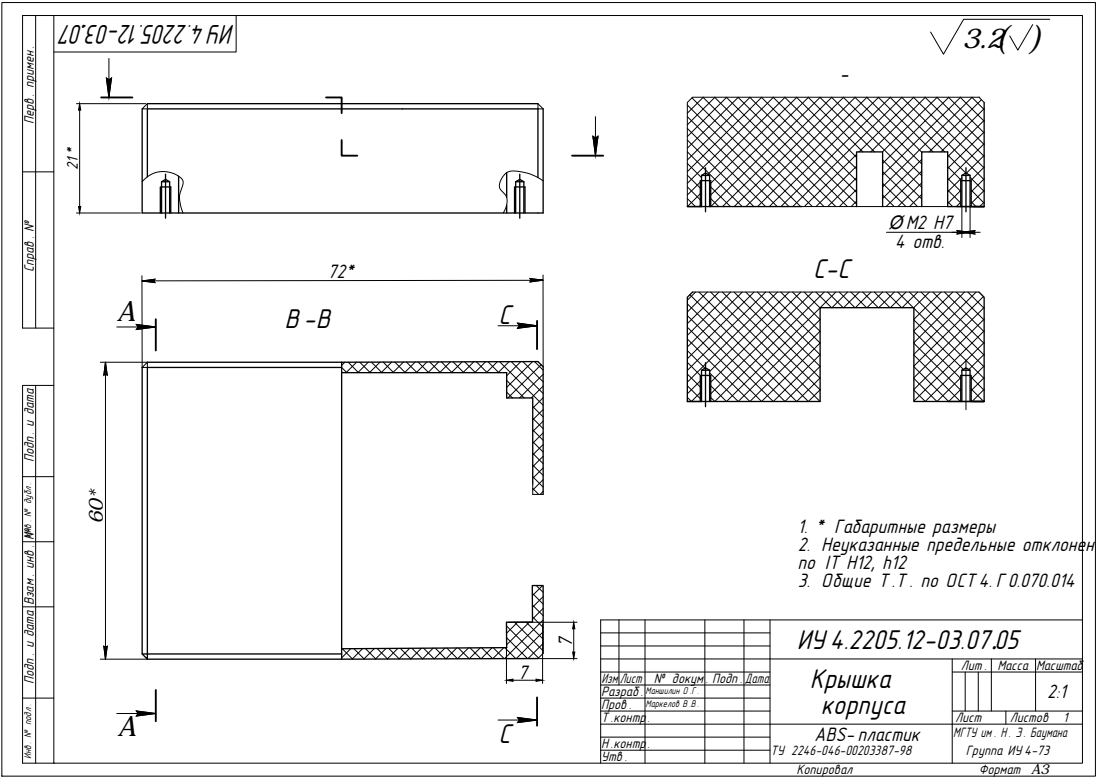
[picture p97: page 1]
Ø М2 H7 4 отв.; Изм Лист .; № докум . Подп . Дата; Лит . Разраб . Пров . Т .контр .; Лист; Листов Н .контр . Утв .; ABS- пластик ТУ 2246-046-00203387-98; Маншилин О .Г . Маркелов В .В .; МГТУ им . Н . Э . Баумана; Группа ИУ 4-73 Инв . № подл . Подп . и дата Взам . инв . №Инв . № дубл . Подп . и дата Справ . № Перв . примен .; Копировал; Формат A3

1. * Габаритные размеры
2. Неуказанные предельные отклонения
3. Общие Т .Т . по ОСТ 4. Г 0.070.014
