MBoldyrev/kurs_mark/ot_Mansh/Osnovanie_korpusa.pdf

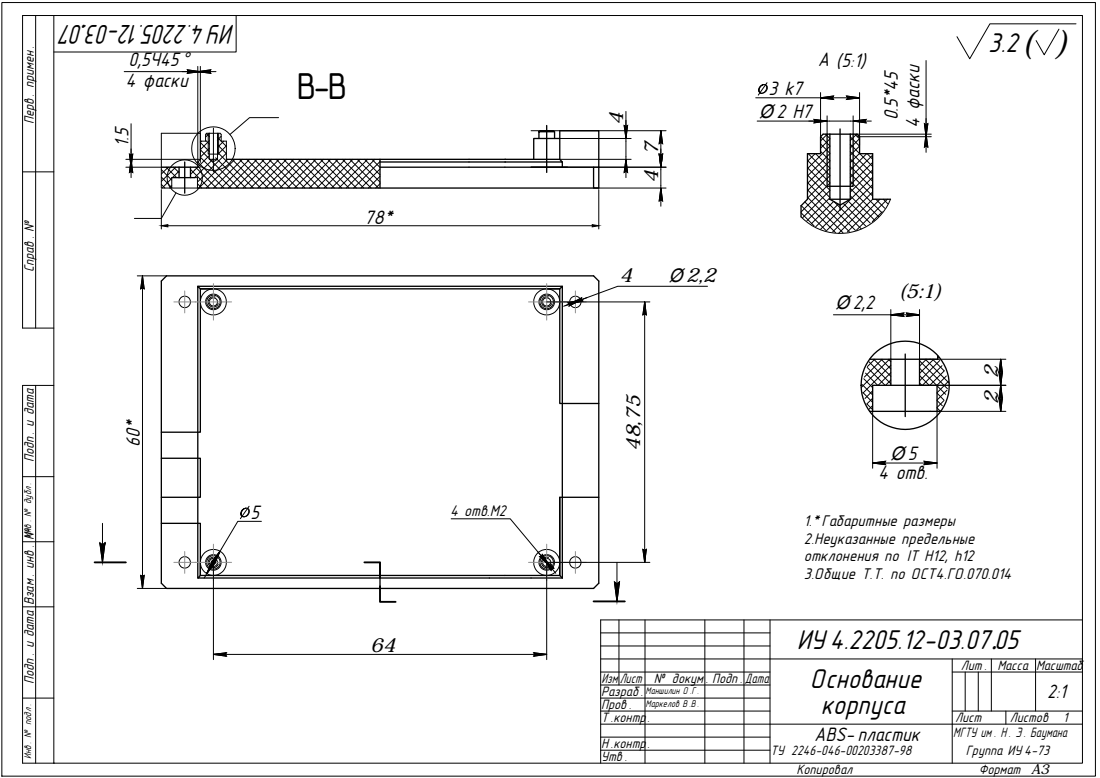
[picture p98: page 1]
1.5 60* А (5:1) 0.5*45 4 фаски 5; 0,5×45 ° 4 фаски; 4 отв.М2; 4 отв. Ø 2,2; 4 отв.; Изм Лист .; № докум . Подп . Дата; Лит . Разраб . Пров . Т .контр .; Лист; Листов Н .контр . Утв .; ABS- пластик ТУ 2246-046-00203387-98; Маншилин О .Г . Маркелов В .В .; МГТУ им . Н . Э . Баумана; Группа ИУ 4-73 Инв . № подл . Подп . и дата Взам . инв . №Инв . № дубл . Подп . и дата Справ . № Перв . примен .; Копировал; Формат A3

1.* Габаритные размеры
2.Неуказанные предельные
отклонения по IT H12, h12
3.Общие Т.Т. по ОСТ4.ГО.070.014
