MBoldyrev/kurs_mark/ot_Mansh/sborka_yach.pdf

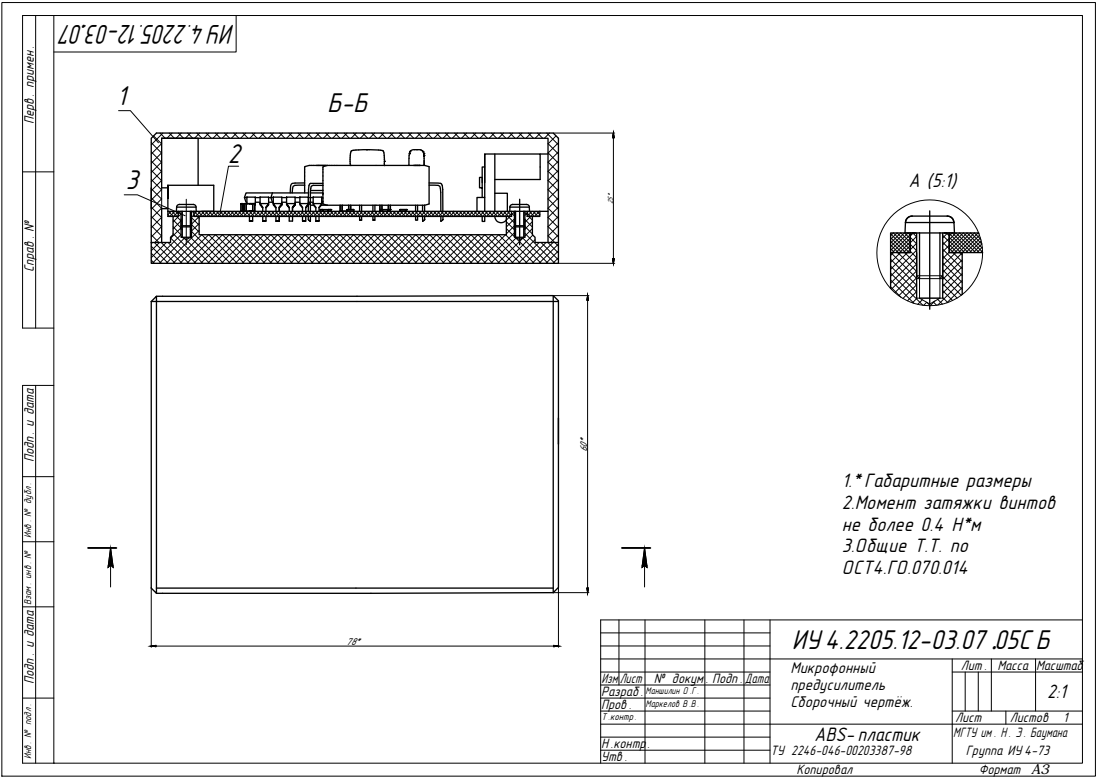
[picture p99: page 1]
Изм Лист .; № докум . Подп . Дата; Лит . Разраб . Пров . Т .контр .; Лист; Листов Н .контр . Утв .; ABS- пластик ТУ 2246-046-00203387-98; Маншилин О .Г . Маркелов В .В .; МГТУ им . Н . Э . Баумана; Группа ИУ 4-73 Инв . № подл . Подп . и дата Взам . инв . № Инв . № дубл . Подп . и дата Справ . № Перв . примен .; Копировал; Формат A3 А (5:1); ОСТ4.ГО.070.014 1; Сборочный чертёж.

1.* Габаритные размеры
2.Момент затяжки винтов
не более 0.4 Н*м
3.Общие Т.Т. по
