MBoldyrev/kurs_mark/Inventor/plots/pdf/all_vo.pdf

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

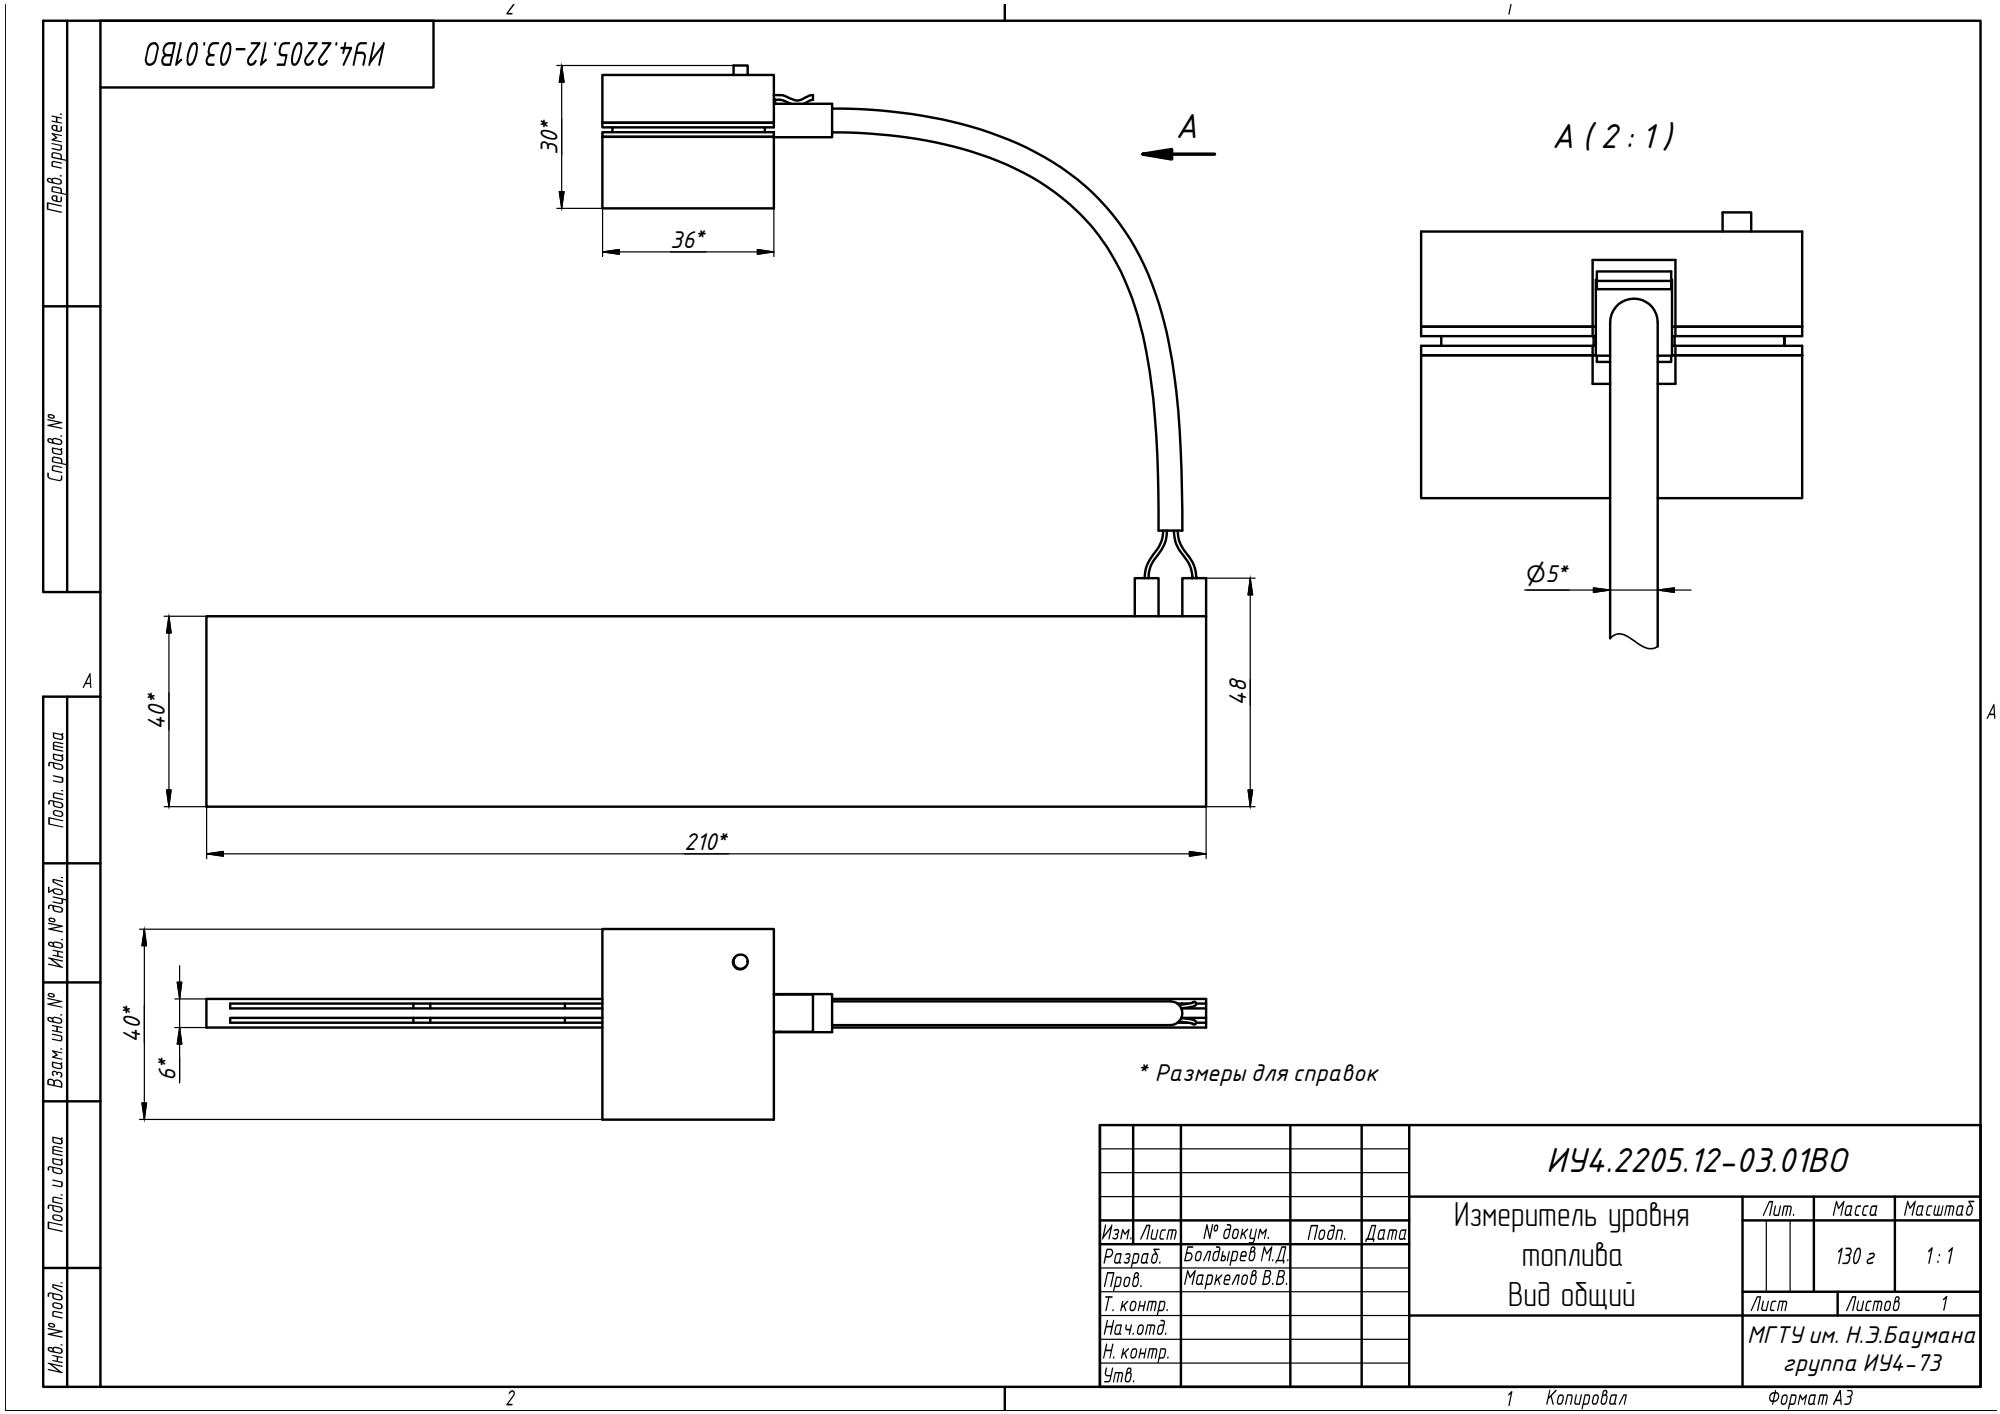
[picture p100: page 1]
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
