MBoldyrev/kurs_mark/Inventor/plots/pdf/KD.pdf

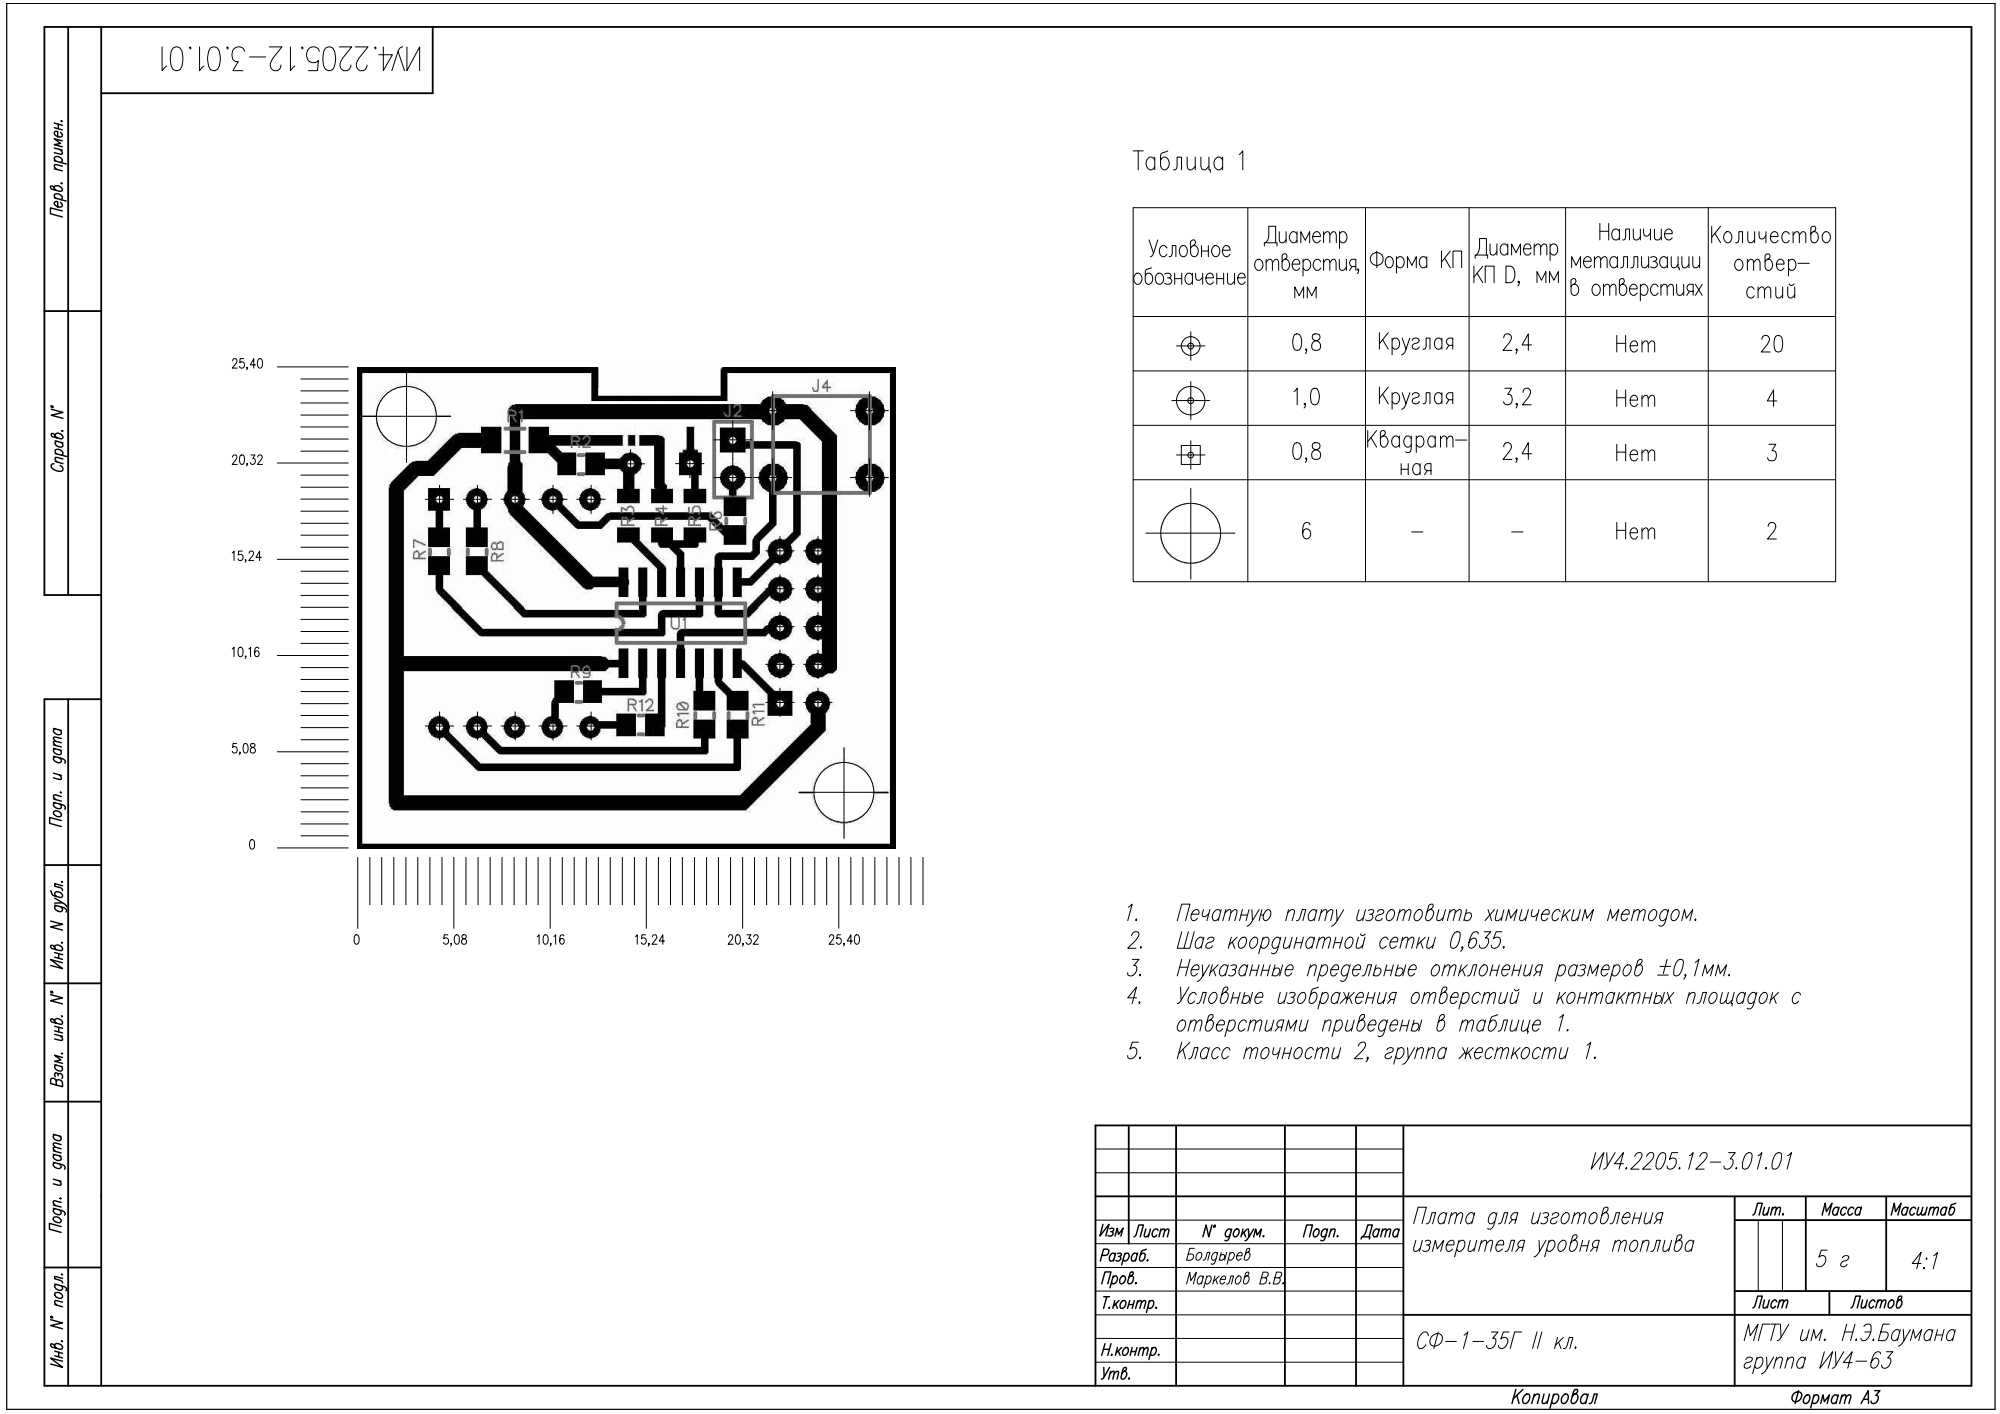
[picture p101: page 1]
