MBoldyrev/kurs_mark/Inventor/plots/pdf/PP1SB.pdf

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

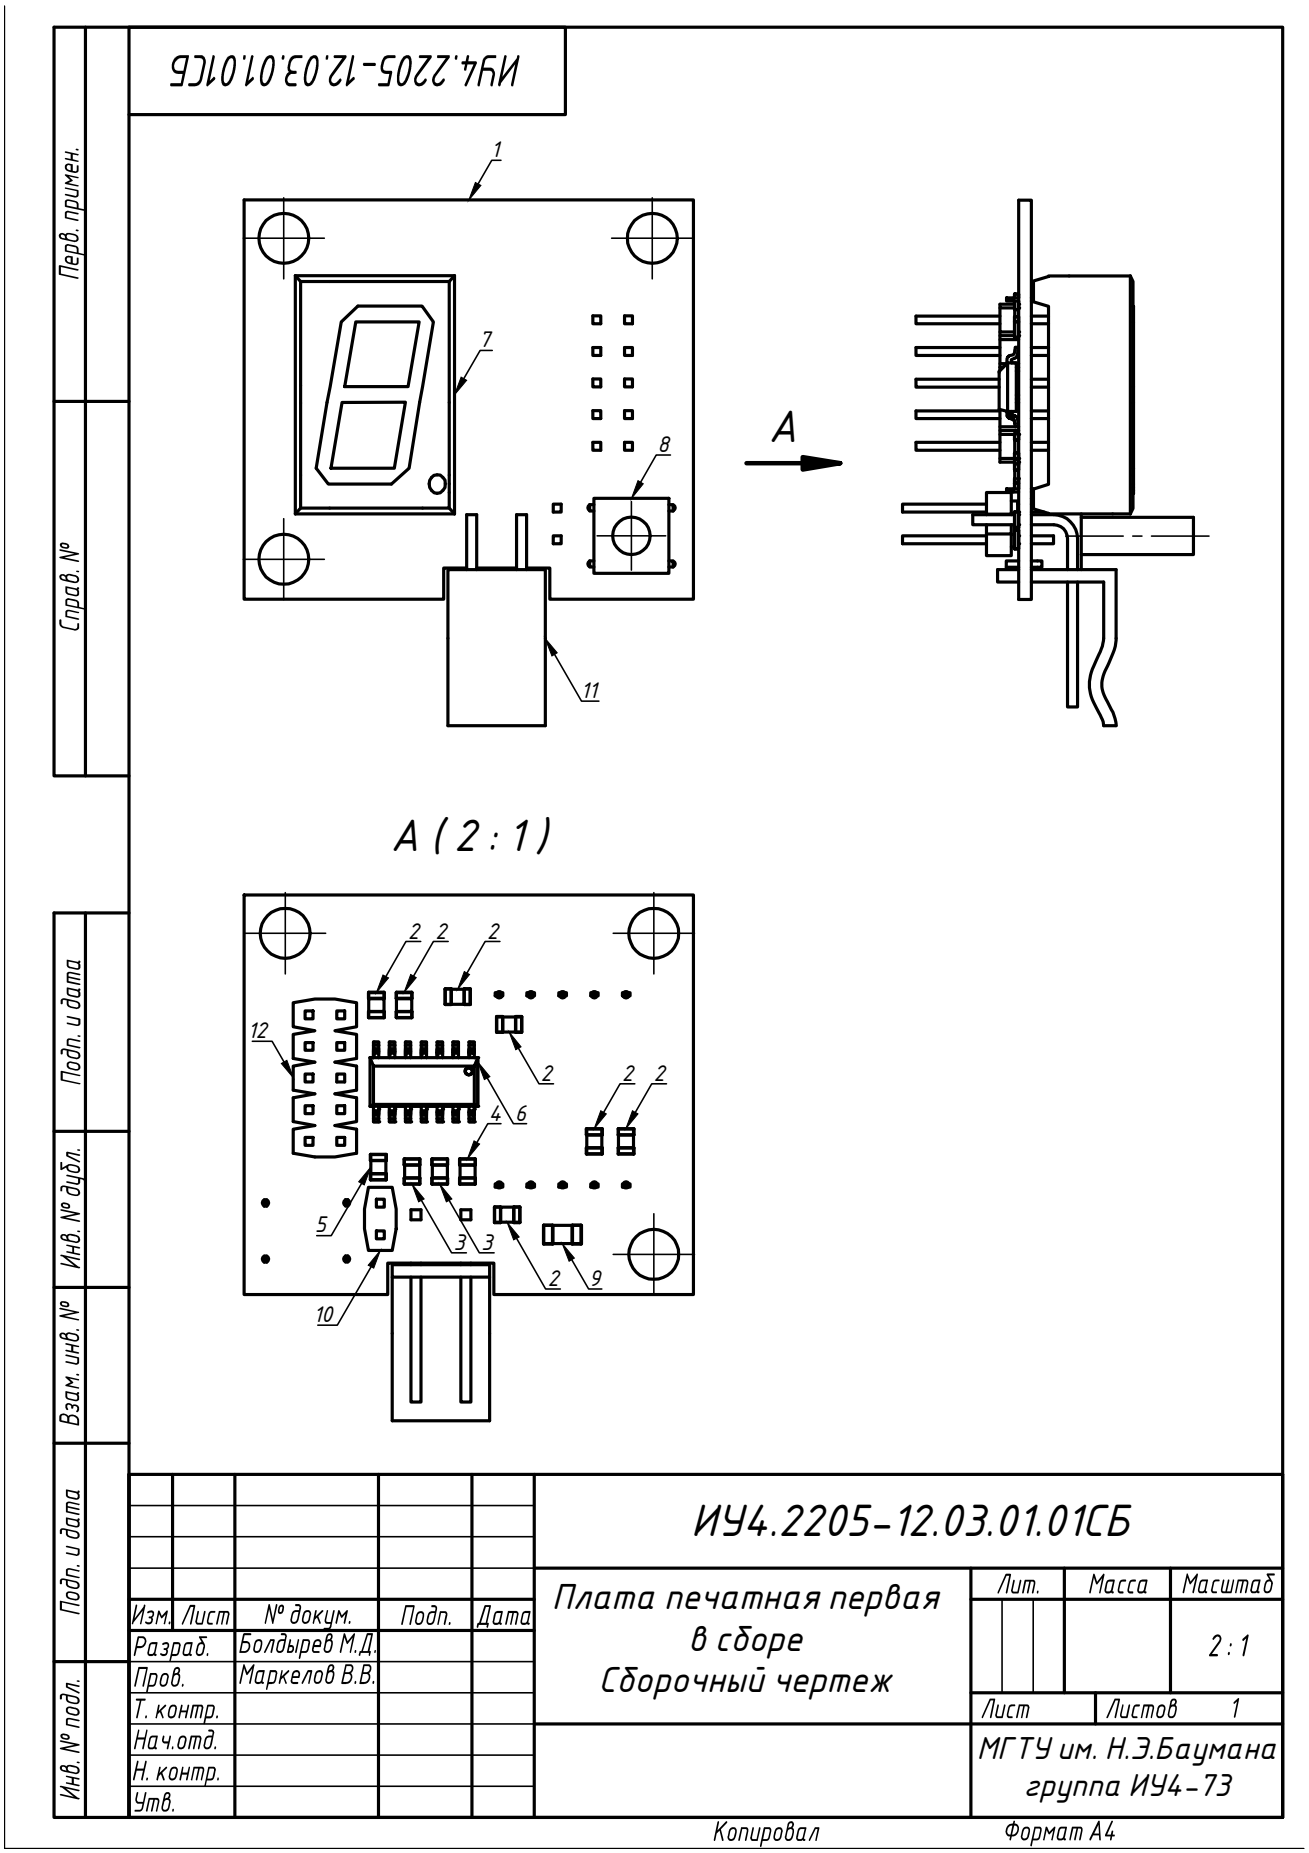
[picture p103: page 1]
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
