MBoldyrev/kurs_mark/(list of files, drawings)

Other design files:
DipTrace/fuel_level_1.dip
