MBoldyrev/kurs_mark/(commit log)

2015-12-08 rendered pics and changed bottom case hole diam
    [all.0002.iam, all.0003.iam, all.iam, case_bottom.0026.ipt, case_bottom.0027.ipt, case_bottom.ipt, dat4.0006.ipt, dat4.0008.ipt]
2015-12-14 added plots and pdf folders
    [all_sb.dwg, all_vo.dwg, ext_SB.dwg, ext_VO.dwg, внеш.ВО.dwg, внеш.СБ.dwg]
2015-12-14 rm old plots
    [внеш.ВО.dwg, внеш.СБ.dwg]
2015-12-14 rename ext iam
    [ext.iam]
2015-12-22 1817 corr dwg
    [KD.dwg, PP1SB3.0003.dwg, PP1SB3.0005.dwg, PP1SB3.dwg, case_bottom.0010.dwg, case_bottom.0011.dwg, case_bottom.dwg, case_top.0007.dwg]
2015-12-22 corrected dwg and pdf
    [KD.dwg, PP1SB3.0005.dwg, PP1SB3.0006.dwg, PP1SB3.dwg, case_bottom.0011.dwg, case_bottom.0012.dwg, case_bottom.dwg, case_top.0008.dwg]
2015-12-22 2009 bmstu final
    [KD.dwg]
2015-12-23 1113 corr PP1
    [KD.dwg]
